basil2fxs/Hand-Rehab-Thesis/README.md

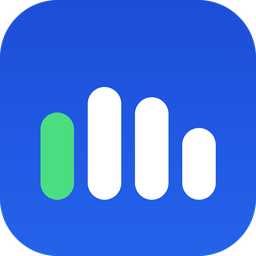
[picture p1: app/assets/icons/app_icon_256.png]
Finger Rehab icon

<h1 align="center">Finger Rehab</h1>
<p align="center">A hand device and a game for Windows and macOS that measure and train finger movement.<br>Four force pads, four vibration motors and an Arduino Nano. Ten games. Every press is logged with its time and force.</p>
<p align="center"> </p>
<p align="center"><a href="#install">Install</a> &middot; <a href="#the-ten-games">Games</a> &middot; <a href="#troubleshooting">Troubleshooting</a> &middot; <a href="#data">Data</a> &middot; <a href="#the-lab-folder">Lab folder</a> &middot; <a href="app/README.md">Working on the code</a></p>
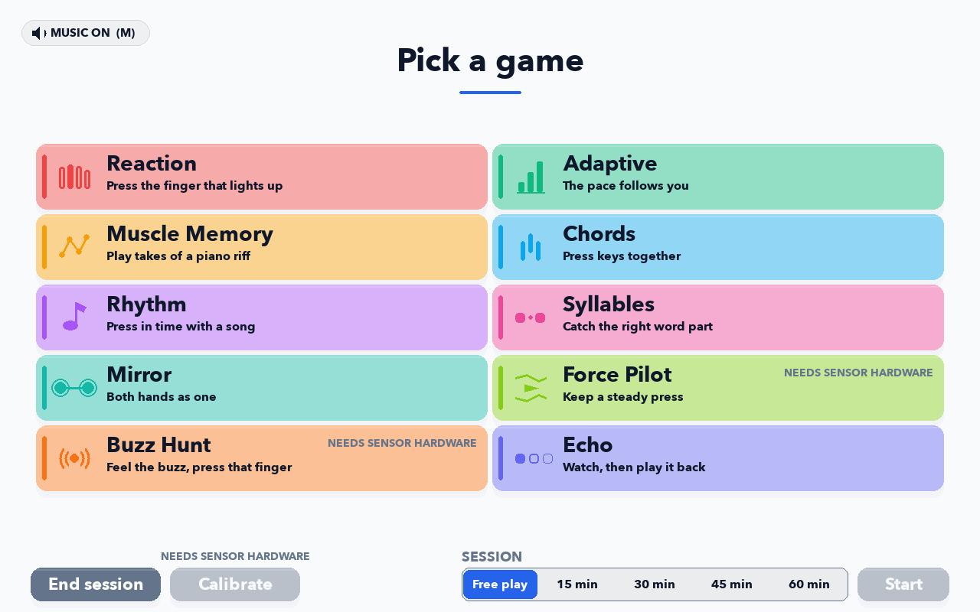
[picture p2: app/docs/images/hub.png]
The hub, where each game is picked


## Where things are

```text
Hand-Rehab-Thesis/
|
|-- Installers/               The Windows and macOS installers, from the latest release
|
|-- EEG_Lab/                  The folder that goes on the EEG lab computer
|   `-- developer/            EEG simulator and set-up tools. Not needed on the lab PC
|
|-- FINAL TRIAL RESULTS/      The study: what to run, and where each result goes
|
|-- thesis/                   The thesis and the IEEE paper, as submitted
|
|-- analysis/                 The notebook and scripts that turn sessions into results
|
|-- app/                      The game
|   |-- main.py               Starts it
|   |-- finger_rehab/         The code: games, screens, boards, data logging
|   |-- config/               Settings files (eeg_lab.yaml turns on the lab's markers)
|   |-- assets/               Board firmware, icons, music, speech and word lists
|   |-- arduino/              Source code of the board firmware
|   |-- docs/                 Study-day forms, research notes, screenshots
|   |-- scripts/              Tools run by hand: device checks, simulations, lab sync
|   |-- tests/                Automated tests
|   `-- builds/               Scripts that build the installers
|
|-- hardware/                 Build the device: parts, wiring, pins, CAD and print files
|-- archive/                  Old material kept for reference. The game doesn't use it
|-- sessions/                 Recorded data (not uploaded to GitHub)
`-- Local_Runner.command      Runs the game straight from the code on a Mac
```

Each folder has its own README with more detail. To change the software, start at [app/README.md](app/README.md), then read [app/finger_rehab](app/finger_rehab) for how the parts fit together and [app/finger_rehab/game/modes](app/finger_rehab/game/modes) for the games. The results are in [analysis](analysis) and [FINAL TRIAL RESULTS](FINAL%20TRIAL%20RESULTS), the device is in [hardware](hardware) and [app/arduino](app/arduino), and the written work is in [thesis](thesis).

## How it works

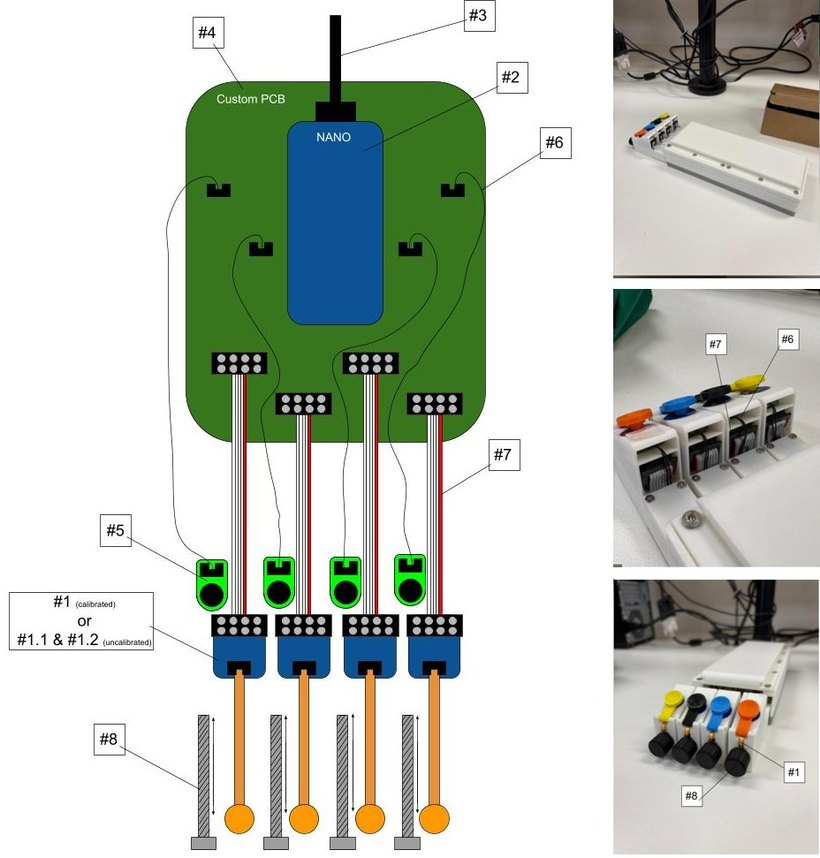
[picture p3: app/docs/images/device.jpg]
The hand device: a drawing of the board and pads, and three photos of the build
<p align="center"><br><sub>The device. Parts are numbered in <a href="app/arduino">app/arduino</a>.</sub></p>

```mermaid
flowchart LR
  H["Fingers on four pads"] --> S["SingleTact 10 N sensors<br>I2C 0x05 to 0x08"]
  S --> A["Arduino Nano<br>200 Hz"]
  A -->|"FSR: a,b,c,d"| G["The game"]
  G -->|"STIM:n"| A
  A --> M["Four vibration motors"]
  G --> F["sessions/<br>trials.csv, raw.csv, metadata.json"]
  F --> N["analysis/session_analysis.ipynb"]
```

The Nano reads the four pads 200 times a second and sends each reading over USB as a line of text. The game turns those numbers into presses, picks the next finger to cue and sends `STIM:n` back to buzz finger n. Every sample and every event goes into a session folder, which the notebook reads.

There's no switch under the fingers. Each pad keeps a slow baseline, and a press counts when the force crosses a trigger set 30% of the way from that person's resting level to their light press, both measured at login. That's what lets a weak finger register. With one fixed threshold, a little finger just resting on its pad kept setting off presses. The 30% can be changed in Settings, Setup, Press point.

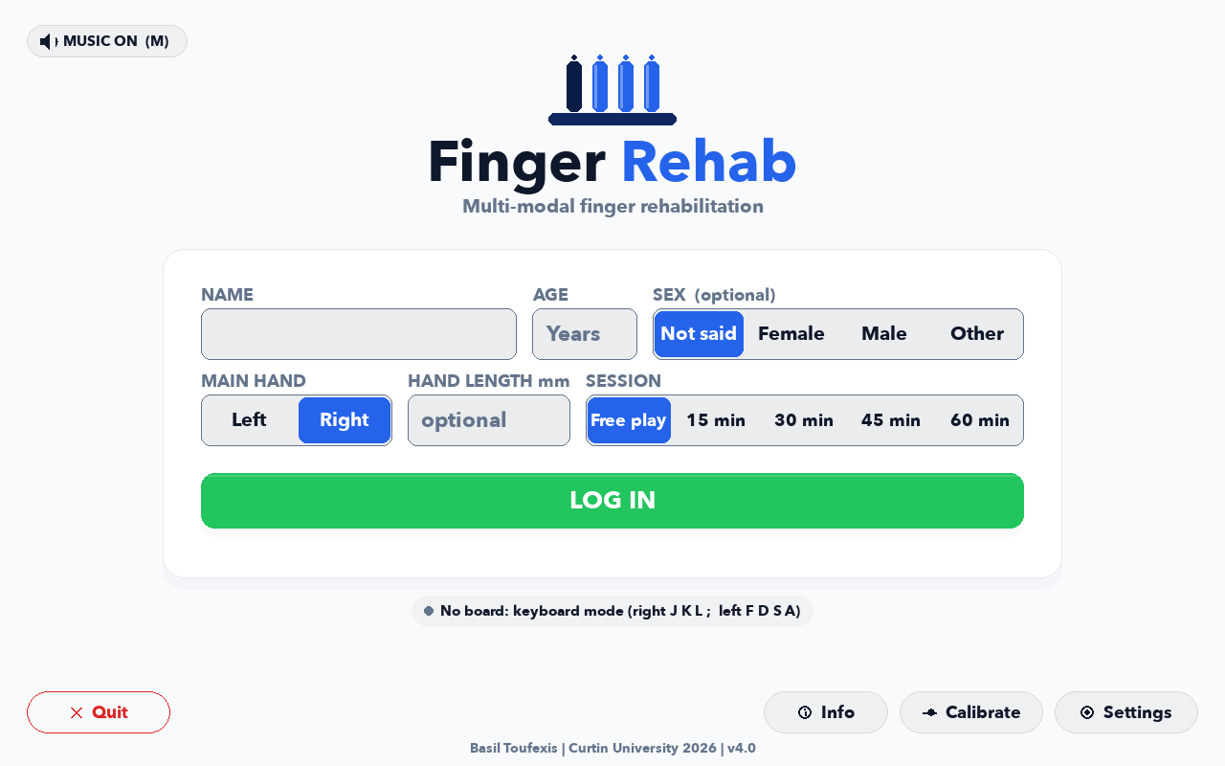
[picture p4: app/docs/images/login.png]
The login screen
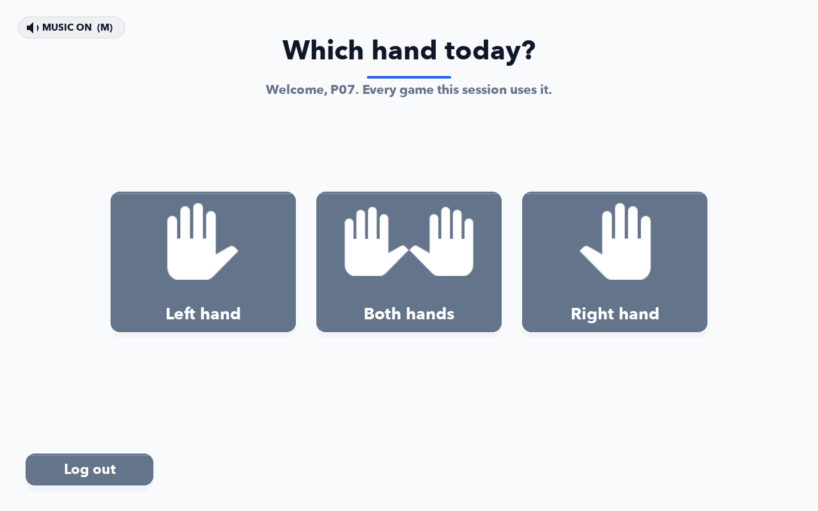
[picture p5: app/docs/images/hand.png]
The hand choice screen
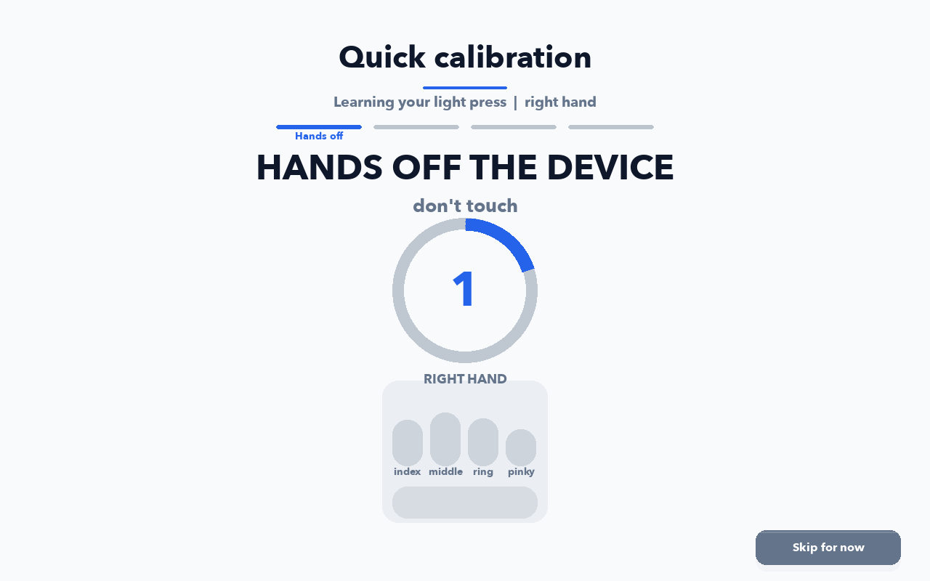
[picture p6: app/docs/images/calibration.png]
The quick calibration
<p align="center">  <br><sub>Log in (free play, or a timed session of 15 to 60 minutes), pick the hand, calibrate. The game menu has the same session picker.</sub></p>

## Timing and limits

- **Sensing:** each pad reads 0 to 10 N in 512 steps, about 20 mN a step. The Nano reads all four every 5 ms (199 Hz measured) and sends them over USB in bursts, so a sample arrives about 10 ms late, up to 20 ms; the notebook can re-time presses on the board's own clock.
- **Presses:** a press counts on the second raw sample in a row over the trigger, 5 ms after the raw force crosses it, so one noisy sample can't count. Sessions before 3 November 2026 counted on the smoothed force, a sample or two later (`analysis/count_rule_replay.py` compares the two). A slow push is counted later (`analysis/detector_lag_vs_rise.py`).
- **Screen and sound:** a cue shows on the next 60 Hz frame, up to 17 ms later. On the study computer a sound was heard 77 to 87 ms after the game played it and a buzz felt 74 ms after its command; measure each computer with Settings, Setup, Audio delay.
- **EEG markers:** a stimulus byte goes out on the frame that draws the stimulus, a press byte up to one frame after its sample, and `events.tsv` moves each press back to its sample and to where the push began. The lab checklist is in [app/docs/eeg_lab_setup.txt](app/docs/eeg_lab_setup.txt).

## Install

- **Windows:** run [`FingerRehab-Setup-Windows.exe`](https://github.com/basil2fxs/Hand-Rehab-Thesis/releases/latest/download/FingerRehab-Setup-Windows.exe). It doesn't need administrator rights. SmartScreen will say "Windows protected your PC": click More info, then Run anyway.
- **macOS:** open [`FingerRehab-macOS.dmg`](https://github.com/basil2fxs/Hand-Rehab-Thesis/releases/latest/download/FingerRehab-macOS.dmg) and drag Finger Rehab to Applications. The first time it's opened, allow it in System Settings, Privacy & Security, Open Anyway.

Neither installer is signed, which is why each one asks for permission the first time. Both are on the [latest release](https://github.com/basil2fxs/Hand-Rehab-Thesis/releases/latest), built and tested from the same commit. To run from source instead, see [app/README.md](app/README.md). If there's no board, the keyboard can be used instead: `J K L ;` for the right hand, `F D S A` for the left.

## When a board is plugged in

The game opens within a second, because a watcher installed at first launch checks the ports once a second. If the board was already plugged in when the computer started, unplug it and plug it back in. The watcher isn't installed when the game is run from source or straight off the disk image, and the lab build doesn't install it either. Once the game is open, a board plugged in at the login, on the hub or in Settings connects automatically, and one plugged in mid-game connects when that game ends.

## The ten games

<table>
<tr>
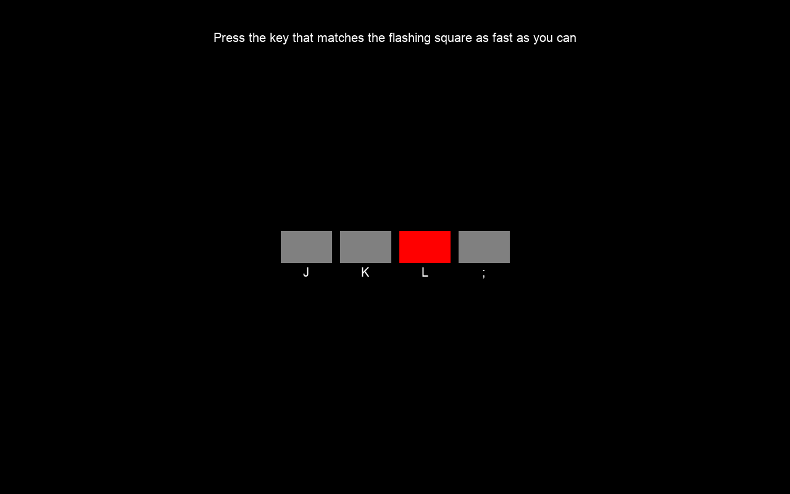
[picture p7: app/docs/images/reaction.png]
Reaction
<td align="center" width="33%"><br><sub><b>Reaction</b></sub></td>
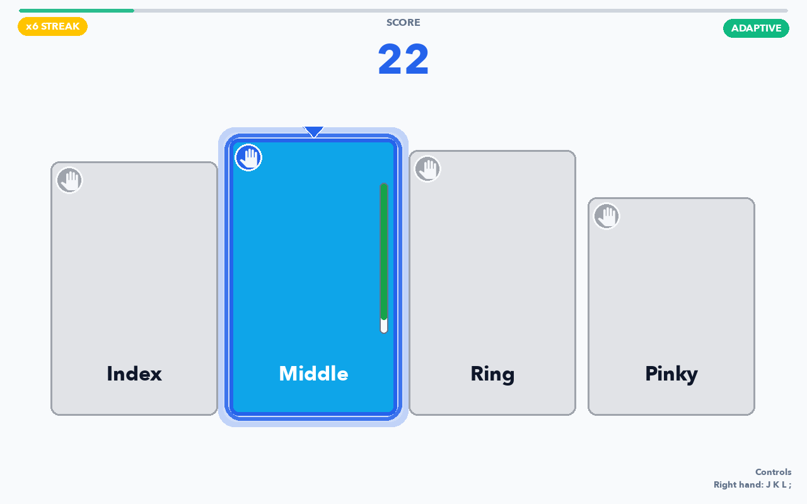
[picture p8: app/docs/images/adaptive.png]
Adaptive
<td align="center" width="33%"><br><sub><b>Adaptive</b></sub></td>
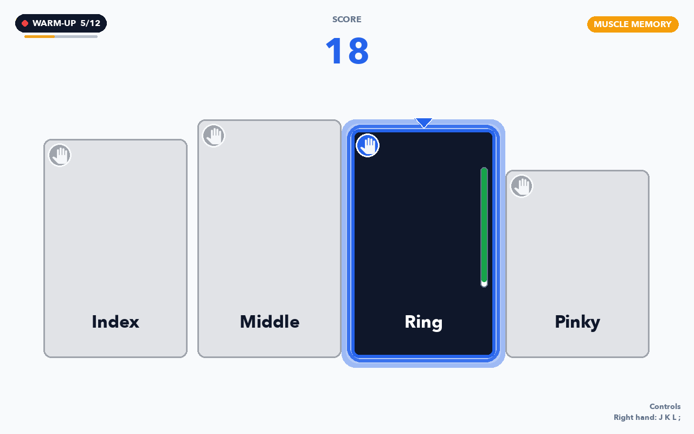
[picture p9: app/docs/images/muscle_memory.png]
Muscle Memory
<td align="center" width="33%"><br><sub><b>Muscle Memory</b></sub></td>
</tr>
<tr>
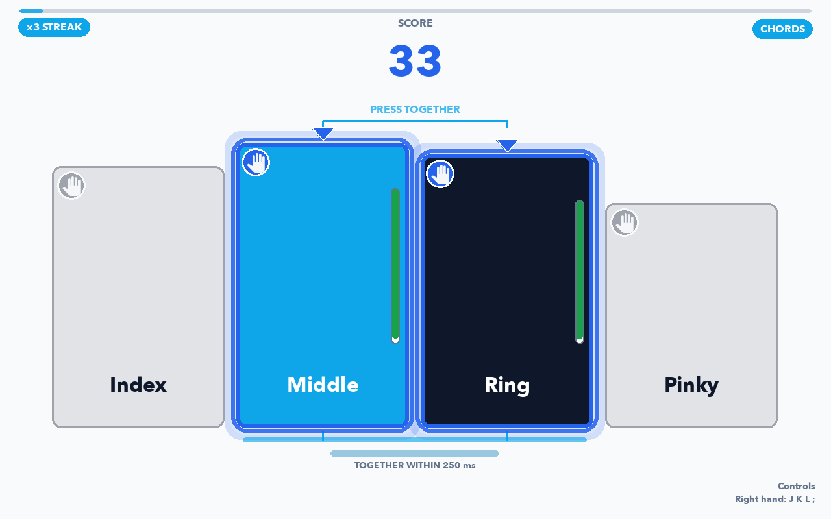
[picture p10: app/docs/images/chords.png]
Chords
<td align="center" width="33%"><br><sub><b>Chords</b></sub></td>
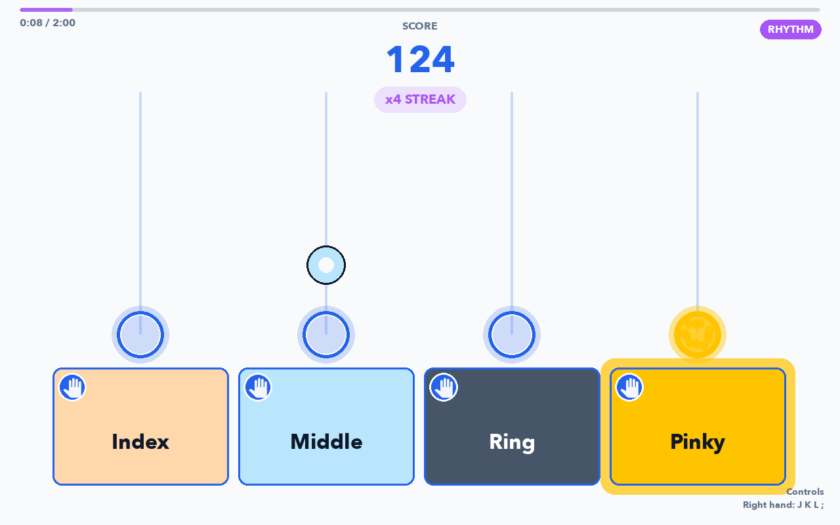
[picture p11: app/docs/images/rhythm.png]
Rhythm
<td align="center" width="33%"><br><sub><b>Rhythm</b></sub></td>
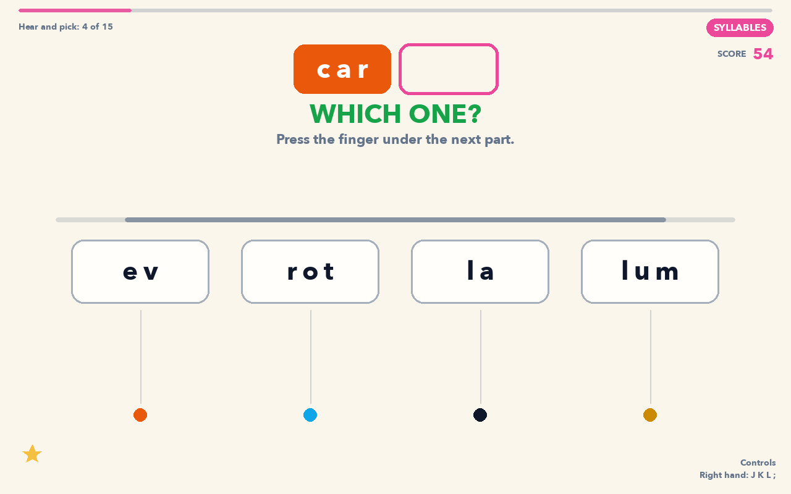
[picture p12: app/docs/images/syllables.png]
Syllables
<td align="center" width="33%"><br><sub><b>Syllables</b></sub></td>
</tr>
<tr>
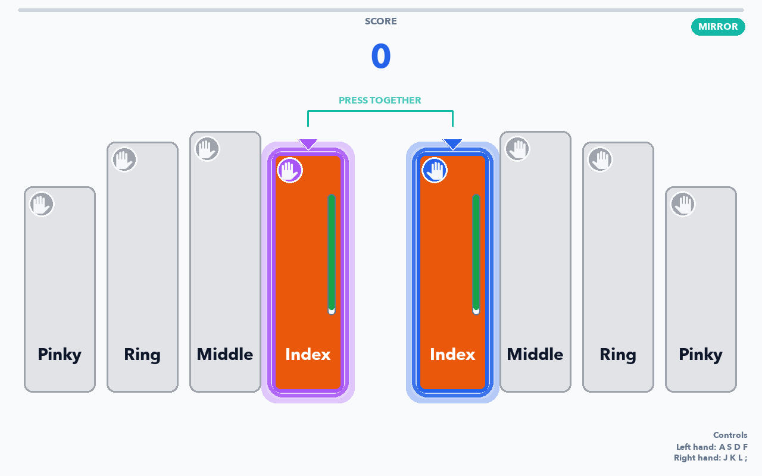
[picture p13: app/docs/images/mirror.png]
Mirror
<td align="center" width="33%"><br><sub><b>Mirror</b></sub></td>
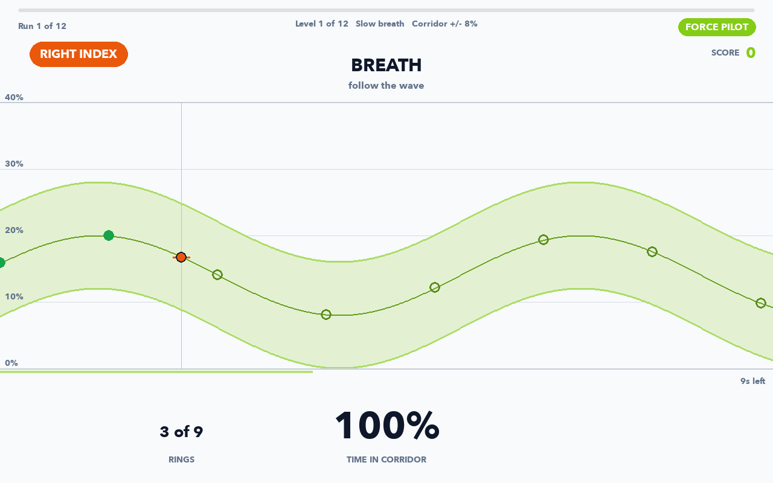
[picture p14: app/docs/images/force_pilot.png]
Force Pilot
<td align="center" width="33%"><br><sub><b>Force Pilot</b></sub></td>
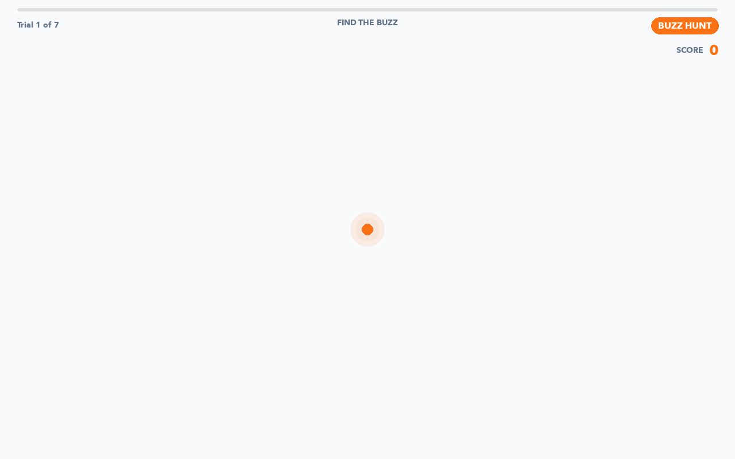
[picture p15: app/docs/images/buzz_hunt.png]
Buzz Hunt
<td align="center" width="33%"><br><sub><b>Buzz Hunt</b></sub></td>
</tr>
<tr>
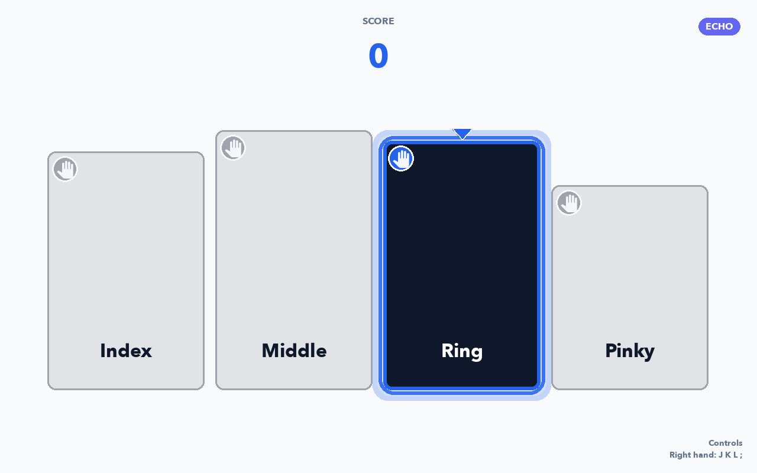
[picture p16: app/docs/images/echo.png]
Echo
<td align="center" width="33%"><br><sub><b>Echo</b></sub></td>
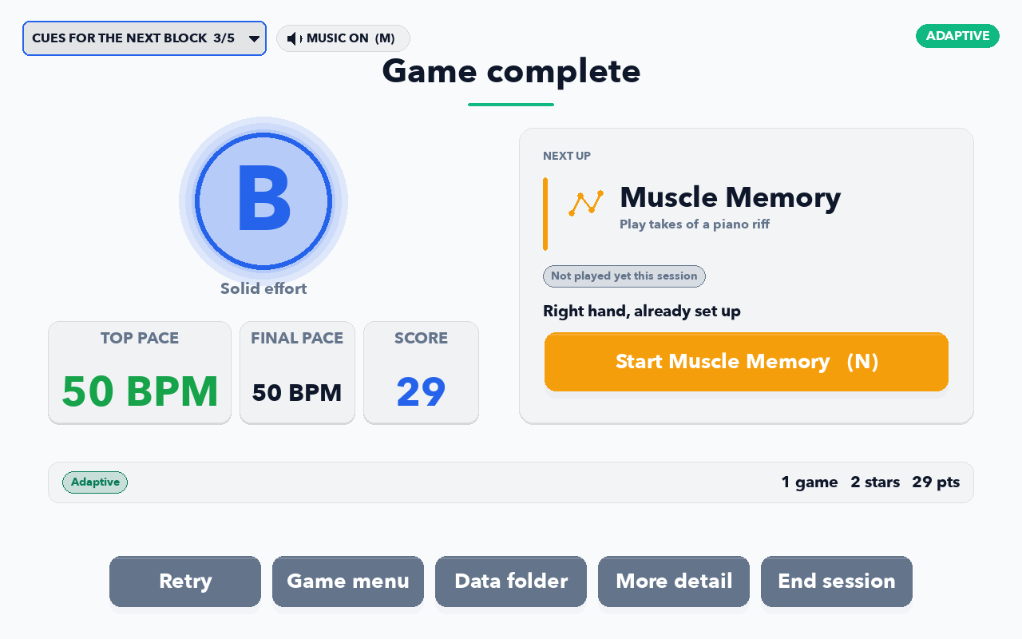
[picture p17: app/docs/images/results.png]
Results
<td align="center" width="33%"><br><sub><b>Results</b>, after every game</sub></td>
<td align="center" width="33%"></td>
</tr>
</table>

| Game | What the player does, and what it measures |
| --- | --- |
| **Reaction** | The lab's sequence task: press the finger whose card lights up. Sequence learning. |
| **Adaptive** | Press the finger whose lane lights up, at a pace that follows the player. Speed at a held difficulty. |
| **Muscle Memory** | Play a piano riff, take after take. Learning of a repeated sequence. |
| **Chords** | Press two to four fingers at once. Moving fingers together, holding the rest still. |
| **Rhythm** | Press on the beat of a song. Timing error against the beat. |
| **Syllables** | Catch the right part of a spoken word. Reading by sound. |
| **Mirror** | Press the same finger on both hands at once. How well the hands stay together. |
| **Force Pilot** | Keep a press on a moving line. Steady control of force. |
| **Buzz Hunt** | Feel which finger buzzed, then press it. The sense of touch. |
| **Echo** | Watch a sequence light up, then repeat it back. Memory span. |

Each game's file starts with the research behind it, and its settings are under its key in `app/config/default.yaml` (Muscle Memory is `pattern`, the Reaction card is `srt`). For how a game is put together and how to add one, see [app/finger_rehab/game/modes](app/finger_rehab/game/modes).

## Settings

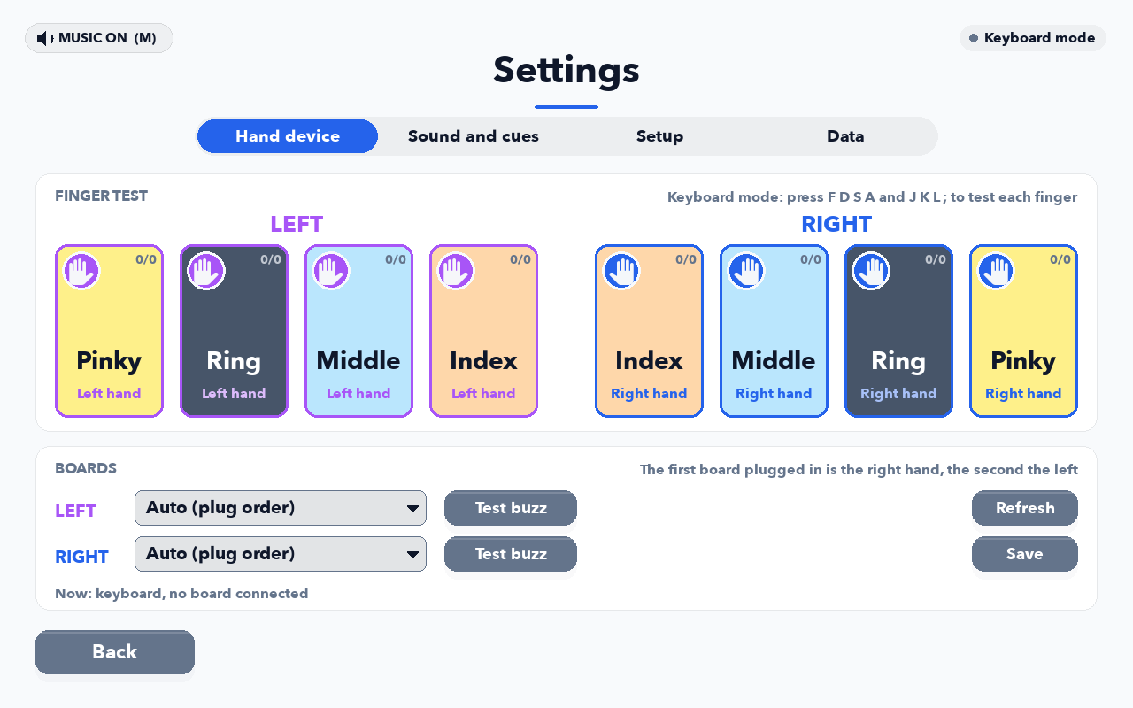
[picture p18: app/docs/images/settings.png]
The Settings screen


Open Settings with the cog on the login screen. It has four tabs: Hand device (the finger test, which board is which hand, a test buzz), Sound and cues (levels and cue switches), Setup, and Data (the data folder, the Muscle Memory riff, Test Mode). These are the Setup jobs (the flashing notes are in [app/arduino](app/arduino)):

- **Auto-start:** opens the game when the board is plugged in. The switch shows on or off, and once it's turned off the game leaves it off.
- **Flash firmware:** writes the game firmware to the board with the avrdude bundled in the app. It takes about ten seconds.
- **Sensor address:** moves one SingleTact to a new I2C address. Only that sensor should be connected while it runs.
- **Audio delay:** run it once on each computer. It times the computer's sound and buzz with the microphone so Rhythm stays on the beat. It takes about two minutes in a quiet room with the board plugged in, and on Windows it asks for taps on the index pad.

On Windows, Setup also has USB driver, which gets a board's missing driver from Windows Update. Anything changed on this screen is saved to `config/user_settings.yaml` beside the app and applied on top of `default.yaml`, which lists every setting with the reason for its value. [app/config](app/config) explains how the files are layered.

## Troubleshooting

**A sensor reads nothing, or sits at zero.** A failed read is sent as 0, so a loose lead, a dead pad and a pad on the wrong address look the same. Reseat both ends of the lead, then use Settings, Setup, Sensor address, Scan to see which addresses answer.

**A sensor drifts, or reads high at rest.** A pad squashed by the strap leaves too little room between resting and pressing, and calibration is refused when there's under 20 counts of travel. Lay the pad flat again and recalibrate.

**The board is not found, or the port keeps changing.** The first board found is used as the right hand and the second as the left. To fix a board to a hand, go to Settings, Hand device, pick the port for each hand and press Save. If a saved port no longer exists, the game goes back to plug order. On Windows, a board that never shows up at all usually has no driver yet, so run Settings, Setup, USB driver.

**Calibration is asked for every time.** It's meant to be asked for once per hand in each session. If it comes up again inside one session, the profile was refused: under 20 counts of travel, a trigger too high, or a pad reading zero when empty.

**A buzzer does not buzz.** Settings, Hand device, Test buzz runs that hand's motors one after another, and clicking a finger tile buzzes just that finger. If none of them buzz on a board that's sending readings normally, the fault is in the wiring, not the software. If there's no buzz before a cue, the cue is switched off in Sound and cues.

**Presses register on the wrong finger.** Two pads are answering on the same I2C address. Fix it in Settings, Setup, Sensor address, with only that sensor connected: 0x05 index, 0x06 middle, 0x07 ring, 0x08 pinky. Never move a sensor off 0x04 while the others are wired in.

**The game does not open when the board is plugged in.** Go to Settings, Hand device and press Refresh. If the board isn't listed, the problem is the lead or the driver (Setup, USB driver). If it is listed, check that Auto-start says on. It only triggers when a board is plugged in, so unplug the board and plug it back in.

**The board needs re-flashing.** Settings, Setup, Flash firmware writes `app/assets/firmware/finger_rehab_nano.hex` with the bundled avrdude. A Nano has one of two bootloaders, so the app tries both and remembers which one worked.

**The game runs but no data is saved.** Settings, Data, Open data folder opens the folder being used, which is `~/Finger Rehab Data` when the app can't write next to itself. Check that Test Mode is off (`game.test_mode_enabled`), because it cuts every block to six trials.

**The EEG box does not appear.** Markers are switched off in the released game. `app/config/eeg_lab.yaml` turns them on, and it's loaded from beside the lab exe or with `--config config/eeg_lab.yaml` from source. Set `eeg.port` to the box's port. If the box isn't found at launch, the game listens for a few seconds and picks the one USB port that sends no force stream, and it leaves the port list on screen in case that needs changing. With `eeg.require_port` set to true the game won't start without a box, and with false it only logs the markers. Leave `eeg.baud` at 9600: 1200 would reset the box, so the game refuses it.

**Sessions look empty in the notebook.** The notebook looks for `trials.csv` in the first `sessions` folder it finds, beside it or up to four levels above. If the notebook has been copied somewhere else, set `SESSIONS_DIR` in the Setup cell.

## Data

Each game gets its own folder, `sessions/<date>/<login>_<time>_<game>/`. Nothing is overwritten: a second folder with the same name gets `_1` on the end.

- `trials.csv`: one row per trial, with the finger cued, the reaction time, the peak force in newtons and which cue switches were on.
- `raw.csv`: every 200 Hz sample, with the presses, releases, cues and EEG markers as event rows on the same clock.
- `metadata.json`: the block summary, the calibration the block ran under, a copy of the config and the software version.
- `report.html`, `summary.csv` and `charts/` for a quick look, and for EEG blocks `events.tsv` and `markers_codes.csv`.

The folder name includes the login name, so run `app/scripts/deidentify_sessions.py` before copying any data off the computer. To analyse a session, open [`analysis/session_analysis.ipynb`](analysis), run the Setup cell, pick a save and press Run All. [app/finger_rehab](app/finger_rehab) describes every column and how the files are written.

## The lab folder

`EEG_Lab` (also released as `FingerRehab-EEGLab.zip` from the same build) contains the exe, `eeg_lab.yaml`, `run_in_psychopy.py`, `README.md`, a `source/` copy and `sessions/`. ActiView's recording goes in `sessions/eeg/` under the name shown on the game menu, and is copied in from the EEG PC when ActiView runs there. The `developer/` folder isn't needed at the lab, so leave it on the development PC: it has an EEG simulator for rehearsing, the PsychoPy download and a check for a new PC.
To start it, open `run_in_psychopy.py` in PsychoPy Coder and press Run. The markers are switched off in every other build.
`python3 app/scripts/check_lab_sync.py` checks that the lab folder has the same version of the game as the app. Adding `--fix` updates it, and `Local_Runner.command` does this every time it starts.
[EEG_Lab/README.md](EEG_Lab/README.md) has a picture showing what each marker number means, [EEG_Lab/developer](EEG_Lab/developer) explains how the folder is built and how the markers are made, and [app/docs/eeg_lab_setup.txt](app/docs/eeg_lab_setup.txt) has the checklist and code table.

## Licence

This is thesis work by Basil Toufexis at Curtin University, 2026. Please ask before reusing the code. It builds on Satoru Nakayama's 2025 software and keeps its serial protocol and press detection, so the old patient data still loads. Third-party licences are kept with the files they cover: [music](app/assets/music/ATTRIBUTION.md), [icons](app/assets/icons/LICENSE), [words](app/assets/words/LICENCE.txt), [avrdude](app/tools/avrdude).
