basil2fxs/Hand-Rehab-Thesis/app/docs/README.md

# docs

The written side of the project: how a study day runs, why each game is built the way it is, and how the EEG lab is set up. None of it is code.

| Path | What it is |
| --- | --- |
| [`study_day/`](study_day) | The collection-day kit: run sheet, consent, intake, debrief |
| [`research/`](research) | The study design and the research behind each game, with sources |
| [`eeg_lab_setup.txt`](eeg_lab_setup.txt) | The EEG lab checklist: the wiring from game to amplifier, the steps at the lab PC, the marker code table, the timing checks |
| [`code_review_2026-09-27.md`](code_review_2026-09-27.md) | The line-by-line review held before any participant: every fault it found, by game, and what it would have done to the data |
| [`pattern_sequences/`](pattern_sequences) | Example Muscle Memory sequence files; drop one on the game window to load it |
| [`images/`](images) | The pictures the READMEs show, from `scripts/make_screenshots.py` and `scripts/make_eeg_cheat_sheet.py` |
| [`Guide for Hand Rehabilitation Device.docx`](Guide%20for%20Hand%20Rehabilitation%20Device.docx) | The earlier hardware guide: wiring the SingleTact boards and setting their addresses with the Arduino IDE, a job Settings, Setup, Sensor address now does |

Flashing the board: [`../arduino`](../arduino). Building the device: [hardware](../../hardware).
