basil2fxs/Hand-Rehab-Thesis/app/docs/study_day/run_sheet.md

# Run sheet, one participant

Booked for the longest length the student can give: an hour for the
45 (75 minutes for the 60), less for the 30 or 15. About 15 minutes
of it is welcome, paperwork and debrief. Tick as you go; anything unusual goes in the
notes box on the intake sheet.

## Between participants (2 min)

- [ ] Wipe the pads and the frame with an isopropyl wipe.
- [ ] Board plugged in and the app on the title screen. On the lab
      PC, start Finger Rehab from the Start menu; on the Mac, with
      `Local_Runner.command` (double-click). Give the board about
      three seconds after it opens: it buzzes each finger once as it
      starts up.
- [ ] New intake sheet, information sheet and consent form on the
      clipboard.

## Welcome and paperwork (10 min, clock not running)

- [ ] Give the information sheet. Let them read it and ask questions.
- [ ] Consent form signed. No signature, no session.
- [ ] Assign the next code in order of consent: P01, P02 and so on.
      Write it on the intake sheet and the consent form. The code is
      the only link to their name, and the consent forms are kept
      apart from everything else.
- [ ] Intake sheet: age, sex, the four Edinburgh questions (they tick
      the boxes themselves), caffeine in the last 2 hours, hours of
      sleep, any hand pain or injury today (if yes, thank them and
      stop: they cannot take part today).
- [ ] Measure the RIGHT hand with the ruler: length from the wrist
      crease to the tip of the middle finger. Millimetres.

## Seat and log in (5 min)

- [ ] Hands washed or sanitised. Offer finger cots.
- [ ] Seat height so the forearm rests flat and the fingers sit index
      to little on the four pads, thumb off the frame.
- [ ] Say once: "This runs about three quarters of an hour, all on
      your right hand, with a short stretch early on and a proper
      break later, after which four of the games come round again.
      Press lightly, like typing. Some games have a hidden rule; don't
      try to work it out, just play."
- [ ] Say once: "After each game the screen shows how your last few
      goes compared with your first few." Don't repeat it and don't
      comment on scores during the session.
- [ ] Login screen: type the code in NAME, then age, sex and hand
      length. SESSION: the longest length the slot allows, 60 (a 75
      minute slot), 45 (an hour), then 30, then 15.
- [ ] MAIN HAND: ask "Which hand do you write with?". Right is picked
      to start with; click Left (or press L) for a left-hander. This is
      their real handedness, recorded for the analysis. It does not
      change the device.
- [ ] LOG IN. The app puts the board on the right hand, the device
      hand for everyone, left-handers included.
- [ ] Quick calibration opens by itself: hand off, hand resting, then
      one light press per finger. If a finger fails, redo it once,
      then carry on and note it.

## The session (about 44 minutes on the rig for the 45)

- [ ] The first game starts after the calibration. After each game
      press Start on the NEXT UP card (or N). The strip shows SESSION
      k/12 on the 45 and the minutes: amber past the length, red past its hard
      stop (18, 35, 50 or 65 minutes). Every length plays the same
      full-length games: the 15 four of them once, the 30 all eight
      once, the 60 every game twice (docs/research/trial_mode.md).
- [ ] The first time each game comes up, say its line once before it
      starts.
      Order A starts Reaction as soon as the calibration ends, so say
      its line as the calibration finishes.
      Reaction: "When a finger lights up and buzzes, press that finger
      as fast as you can. Sometimes nothing comes: keep still."
      Rhythm: "Press each finger as its ball reaches the ring, in time
      with the music. The buzz and the tone come at that moment, so
      don't wait for them."
      Echo: "Watch the lights, then press the same fingers in the same
      order. Each round adds one more to the end of the same pattern.
      Speed doesn't count. If you're not sure, make your best guess."
      Force Pilot: "First, three presses with each finger, as hard as
      is comfortable. Then keep your line on the centre line as the
      wave scrolls past; the band is how far you can drift." Order B
      starts the sitting with Force Pilot, so say it as the
      calibration finishes.
      Chords: "Press the lit fingers together and hold until the ring
      fills. Keep the other fingers resting still on their pads."
      Buzz Hunt: "When a finger buzzes, press that finger as fast as
      you can. Sometimes nothing buzzes: keep still. At the end the
      pads play a short pattern: when it stops, press the same fingers
      in the same order."
      Muscle Memory: "Press each finger as it lights up, as quickly and
      accurately as you can." Say nothing about a pattern or a riff.
      Adaptive: "Press the finger that lights up, before its bar runs
      out. Keep up and it speeds up; it eases off when you need it."
- [ ] Don't coach during a game. Let them skip a game's own rest
      (Space) only when they say they're ready.
- [ ] Don't pause a Rhythm game. If one pauses, Retry it from the
      results screen: the song resumes from a re-seek and its timing
      can shift, so a paused block stays out of the Rhythm checks.
- [ ] If the NEXT UP card says the audio delay is not measured, stop
      and run Settings, Setup, Audio delay before Rhythm.
- [ ] Tick each game on the intake sheet as it ends.

The order comes from the code, and every game is the right hand:

| Step | Order A (odd codes) | Order B (even codes) |
|---|---|---|
| 1 | Reaction | Force Pilot |
| 2 | Rhythm | (60 s stretch) Chords |
| 3 | Echo | Buzz Hunt |
| 4 | (60 s stretch) Force Pilot | Adaptive |
| 5 | Chords | Reaction |
| 6 | Buzz Hunt | Rhythm |
| 7 | Adaptive | Pattern |
| 8 | Pattern | Echo |
| rest | 3 minutes | 3 minutes |
| 9 | Reaction | Force Pilot |
| 10 | Rhythm | Chords |
| 11 | Force Pilot | Reaction |
| 12 | Chords | Rhythm |

Syllables is not in the sitting. It is built for readers with
dyslexia and is played with a dyslexic participant on its own, from
the hub.

### At the 3 minute rest

- [ ] Hands off the pads, water offered. Don't talk about the games.
- [ ] Ask, and write the numbers with the clock time:
      "Tired in the head?" 0 to 10.
      "Tired in the hands?" 0 to 10.
- [ ] Take the full 3 minutes. The Start button unlocks after 1 minute
      and reads "Start early"; only use it if they ask to go on, and
      write down that the rest was cut short. The reliability numbers
      are measured across this gap.
- [ ] Pass 2 is four of the games again. Don't say they are
      repeats and don't mention the first scores.

### If something goes wrong

- Board drops between games: the card says "Waiting for the board".
  Replug it, wait for the buzz, press Start. Note the step.
- Force Pilot or Buzz Hunt refuses to start: the board is not live.
  Same fix.
- Force Pilot goes straight back to the menu after MAX PRESS CHECK,
  with a note under the header: no press came in 25 seconds, so
  nothing was measured and the step is still waiting. Show a firm
  press ("as hard as is comfortable"), then
  Continue on the hub.
- Test Mode left on in Settings does not matter for a study code:
  the session switches it off for the sitting and back on afterwards.
- A game can't be run at all: Skip step (S) on the hub, confirm, and
  write the reason.
- The app closes: open it, log in with the same code, main hand and
  SESSION length. It carries on from the first game not finished;
  finished games are not played again.
- Past 50 minutes: let the current game finish, stop, write down what
  was missed. Pattern is the one to lose.
- They want to stop: stop. No reason needed. Write down where.

## End (3 min)

- [ ] The last screen shows the TODAY table. Let them read it. Answer
      questions about their own numbers only: it compares the start of
      each game with the end of the same game, a small change is not
      necessarily a real one, and nobody is being compared with other
      people.
- [ ] Ask the two tiredness questions again and write them down.
- [ ] Ask the two ratings and write them down:
      "How comfortable were the pads?" 0 to 10.
      "How clear was what each game asked of you?" 0 to 10.
- [ ] Muscle Memory check, BEFORE the debrief, for any sitting that
      played Muscle Memory (about 2 minutes). Ask: "In Muscle Memory,
      the game played in takes, did you notice anything about the
      order of the lights? If so, what?" Write the answer on the
      intake sheet. Then give them the intake sheet's 24 boxes: "Write
      24 finger numbers, 1 for index to 4 for little, in the order you
      think the lights came in that game. Guess where you're not
      sure." Don't say whether there was a pattern; the debrief does.
- [ ] End the session from the hub and confirm.
- [ ] Check the data before they leave. On the lab PC: the strip
      shows every step done; the READY check below runs later on the
      Mac, once the data is copied (FINAL TRIAL RESULTS, After each
      day). On the Mac, in Terminal, from the project folder:

      ```
      python3 app/scripts/check_sitting.py
      ```

      It reads the newest code's folders and prints OK or CHECK for:
      all 12 steps done, the passes, full counts, the rest, board
      drops, failed buzzes and the intake fields. READY on the last
      line means the sitting is complete. A CHECK tells you what to
      do; a step not finished can still be played now with Continue
      on the hub if they have time.
- [ ] Read the [debrief](debrief.md). Thank them.
- [ ] Wipe the pads and frame.
