basil2fxs/Hand-Rehab-Thesis/app/docs/study_day/intake_sheet.md

# Intake sheet

Code: P ______   Date: ____ / ____ / 2026   Start time: ____ : ____

Order (odd code A, even code B): ______   App version: ______

## About you

Age: ______   Sex: female / male / prefer not to say / other ______

Caffeine in the last 2 hours: yes / no   Hours of sleep last night: ______

Years playing a keyboard or string instrument (piano, guitar, violin
and the like), all added up: ______ (0 if none)
*(Lab session: skip it here and ask it at the end, in the SRT check: a
question about music before the SRT points at its tones.)*

Any hand, wrist or forearm pain or injury today? yes / no
*(If yes: thank them, do not continue.)*

## Which hand do you use? (Edinburgh Handedness Inventory, short form)

Tick one box per row.

| | Always left | Usually left | Both equally | Usually right | Always right |
|---|---|---|---|---|---|
| Writing | [ ] | [ ] | [ ] | [ ] | [ ] |
| Throwing | [ ] | [ ] | [ ] | [ ] | [ ] |
| Toothbrush | [ ] | [ ] | [ ] | [ ] | [ ] |
| Spoon | [ ] | [ ] | [ ] | [ ] | [ ] |

*Researcher scores it: Always left -100, Usually left -50, Both 0,
Usually right +50, Always right +100. LQ = the four added up, divided
by 4 (Veale 2014).*

LQ: ______   (61 to 100 right-handed, -60 to 60 mixed, -61 to -100
left-handed)

Main hand picked at login (the writing hand): Left / Right

## Right hand (ruler, mm)

Length, wrist crease to middle fingertip: ______ mm

## During the session (researcher)

Games finished (tick): 1 [ ] 2 [ ] 3 [ ] 4 [ ] 5 [ ] 6 [ ] 7 [ ] 8 [ ] 9 [ ]
rest [ ] 10 [ ] 11 [ ] 12 [ ]

| | Clock time | Tired in the head (0 to 10) | Tired in the hands (0 to 10) |
|---|---|---|---|
| At the rest | | | |
| At the end | | | |

At the end: comfort of the pads (0 to 10) ______   clarity of the games (0 to 10) ______

Rest cut short? no / yes, after ______ s

Calibration redone on a finger? no / yes, which: ______

## SRT check (lab session only, after the recall, before the debrief)

Ask: "Did you notice anything about the order of the lit cards? If so,
what?" Write the answer word for word.

no / yes: ________________________________________________

Years playing a keyboard or string instrument, all added up: ______

## Muscle Memory check (at the end, before the debrief)

Noticed anything about the order of the lights? no / yes: ______________

The 24 finger numbers they wrote (1 index, 2 middle, 3 ring, 4 little):

1 to 12: ___ ___ ___ ___ ___ ___ ___ ___ ___ ___ ___ ___

13 to 24: ___ ___ ___ ___ ___ ___ ___ ___ ___ ___ ___ ___

End time: ____ : ____

Notes (board drops, skipped games and why, anything unusual):

&nbsp;

&nbsp;

&nbsp;
