basil2fxs/Hand-Rehab-Thesis/app/docs/study_day/debrief.md

# Debrief (read out at the end)

Thanks for doing that. A few things I couldn't tell you beforehand:

- **The hidden rules.** In one game (the long pressing one) the
  fingers followed a repeating pattern most of the time, and a couple
  of takes switched to a different one. Getting faster on the repeat
  and slower on the switch is how the game measures learning without
  you trying to learn. In Buzz Hunt a few trials had no buzz at all,
  on purpose, to check that nobody answers when nothing happens.
- **Why four games came round again.** Playing Reaction, Rhythm,
  Force Pilot and Chords twice lets me check the device gives the
  same answer twice for the same hand, and see what a second go
  changes. That's the reliability part of the study.
- **What your numbers mean.** The screen compared the start and end of
  each game for you. That shows how you changed over a few minutes of
  practice. It doesn't show what you'd keep tomorrow, and it isn't a
  comparison with anyone else or a health assessment.
- **Left- or right-handed.** Everyone used the right hand today. If
  you're left-handed, your results help show how much the main hand
  matters on this device.

If you want your data removed, contact me with your code before the
analysis starts. Any questions?
