basil2fxs/Hand-Rehab-Thesis/app/docs/study_day/consent_form.md

# Consent form

**Finger rehabilitation device: what a healthy hand does**

Researcher: Basil Toufexis, Curtin University

Please tick each box.

- [ ] I have read the information sheet and my questions have been
      answered.
- [ ] I am 18 or older.
- [ ] I have no current hand, wrist or forearm injury or pain, no
      diagnosed condition affecting my hands, no open wound or skin
      condition on my hands, and no known sensitivity to vibration.
- [ ] I understand that taking part is voluntary and that I can stop
      at any time without giving a reason.
- [ ] I understand that my data is kept under a code, not my name, and
      that I can ask for it to be removed until the analysis starts.
- [ ] I agree to take part.

Name: ____________________________________________

Signature: _______________________________  Date: ____ / ____ / 2026

Participant code (researcher fills in): P ______

Researcher signature: ____________________________

*Keep consent forms apart from the intake sheets. This form is the
only place the name and the code meet.*
