basil2fxs/Hand-Rehab-Thesis/app/docs/research/design_check.md

# Design check: will the collection give the thesis what it needs?

28 September 2026, before any participant, for the setup as it will run: one device on the right hand with the calibrated pad set, 5 to 20 students each coming once for 15 minutes to an hour on the lab PC, supervised by Basil or a teammate, one EEG session, and a couple of readers with dyslexia seen separately. Each thesis aim against what the current setup collects, the gaps, and better options where there are any. The evidence: 12 simulated people through the real engine and the full notebook, simulated statistics at each sample size, and the sources at the end (each checked against the paper or its publisher's page).

## The answer

Every aim is covered except the sensor comparison (V4, SQ3, thesis Section 4.3). It was cut to a bench test on 28 September, since nobody plays both pad sets, and on 3 October 2026 the bench itself moved to future work (Section 4). R3 and F3, the two equivalence checks, now read the standard 90 percent interval (Section 3).

| Aim | What it needs | What the setup gives | Verdict |
| --- | --- | --- | --- |
| V1 Normal ranges (4.4) | pass 1 from everyone | every block finished in all 12 simulated sittings | Covered, as descriptive ranges |
| V2 Known effects (4.5) | pass 1 | every pre-specified check computes; 13 dropped by design, each with its reason | Covered; R3 decided (Section 3) |
| V3 Reliability (4.6) | pass 1 against pass 2 | T1 to T5 compute; Rhythm's second go is an exploratory row | Covered within one session, with wide intervals |
| V4 Sensors (4.3) | bench figures for both sensor sets | not run; `pad_bench.py --characterise` is ready for each set | **Future work** (Section 4) |
| V5 Feasibility (4.1) | minutes, blocks, rests | the feasibility chapter | Covered |
| V6 EEG markers (4.8) | the marker log against the amplifier record | the notebook audits the game's side; the amplifier side is checked by hand ([eeg_lab_setup.txt](../eeg_lab_setup.txt), "Validate once") | Covered by one lab visit |
| Handedness (4.7) | left-handers | pooled numbers and a rerun without them | Descriptive: about 1 in 10 people |
| Syllables case | one reader with dyslexia | a hub game, read by the per-session chapters and kept out of n | Covered, as a description |

The dry run: 12 simulated people through the 45 minute sitting finished 12 of 12 blocks each (42.4 to 44.4 minutes), and the notebook's ten cohort chapters wrote 54 files: validity, reliability, second goes, handedness, sensitivity, feasibility and the rest. The simulated verdicts describe a model hand and are never quoted.

## 1. How many people

The collection day sets n. What n buys, from 4,000 simulated studies per cell (two passes, the exact F interval) and the t distribution:

| n | ICC 95% interval, lower end, true ICC 0.75 | the same, true ICC 0.9 | smallest effect a check detects (dz, 80% power) |
| --- | --- | --- | --- |
| 8 | 0.17 | 0.59 | 1.16 |
| 10 | 0.28 | 0.65 | 1.00 |
| 12 | 0.33 | 0.69 | 0.89 |
| 15 | 0.41 | 0.73 | 0.78 |
| 20 | 0.46 | 0.77 | 0.66 |
| 30 | 0.53 | 0.80 | 0.53 |

The guidance asks for more than one day gives. Bonett's formula needs 24 people to hold an ICC of 0.8 to plus or minus 0.15 [1]. Koo and Li suggest at least 30, and say to read the class off the interval, not the point estimate [2]. Hopkins suggests about 50 people and three or more trials [3]. Planning on the average width also leaves a real chance of a wider interval [4]. At n = 10 a true ICC of 0.8 reads 0.38 to 0.95, across three of Koo and Li's bands, which is why the thesis compares each T row with its predicted class rather than testing it.

**Better:** book 12 so that 10 finish. A second day of 8 to 10 more makes every interval about a third narrower. Say plainly in the method that n was set by who could take part.

**At 5 to 20 students** (28 September): under 8 in the full family nothing is tested, and rightly. With 5, a two-sided signed-rank test cannot reach 5 percent at all: its smallest p is 2/32 = 0.0625. In the 12-person dry run 9 pre-specified checks carried a p value, so Holm's first threshold is 0.05/9 = 0.0056, which the one-sided exact test first gets under at 8 people (1/256 = 0.0039), and then only when nearly everyone shows the effect. Ten or more leaves room for a person or two going the other way.

## 2. Same session against another day

The two passes are twenty minutes apart, one seat, one calibration: within-session repeatability, an upper bound on day-to-day reliability [5]. The size of the gap depends on the task. For force tracking it can be large: trial-to-trial ICCs of 0.87 to 0.95 fell to 0.33 to 0.76 between days in one study [6], and less in another (0.92 to 0.98 within a day, 0.87 to 0.98 between days) [7]. For reaction time the drop was small (0.78 to 0.94 within, 0.70 to 0.94 between) [8]. For serial reaction time learning, a within-session consistency of 0.66 compares with about 0.3 between sessions [9].

**Not in this study:** each person comes once, so there is no between-day retest. The thesis already calls T1 to T5 within-session reliability. Say in the limitations that it is an upper bound on day-to-day reliability, most of all for Force Pilot, and leave a retest 2 to 7 days apart to future work.

## 3. Practice, and check R3

Most of the practice gain on a repeated computer test comes on the first repeat [10, 11]. Simple reaction time barely moves across repeats [12, 13]. Four-choice reaction time does move: 33 ms across three weekly sessions in one study [14]. So pass 2 minus pass 1 will mostly show practice, which the thesis already reads as practice.

R3 predicts no practice effect on Reaction (95% interval of pass 2 minus pass 1 inside 20 ms either way), citing a simple reaction time test [12]. Two things before the first participant:

1. The Reaction block is four-choice, the task where a second go shows practice [14]. R3 may well fail, and that is an honest result if it stays as written.
2. A 95% interval inside the margin is an equivalence test at 2.5% each side. The usual form reads the 90% interval, 5% each side [15]. At n = 10 and a true shift of 0, the chance R3 passes is 0.80 with a 90% interval against 0.61 with a 95% one, when two blocks of one person differ by 20 ms (SD); at 25 ms it is 0.52 against 0.30.

**Decided, 28 September, before any data:** R3 and F3 read the 90 percent interval, the standard form, and R3's basis names the four-choice caveat, so a fail reads as practice. The prediction and the 20 ms margin stay. At n = 10 with a true shift of zero and 20 ms (SD) between a person's two blocks, R3 now passes about 80 percent of the time instead of 60.

## 4. The sensor comparison: bench only

The thesis promises agreement between calibrated and uncalibrated sensors on six game measures, each against a margin fixed in advance, and its main question names both sensor types. Agreement on game measures needs people playing both pad sets. This study has one device, one pad set in play and one visit per person, so the comparison is the bench.

What the maker says: the calibrated and standard 10 N pads list the same resolution, linearity, hysteresis (under 4%), repeatability, drift (2% at 1 min, 4% at 10 min at half load) and response time (under 1 ms) [16]. Calibration linearises the output and holds full scale to within 2%, and a standard pad suits uses where 10% accuracy is enough [17]. So calibration buys a shared newton scale, about USD 54.50 a pad more, and nothing for drift, hysteresis or timing. That backs the thesis prediction: timing and percent-of-maximum measures agree, newtons do not. (The two pages disagree on the standard pad's linearity: under 2% on one, a 10% class on the other.)

| Way | How | What it can claim | With one device |
| --- | --- | --- | --- |
| **Bench only** | `pad_bench.py --characterise` on each pad set, no people, about 20 minutes a set: 100 g to 1 kg up and back down on every pad, then half load held for ten minutes | Counts per newton, linearity, hysteresis, noise and drift for each set: where calibration matters in newtons. Nothing about the game measures | **Fits.** Chosen on 28 September; moved to future work on 3 October |
| Split the day | the first half of the participants on one set, the rest on the other | Unpaired, about 5 a side: only large differences show | Needs a pad swap mid-day; not planned |
| A sensor pass | each person plays four blocks again on the second set, about 15 minutes more | Paired, the only way to test the thesis margins | Needs both sets in one sitting; not possible |

These three are not the thesis's options A, B and C in Section 3.7, which allocate hands. The study is that table's C, one right-hand board for everyone, except that it keeps one pad set rather than swapping sets between participants. The calibrated set is fitted for everyone. The uncalibrated set is going into a left-hand device, which may not be ready for the lab; it is benched there once that device reads. A working second device would also allow allocation A of the thesis table later: both hands, the sets swapped between sides for half the participants, the paired comparison this study cannot make.

For the thesis, SQ3 and Section 4.3 become the bench question: where calibration matters in newtons and where it does not, with the maker's figures as the prediction for the game measures. The paired analysis and its margins table go. Little is lost: at n = 10 each limit of agreement would be known only to about plus or minus 1.1 SD of the differences [18]; Bland recommends about 100 people [18], and a formal agreement claim can need hundreds [19].

3 October 2026: the bench moved to future work too, since the uncalibrated set was not in a device in time. Thesis Section 4.3 keeps the prediction and the resting noise and drift measured on 24 September 2026.

## 5. Normal ranges

Reference intervals need about 120 people [20]. A veterinary guideline that mirrors the clinical one says that below 20 no interval should be set, and that 10 to 20 values are shown one by one with the median [21]. The thesis already does this: every value, the median with its interval, the IQR and the range, no percentiles. Call them descriptive ranges for this sample.

## 6. The sittings

Each student plays the longest length their slot allows: the 60 if they can stay about 75 minutes, the 45 in an hour, then the 30, then the 15. The 45 holds: counterbalanced orders, the rest as the retest interval, pass 2 in pass 1's order, and every table filling in the dry run. The 60 holds the 45 block for block, and it adds P2 and a second go at every game. Since 2 October 2026 every length plays the study's full-length games, so all four pool: the 15 plays Reaction, Force Pilot, Chords and Adaptive once and the 30 all eight once, so with about ten students every student counts toward every check their games feed. R3 and the reliability table read the second pass, which only the 45 and the 60 play: book hour-long slots wherever the students can give them, the 30 before the 15, and no more than two students on the 15 or the 30, so every check keeps its 8 (docs/research/trial_mode.md).

## 7. The EEG lab

One EEG session is planned. It covers V6, the "Validate once" check on the first Reaction block, and gives one person's recording; a descriptive SRT learning curve would need three to five, so it is left out. Nothing in the software reads the amplifier's BDF file yet, so the Status channel comparison is done in EEGLAB or MNE by hand, as the lab note describes. A short script would make it repeatable if the lab work grows.

## 8. The Syllables case

One session per reader with no baseline is a case description, outside the single-case reporting guideline [22] and short of the design standards [23]. Since 1 October 2026 (docs/research/deep/syllables.md) every case reader's sitting opens with a fixed probe, the same sets in the same order every session, with no prompt or feedback and half its words never trained, so a reader can give an A-B series: 3 to 5 probe-only sessions on separate days, then training sessions that open with the probe; three readers started at staggered times make a multiple baseline. An A-B series is still quasi-experimental and does not meet the standards [23], and untrained dyslexic children improve over a few weeks as much as game-trained ones, so a rise is described, never put down to the game. Each reader is characterised with one published measure (the Castles and Coltheart test for a child, the Adult Reading History Questionnaire for an adult), and the probe's synthetic syllables pass a listening check first. The procedure is in `FINAL TRIAL RESULTS/README.md`. The notebook keeps the D codes out of the healthy n.

## What to change, in order

1. Done, 28 September: R3 and F3 on the 90 percent interval (Section 3); the thesis moved to the bench-only sensor comparison and the four lengths (Sections 4 and 6).
2. Book hour-long slots for as many students as the lab allows: 10 or more in the full family is the aim, and under 8 no check is tested.
3. Moved to future work, 3 October: bench each pad set with `pad_bench.py --characterise` once both are in devices (Section 4).
4. Optional: a script for the EEG Status channel check (Section 7).

## Sources

1. Bonett DG. Sample size requirements for estimating intraclass correlations with desired precision. Statistics in Medicine. 2002;21(9):1331-1335. doi:10.1002/sim.1108
2. Koo TK, Li MY. A guideline of selecting and reporting intraclass correlation coefficients for reliability research. Journal of Chiropractic Medicine. 2016;15(2):155-163. doi:10.1016/j.jcm.2016.02.012
3. Hopkins WG. Measures of reliability in sports medicine and science. Sports Medicine. 2000;30(1):1-15. doi:10.2165/00007256-200030010-00001
4. Zou GY. Sample size formulas for estimating intraclass correlation coefficients with precision and assurance. Statistics in Medicine. 2012;31(29):3972-3981. doi:10.1002/sim.5466
5. Weir JP. Quantifying test-retest reliability using the intraclass correlation coefficient and the SEM. Journal of Strength and Conditioning Research. 2005;19(1):231-240.
6. Nagasawa Y, Demura S, Nakada M. Reliability of a computerized target-pursuit system for measuring coordinated exertion of force. Perceptual and Motor Skills. 2003;96(3 Pt 2):1071-1085. doi:10.2466/pms.2003.96.3c.1071
7. Gilliam JR, Song A, Sahu PK, Silfies SP. Test-retest reliability and construct validity of trunk extensor muscle force modulation accuracy. PLoS ONE. 2023;18(8):e0289531. doi:10.1371/journal.pone.0289531
8. Zeinalzadeh A, et al. Intra- and inter-session reliability of methods for measuring reaction time in participants with and without patellofemoral pain syndrome. Archives of Bone and Joint Surgery. 2021;9(1):102-109. doi:10.22038/abjs.2020.46213.2270
9. Oliveira CM, Hayiou-Thomas ME, Henderson LM. The reliability of the serial reaction time task: meta-analysis of test-retest correlations. Royal Society Open Science. 2023;10(7):221542. doi:10.1098/rsos.221542
10. Collie A, Maruff P, Darby DG, McStephen M. The effects of practice on the cognitive test performance of neurologically normal individuals assessed at brief test-retest intervals. Journal of the International Neuropsychological Society. 2003;9(3):419-428. doi:10.1017/S1355617703930074
11. Falleti MG, Maruff P, Collie A, Darby DG. Practice effects associated with the repeated assessment of cognitive function using the CogState battery at 10-minute, one week and one month test-retest intervals. Journal of Clinical and Experimental Neuropsychology. 2006;28(7):1095-1112. doi:10.1080/13803390500205718
12. Basner M, Hermosillo E, Nasrini J, et al. Repeated administration effects on psychomotor vigilance test performance. Sleep. 2018;41(1):zsx187. doi:10.1093/sleep/zsx187
13. Woods DL, Wyma JM, Yund EW, Herron TJ. The effects of repeated testing, simulated malingering, and traumatic brain injury on high-precision measures of simple visual reaction time. Frontiers in Human Neuroscience. 2015;9:540. doi:10.3389/fnhum.2015.00540
14. Woods DL, Wyma JM, Yund EW, Herron TJ. The effects of repeated testing, simulated malingering, and traumatic brain injury on visual choice reaction time. Frontiers in Human Neuroscience. 2015;9:595. doi:10.3389/fnhum.2015.00595
15. Lakens D. Equivalence tests: a practical primer for t tests, correlations, and meta-analyses. Social Psychological and Personality Science. 2017;8(4):355-362. doi:10.1177/1948550617697177
16. SingleTact. CS8-10N calibrated and S8-10N standard 10 N sensors, product specifications. https://www.singletact.com (accessed 28 September 2026)
17. SingleTact. Calibration. https://www.singletact.com/calibration (accessed 28 September 2026)
18. Bland JM. Sample size for a study of agreement between two methods of measurement. University of York, 2004. https://www-users.york.ac.uk/~mb55/meas/sizemeth.htm
19. Lu MJ, Zhong WH, Liu YX, Miao HZ, Li YC, Ji MH. Sample size for assessing agreement between two methods of measurement by Bland-Altman method. International Journal of Biostatistics. 2016;12(2):20150039. doi:10.1515/ijb-2015-0039
20. CLSI. EP28-A3c: Defining, establishing, and verifying reference intervals in the clinical laboratory. 3rd ed. Wayne, PA: CLSI; 2010.
21. Friedrichs KR, Harr KE, Freeman KP, et al. ASVCP reference interval guidelines. Veterinary Clinical Pathology. 2012;41(4):441-453. doi:10.1111/vcp.12006
22. Tate RL, Perdices M, Rosenkoetter U, et al. The Single-Case Reporting Guideline In BEhavioural Interventions (SCRIBE) 2016 statement. Aphasiology. 2016;30(7):862-876. doi:10.1080/02687038.2016.1178022
23. Kratochwill TR, Hitchcock J, Horner RH, et al. Single-case designs technical documentation. What Works Clearinghouse; 2010.
