basil2fxs/Hand-Rehab-Thesis/app/docs/research/deep/mirror.md

# Mirror mode: deep research audit

1 October 2026. Scope: Mirror (mode key `mirror`), the two-hand game in which the same finger is cued on both hands and the pair is scored on how fast and how close together the two presses land. Files: `app/finger_rehab/game/modes/mirror.py`; the controller it borrows, `app/finger_rehab/analytics/adaptive.py` (`AdaptiveEngine`) with `app/finger_rehab/game/scheduling.py`; `begin_mirror_block`, `on_stim_multi`, `log_trial` and the block summary in `app/finger_rehab/game/engine.py`; the two-board sample path in `app/finger_rehab/hardware/multi_serial.py`, `serial_source.py`, `source.py`, `fsr_detector.py` and `calibration_profile.py`; the `mirror:`, `adaptive:`, `cue:` and `latency:` blocks of `app/config/default.yaml`; `app/tests/test_mirror_mode.py` and `app/tests/test_mirror_srt_review.py`; the notebook route (`sec_mirror` and the cohort rows) in `analysis/session_analysis.ipynb` cell 2; design document `app/docs/research/healthy_baseline_study.txt` Section 1.7 and the rows that name Mirror in Sections 4.2 to 4.7; the thesis source in the Brain (`Uni/Semester 2/Thesis/Other/Tools/Thesis build/src/*.md` and `refs.py`); the reviews `app/docs/research/new_modes/modes-review.md` (30 September 2026) and `stroke.md`.

Mirror is not played in the healthy study. Only one board exists this semester, and M1, M2 and W2 were dropped on 24 September 2026 (design doc lines 913 to 916). Everything below is written for the day a two-board rig runs it, and for the thesis text that describes it now.

Tags: [FT] full text read, with the section named; [FT, PMC page] read on PubMed Central; [ABS] abstract only; [META] bibliographic record only (where content is given for a META source it was read in a named FT secondary source). Number labels: "(arithmetic)" is computed here from source or code values; "(simulation)" is a Monte Carlo result from headless runs of verbatim copies of the shipped code (assumptions at the end of Section 7); "(pilot)" is data under `sessions/` and `app/sessions/`, which describe the rig and software, not people; "(code)" and "(design doc)" are values read in the repository. Line numbers are those of HEAD 88a6dc352fbaee14a72b14ba59b7aa6e50c1f514 with a clean working tree; notebook line numbers are lines of cell 2's source at that commit (the Mirror chapter `sec_mirror` now starts at line 30290, not near 29742).

One correction to the brief: Mirror does not use the controller's 8-lane `hands_split` path. It builds `AdaptiveEngine(num_lanes=4)` (mirror.py 131-133), leaves `hands_split` at its default False (adaptive.py 141-143) and runs its own `FloorWeightedScheduler` over finger pairs (mirror.py 280-303). The hands are equal by construction because every trial cues both.

---

## 1. What the mode does now

### 1.1 The trial loop

| Step | What happens | Value | Where |
|---|---|---|---|
| Entry | Refused on a one-board rig with "Mirror trains both hands, so it needs the second board"; skips the hand picker and forces `hand_mode` to both, rebuilding detectors and lanes | | `screens.py` `NO_SECOND_BOARD_NOTE` 1727, 1912, 2342; `engine.py` `begin_mirror_block` 5267, 5285-5293 |
| Material | Fingers from `game.pattern` (not in default.yaml, so the code default "1,2,3,4"); trials = distinct fingers times `game.repeat_count` (code default 8) | 32 trials | engine 5302, 5307; mirror.py 150-162 |
| Seed | Fresh seed per block unless `mirror.seed` is set; written to raw.csv as `mirror_config` and to the block summary | random | engine 5340-5345, 5364; default.yaml 779 |
| Finger order | Weakness-weighted pick over the four finger pairs with a 0.15 floor per finger, no finger twice running (weights from the pair's hit EMA) | `adaptive.min_finger_share` 0.15 | mirror.py 280-303; scheduling.py 240-331 (no-repeat 310-313) |
| Cue | Both copies of the finger light (grey idle tiles), a chevron over each with a shared bob and a bracket labelled PRESS TOGETHER; timing bars run on both lanes; the buzzer under each target finger runs (two boards, commands sent in lane order, right board first); one lane tone, for the lowest lane, which is the right-hand finger | all cue channels on | engine `on_stim_multi` 8692, buzz by board 8855-8900, tone 8943, one raw `stim` row per lane 8949; `screens.py` 3138-3139, `_draw_pair_bracket` 3812-3861; default.yaml 388, 398 |
| Window | 0.90 of 60/BPM, checked each frame; both hands must press inside it | 2.25 s at the 24 BPM start, 5.4 s at the 10 BPM floor, 0.50 s at 108 BPM (arithmetic) | mirror.py 180-188, 268-274; adaptive.py 456-461 |
| Rest | Next cue fires once the previous trial has closed and min(60/BPM, 1.0 s) has passed since it closed | 1.0 s at every pace up to 60 BPM | mirror.py 250, 262-267 |
| Response | First press on each target lane is kept (duplicates ignored); a press on any other lane is a wrong finger (Miss, 3 points off each); a press with no trial open is an idle press (1 point off) | | mirror.py 324-362; engine 8157, 8178; default.yaml 739, 749 |
| Close | When both hands are in, or the window ends | | mirror.py 360-362, 272-274 |
| Scoring | RT = the LATER press; classify() tiers; a Perfect (100 ms or under) is paid as Great; a pair more than 350 ms apart is a Miss (`error_type` async); a wrong finger makes the trial a Miss | `mirror.max_async_ms` 350 | mirror.py 380-442; default.yaml 769-774 |
| Controller update | `adapter.record(finger, hit, later RT, quality)` then `next_bpm()`; then the engine's rule enters recovery on the third miss in a row (minus 25 BPM, 70 percent of picks on the strongest pair) and leaves it on any hit | quality Perfect/Great 1.0, Good 0.75, Late 0.25 | mirror.py 371-378, 448-453; engine `_update_streak` 8524, `_recovery_threshold` 283; adaptive.py 173-180, 499-509 |
| Block end | When 32 trials have closed | | mirror.py 277-278 |

What "BPM" means here (code, arithmetic): because the rest is measured from the close of the trial and capped at 1 s, BPM sets the press window and, above 60 BPM only, the rest. At the 24 BPM start a cue follows the previous one by roughly the later press plus 1.0 s, about 1.5 s with a 0.5 s press (arithmetic), not the 2.5 s the engine comment states (engine 5325-5328). The pace is a deadline parameter, not a cue rate.

### 1.2 The controller underneath

The controller is Adaptive's, unchanged; `docs/research/deep/adaptive.md` Sections 1.2 and Q3 to Q6 describe it. What differs for Mirror:

- Config: `begin_mirror_block` reads only the `adaptive.*` keys for target band, bounds, step, weakness bias and `min_trials` (engine 5316-5324), plus `mirror.start_bpm` 24 (5329), `mirror.max_async_ms` (5358) and `mirror.seed`. The comment above it ("Mirror gets its own adaptive config ... Falls back to the regular adaptive.* keys", 5312-5315) is not what the code does. `adaptive.timeout_factor` (default.yaml 694) is read for Adaptive (engine 5211-5212) but not for Mirror, which uses the dataclass default 0.90 (adaptive.py 119); the values match today.
- The hit signal is the pair: both hands inside the window, no wrong finger, gap 350 ms or less. The RT the controller sees is the later press.
- Mirror has none of the rules Adaptive adopted on 1 October 2026: no `carry_ms` late-press credit, no sub-100 ms "not a response" rule (`ANTICIPATION_MS`, adaptive mode 238-249), no device-drop guard (adaptive mode `_source_dropped`), no per-trial `adaptive_state` raw event and no `block_stats()`.
- Simulated healthy blocks (simulation, base cohort of 500): hit rate median 0.88 (10th to 90th percentile 0.78 to 0.97); peak pace median 108 BPM (81 to 123); mean pace over the last 10 trials 88 BPM (78 to 116); block 41 s (35 to 47).

### 1.3 Scoring, screen and instructions

- Points: tier of the later press (Great 6, Good 3, Late 1, Perfect capped to Great), times max(1, BPM/60) and a streak multiplier up to 1.5 (engine `_pace_multiplier` 8115, `_streak_multiplier` 8140, `_score_for` 8149); minus 3 per wrong press, minus 1 per idle press. Synchrony earns nothing below the 350 ms gate; it only decides pass or fail (code).
- Screen: hub card "Mirror, Both hands as one" (`screens.py` 1536); no GET READY instruction line (`GET_READY_LINES` 3743-3767 covers echo, chords, pattern and adaptive only); during play the bracket and PRESS TOGETHER label, no hand divider (3405-3425); outcome popups from `ui/feedback_bank.py` with no Mirror-specific line (a gated pair gets the generic "miss" wording); streak banners at 10, 20, 30, 50, 75 and 100 in a row (engine 8514-8522; Mirror is not in `_QUIET_STREAK_MODES`).
- Results: SYNC GAP (the block's mean absolute gap) as headline, then score and hits; More detail adds hit rate and each hand's mean RT (`screens.py` `SLIM_CARDS` 7006, 7433-7454).
- Spoken or run-sheet instruction: none (the run sheet has no Mirror line, since the battery does not play it).

### 1.4 Logging and block summary

- trials.csv: `time_difference_ms` (later press), `mirror_right_rt_ms`, `mirror_left_rt_ms` (each hand's own latency), `correct_keys` with both lanes, `bpm_at_trial` and `in_recovery` snapshotted at the cue, `timeout_ms` (the window) (engine 8774, 9428-9433, 9488). `error_type` is async for a gated pair, wrong_finger for a fumble and timeout for any other Miss, including a trial where one hand pressed (engine row construction after 9396). `peak_force_n` and `impulse_n` come from the right-hand lane only (engine 9279), so the left hand's force is never on the row.
- raw.csv: `mirror_config` (seed), one `stim` row per lane, every press and release with its lane and stamp (engine `_on_press` 557-577), keyboard presses tagged keyboard (mirror.py 237-241), and every merged sample with ONE stamp (engine 2518).
- Block summary, `mirror` section (engine 6021-6048): `seed`, `mean_gap_ms` (mean absolute gap over clean pairs, gated pairs included, one-sided trials excluded), `n_clean_pairs` (alias `n_synced_hits`), `right_hand_mean_rt_ms`, `left_hand_mean_rt_ms`; plus `bpm_min`, `bpm_max`, `bpm_final`. `asymmetry_index` for RT and peak force is None for every Mirror block, because both per-lane lists are keyed on the right lane (engine 6365-6402; the pilot block shows None).

### 1.5 The timing path with two boards

| Link | What the code does | Where |
|---|---|---|
| Sample stamp | Each board's line is stamped with `perf_counter()` when its reader thread parses it | source.py 83-84; serial_source.py 384-392 (read of whatever is waiting since 24 September) |
| Pairing | The merger keeps only the LATEST sample per board; when both are present and within 50 ms it emits one 8-value sample stamped `max(t_right, t_left)`; a board silent for 50 ms is emitted alone with the other hand's values set to zero | multi_serial.py 282-342 (keep-latest 318-325), 344-383 (`t = max(tr, tl)` 360) |
| Detection | Both hands' detectors are fed the merged sample with its single stamp; value EMA 0.35 per sample, trigger at about 30 percent of each pad's calibrated rest-to-press gap | engine `_feed_detectors` 591; fsr_detector.py 78, 299; calibration_profile.py 50 |
| Logging | raw.csv keeps the merged stamp only; no per-board stamp or sample counter survives | engine 2518 |
| Re-timing | The notebook's `sample_grid_lateness` and `press_timing` (cell 2, 9181-9279) fit one board's sample grid; `sec_mirror` does not call them | notebook |
| Keyboard path | Presses are stamped when the frame loop handles the event; the loop is capped at 120 fps | engine 1062 |

### 1.6 Registered checks and the notebook route

- Design doc Section 1.7 (912-937): primary `mirror.mean_gap_ms`, `n_clean_pairs`, hit rate and the two hands' mean RTs; M1 "mean gap well under the 350 ms gate, expected under about 60 ms. Descriptive with CI" citing Kelso, Southard and Goodman 1979; M2 "dominant-hand press leads", flagged as having no verified direction; reliability "unknown for this device; predicted moderate"; claim limits on the changing pace and on efficacy. Section 4.2 (2092-2093) lists mean_gap_ms, hit_rate, rt_dominant_ms, rt_nondominant_ms. Section 4.4 (2187) makes M2 one-sided. Section 4.5b lists Mirror under "Clean, because the task is frozen" (2296-2298). Section 4.6 lists W2 "the right-minus-left onset gap narrows" (2500-2501). Section 4.7 figure 4 uses the "right-minus-left onset gap per clean pair" (2587).
- `sec_mirror` (30290-30436): clean pairs by `_mirror_clean_mask` (22113: both latencies, no wrong finger); M1 printed as "mean gap, median [bootstrap interval of the median]" and scored pass if the MEAN is under 60 ms (30331-30341); M2 compares the dominant and non-dominant hands' mean RTs with `diff_ci` (10204), which resamples the two hands independently (30343-30365); M3 prints the BPM range; a histogram and a signed trial-by-trial plot; median gap per finger; mean latency per hand.
- Cohort (two-board tree only): `_cohort_mirror` (22134) emits the engine's `mean_gap_ms`, hit rate and per-hand mean RT; in `sec_cohort_validity` (26792) M1 is `_mean_check(... "mean_gap_ms" ... 60.0, "<")`, a t interval whose upper end must clear 60 (27060-27062), and M2 is `_paired_check(... "less")`, a one-sided Wilcoxon on dominant minus non-dominant mean RT that enters the Holm family (27063-27065); W2 is `_within_block_row` on the absolute gap's first-third and last-third medians (27425-27427, series at 24020-24027). Rows need 8 people (`COHORT_MIN_N`, 21395). `COHORT_WITHIN_BLOCK_READING["mirror"]` is "clean, the task is frozen for the whole block" (31974). On a one-board tree M1, M2 and W2 print as DROPPED (`COHORT_ONE_BOARD_DROPPED` 25572, rows 25584-25589).
- `MODE_LIT["mirror"]` (28310-28338) and `MODE_CLAIM_LIMITS["mirror"]` (28914-28943); literature list entries 16203-16209 and 16297-16300.
- Also: `sec_bilateral`'s Mirror readout (6030-6086) and `sec_inter_hand` (6260), whose best-lag correlation runs on merged-stream stamps.

### 1.7 What is already claimed, and the sources cited

| Claim | Where | Source cited | Status after this review |
|---|---|---|---|
| Mirror is mirror-free bilateral synchronous training "in the Whitall 2000 (BATRAC) / Cauraugh and Summers lineage" | mirror.py 10-11; `MODE_CLAIM_LIMITS` 28915-28919 | Whitall 2000; Cauraugh and Summers | Partly. It fits the Cochrane definition of simultaneous bilateral training (Coupar et al. 2010 [FT]). BATRAC is metronome-paced push and pull of the whole arm in and out of phase (Luft et al. 2004; Whitall et al. 2011 [FT]); Cauraugh's coupled protocols are wrist and finger extension with EMG-triggered stimulation (Cauraugh et al. 2010 [FT]). Mirror is a cued, discrete, in-phase finger press (Q1) |
| Ramachandran and Rogers-Ramachandran 1996 and Altschuler 1999 are the origin of the idea that "the unaffected hand can drag the affected one along via shared motor representations" | mirror.py 12-17; thesis 01_intro.md 35 | same | Not supported. In the 1996 paper a patient making mirror-symmetric movements with his eyes shut felt the phantom stay frozen, and movement returned only when he looked in the mirror (FT). The drag-along idea is the bilateral-training rationale (McCombe Waller and Whitall 2008 [FT]; Cauraugh and Summers 2005 [ABS]) (Q1) |
| The efficacy literature is contested; "the Cauraugh 2009/2010 meta-analysis is not settled" | mirror.py 18-21; `MODE_CLAIM_LIMITS` 28921-28926; design 936-937 | Cauraugh 2010; van Delden 2012 | Understated. The Cochrane review and overview find no benefit over usual care and moderate-quality evidence that one-arm training may be better (Coupar et al. 2010; Pollock et al. 2014 [FT]); RCTs found BATRAC not superior (Whitall et al. 2011 [FT]; van Delden et al. 2013 [ABS]) (Q1) |
| "350 ms sits comfortably above normal bimanual asynchrony (tens of ms)" | mirror.py 146-148; default.yaml 769-774 | none | Supported: healthy absolute inter-hand intervals of 18.5 to 24 ms (Bonzano et al. 2008, 2013 [FT]); 0.4 percent of simulated healthy trials gated (simulation) (Q5) |
| M1: "expected under about 60 ms" | design 921-925; `MODE_LIT` M1; thesis 03b_study.md 88 (cites kelso1984) | Kelso, Southard and Goodman 1979; thesis: Kelso 1984 | Direction supported; the number has no source and Kelso 1984 is continuous oscillation. Passes in 98.5 to 100 percent of simulated cohorts on every rig model, so it is a rig check (Q2, Q7) |
| M2: the dominant hand's press leads | design 926-932; `MODE_LIT` M2 | Peters 1980; Hubel et al. 2013 | No direction is supported for discrete presses (Q2); Peters and Hubel measured one-hand tapping speed. A board offset of the size the merger can produce decides the row (Q7) |
| "Two boards stamp their presses independently, about 7 ms of mean absolute difference from their bursts alone, so gaps under about 10 ms are not resolved without re-timing" | design 930-932; `MODE_CLAIM_LIMITS` 28932-28934; modes-review device facts | arithmetic | Not what the code does: one stamp per merged pair, keep-latest pairing, no per-board record (Section 1.5). With smooth boards the gap error SD is 2.7 ms; with two bursting boards 8.4 ms and 43 percent of samples dropped; a bursting board beside a smooth one gives a 9 ms bias (simulation); no re-timing path exists for merged streams (Q4) |
| "A tighter gap at a slower pace is not a tighter hand" | `MODE_CLAIM_LIMITS` 28935-28937 | design 1.7 | The pace effect is real, but it runs the other way: a faster pace drops wide pairs as one-sided misses, so the mean gap is 25.0 ms under the shipped climb against 30.5 ms at a frozen 24 BPM (simulation) (Q6) |
| Mirror's within-block series is "clean, the task is frozen for the whole block" | design 2296-2298; notebook 31974 | none | Wrong: the window shrinks as the pace climbs (code). The practical bias on W2 is small (Q7) |
| "Mirror starts slower than adaptive (24 BPM = 2.5 s gap vs adaptive's 30 BPM = 2 s)" | engine 5325-5328; default.yaml 762-767 | none | The window is longer (2.25 against 1.8 s), but cues come about 1.5 s apart because the rest is capped at 1 s from the trial's close (code, arithmetic) |
| `begin_mirror_block` docstring "Mirror therapy mode" | engine 5268 | none | Misnamed (Q1) |
| "biases the next finger pick toward the weaker side" | mirror.py 28-29 | none | The bias is per finger pair; the two hands are equal by construction (mirror.py 284-285) |
| "the software calculates asymmetry measures for reaction time and peak force" (beside "Mirror mode forms the main bilateral training activity") | thesis 03a_system.md 97 | none | True for a two-hand block of another mode; None for every Mirror block (Section 1.4) |
| "Pairs outside 50 ms rejected, latency logged per port" | thesis 08_appendices.md 123 | none | Unpaired samples are emitted with the other hand zero-filled, not rejected; the per-port latency is time to first sample only (multi_serial.py 371-383; `get_startup_latency` 411) |
| Thieme et al. reported "small to moderate improvements in motor function for people with chronic stroke" | thesis 02_lit.md 33 | Thieme 2018 | Partly: the review covers all stages (SMD 0.47); the chronic subgroup is 0.43; against the same movements with both hands visible the effect was not significant (FT) (Q1) |
| "Cauraugh and Summers show that training both hands ... may help promote motor recovery by engaging both sides of the brain" | thesis 02_lit.md 35 | Cauraugh and Summers 2005 | Overstated: the paper is a review that proposes three mechanisms ([ABS]) |
| Whitall et al. found gains after six weeks of BATRAC, still present eight weeks later | thesis 02_lit.md 37 | Whitall 2000 | Accurate, but it was an uncontrolled pilot of 14 ([ABS]); the 111-person RCT found BATRAC not superior to dose-matched exercise (Whitall et al. 2011 [FT]) |
| "when both hands move rhythmically, moving matching fingers together is the stable pattern, so healthy hands should press very close together in time" | thesis 02_lit.md 37 | Kelso 1984 | The stability claim is right for continuous movement ([ABS]); the inference for discrete presses needs Kelso et al. 1979 ([ABS]) and the finger data of Bonzano et al. ([FT]) |
| "balasubramanian2025" authors E. Balasubramanian, B. Sivakumar, S. K. M. Varadhan | thesis 02_lit.md 39; refs.py 170 | | Crossref lists the authors as B. Eswari, S. Balasubramanian and S. K. M. Varadhan [META] |

### 1.8 Pilot data on disk (rig check only)

- One Mirror block has trial rows: `sessions/2026-09-29/ff_095955_mirror`, KeyboardOnlySource, abandoned after 4 trials and a pause. Gaps 16.6, 8.2, 8.4 and 8.3 ms (mean 10.4 ms), which are 2, 1, 1 and 1 frames of the 120 fps loop (arithmetic from engine 1062), so the keyboard path resolves a gap only to 8.3 ms. Later-press RTs 534 to 967 ms, every trial in the Late tier; pace 24 to 27 BPM; window 2,250 to 2,001 ms (pilot).
- `app/sessions/2026-09-29/NA_100318_mirror` has no trials; the 25 archived Mirror folders under `archive/old_test_sessions/` are all keyboard sessions with no trial rows (pilot).
- No Mirror block has ever run on two boards. The only two-board recordings (`sessions/2026-08-06`, four one-hand blocks under software 3.2) read zero on every left pad and delivered samples in packets of 4 every 20.4 ms (median; 20.1 to 21.3 ms, 5th to 95th percentile) (pilot).
- The serial read change of 24 September is visible: a one-board block at 01:02 on 24 September (port usbserial-310) still arrived in 20 ms packets, while blocks on 25 September on ports usbserial-130 and -140 delivered a sample every 5.1 ms (median; 99th percentile 7.1 to 7.7 ms) (pilot).

---

## 2. Research questions and findings

### Q1. What is the mode, and what may the thesis claim from the bilateral-training and mirror-therapy literature?

- Definition. Cochrane defines simultaneous bilateral training as a motor activity completed by both upper limbs at the same time but independently (Coupar et al. 2010, Methods [FT, PMC page]). Mirror meets it: the same finger is cued on both hands, both hands are visible and there is no mirror (code).
- BATRAC. Four 5-minute bouts per one-hour session, three a week for six weeks, pushing and pulling two T-bar handles in phase or alternately to a metronome at individually set rates of 0.67 to 0.97 Hz (Luft et al. 2004, Methods [FT, PMC author manuscript]). The pilot of 14 people a median 30 months after stroke had no control group and reported gains on Fugl-Meyer, Wolf time and arm use that largely held at 8 weeks (Whitall et al. 2000 [ABS]). In the randomised substudy of 21, functional outcomes did not differ between BATRAC and dose-matched exercise; the within-group Fugl-Meyer gain of 12 percent in BATRAC was not different from the control group's (Luft et al. 2004, Results and Discussion [FT]). In the 111-person RCT the gains were comparable (Fugl-Meyer change 1.1 against 1.9 points for dose-matched exercise), BATRAC was not superior, and neither change reached the 10 percent of the scale the authors used as clinically significant (Whitall et al. 2011, Abstract and Discussion [FT, PMC author manuscript]). Ten percent of the 66-point upper-limb Fugl-Meyer is 6.6 points (arithmetic).
- Meta-analyses that disagree. Cauraugh et al. (2010) pooled 25 comparisons from 366 patients: SMD 0.734 (95 percent CI 0.489 to 0.979), I2 63 percent, with the largest effects for BATRAC (0.842) and coupled bilateral movement with EMG-triggered stimulation of the wrist and finger extensors (1.142). Controls ranged from unilateral training to placebo stimulation, one outcome was taken per study with kinematic or EMG measures used when no clinical scale was reported, 8 of 25 comparisons did not describe randomisation, and the authors' own funnel plot showed possible bias (Methods, Results [FT, PMC author manuscript]). A published response from the Cochrane authors followed (Pollock et al. 2011 [META]). van Delden et al. (2012) point out that the two positive meta-analyses pooled outcomes from all levels of the ICF with kinematics and compared bilateral training with a mixture of controls or none; their own nine RCTs (452 patients) found the two approaches similarly effective, with a marginal effect favouring unilateral training in chronic mild paresis (SMD 0.34, 0.04 to 0.63) (Introduction, Results [FT]).
- The Cochrane review: 18 studies (549 participants). Against usual care, ADL SMD 0.25 (-0.14 to 0.63), arm function -0.07, hand function -0.04; against other arm interventions, ADL -0.25 (-0.57 to 0.08), arm -0.20, hand -0.21; four of the included trials trained wrist and finger extension (Coupar et al. 2010, Abstract and included studies [FT]). The Cochrane overview found moderate-quality evidence that unilateral arm training may be more effective than bilateral (6 trials, 375 people) and concluded the evidence does not support bilateral training as a replacement for unilateral training (Pollock et al. 2014, Abstract and summary table [FT, PMC page]). Two other syntheses agree: no significant effect of bilateral arm training on any outcome in 22 RCTs, 823 people (Veerbeek et al. 2014, section 5 [FT]); "similar or inferior" in 23 RCTs, 1,104 people, and not recommended (Hatem et al. 2016, Bilateral training [FT]). One later meta-analysis found a 2.21-point Fugl-Meyer advantage (0.12 to 4.30, I2 86 percent) but no difference in function (SMD 0.25, -0.02 to 0.52) (Chen et al. 2019, Abstract [FT]); 2.21 points is a third of 6.6 (arithmetic).
- The closest trials to finger training: modified BATRAC aimed at wrist and finger extensors was not superior to dose-matched conventional therapy in 60 patients 1 to 6 months after stroke (van Delden et al. 2013 [ABS]), and the coupling between the hands did not change more after bilateral than after unilateral training (van Delden et al. 2015 [ABS]).
- Priming. Active-passive bilateral therapy (the unaffected wrist drives the affected one through a device, as described in Cauraugh et al. 2010 [FT]) for 10 to 15 minutes before practice gave better arm function a month later in 32 chronic patients (Stinear et al. 2008 [ABS]); device-assisted mirror-symmetric movement before physiotherapy made 57 subacute patients three times as likely to reach their recovery plateau by 12 weeks (Stinear et al. 2014 [ABS]). Both are passive or device-assisted priming, not an active press task.
- Mirror therapy. The 1996 paper studied ten arm amputees in a mirror box. Patient D.S., making mirror-symmetric movements with his eyes shut, felt the phantom stay frozen; when he looked in the mirror he felt it move. The authors considered that motor commands and feedback from the intact arm might reach the other hemisphere through the corpus callosum and concluded this information was not sufficient on its own; stroke appears as a possible implication in the last paragraph (Ramachandran and Rogers-Ramachandran 1996, Summary, mirror-box method, section (e), conclusions [FT]). The first stroke study was a crossover in which bilateral movements were made with a mirror or with transparent plastic between the limbs (Altschuler et al. 1999 [META]; design as tabulated in Thieme et al. 2018 [FT]). Thieme et al. (2018) pooled 62 studies (1,982 participants): motor function SMD 0.47 (0.27 to 0.67), with subacute (0.45) and chronic (0.43, 0.06 to 0.81) subgroups. When the control group made the same movements with an unrestricted view of both limbs, the effect was not significant (SMD 0.27, -0.05 to 0.59; 14 studies, 474 people) (Abstract, Comparisons 3 and 4 [FT, PMC page]). Seven RCTs gave non-significant effects in another synthesis (Veerbeek et al. 2014, section 9 [FT]), while Hatem et al. (2016) rated mirror therapy superior to bimanual and symmetric training [FT]. The sources conflict on the size of the mirror effect; none of them attributes that effect to bilateral movement made without the mirror.
- Who might benefit. McCombe Waller and Whitall (2008) argue bilateral retraining is needed for bilateral tasks, that benefit depends on severity, and that the non-paretic arm is commonly slowed in bilateral movement ([FT, PMC author manuscript], Sections 1 and 2).

Bearing. The thesis may say that Mirror delivers simultaneous bilateral practice of homologous fingers and measures the timing between the hands. It may not call the mode mirror therapy, borrow mirror-therapy effect sizes (Mirror is the "unrestricted view" control those trials beat by an amount that was not significant), cite Ramachandran 1996 for interlimb coupling, or describe bilateral training as effective: the best syntheses find it no better than usual care or one-arm training.

### Q2. What does healthy bimanual timing look like, which hand leads, and what do cues and feedback do?

- Stability. When hands oscillate faster, the anti-phase pattern switches to the in-phase pattern with simultaneous activation of homologous muscles (Kelso 1984 [ABS]; modelled by Haken, Kelso and Bunz 1985 [META]). This is continuous movement.
- Discrete movements. After an auditory go signal, two-handed reaches to targets of very different difficulty start and end together, with peak velocity and acceleration almost synchronous (Kelso, Southard and Goodman 1979, both papers [ABS]). The coupling replicates with ordinary feedback but integrated Lissajous feedback lets people decouple the hands (Shea, Boyle and Kovacs 2012 [ABS]). In 19 adults aged 18 to 23, mean signed lags at movement onset and peak speed stayed within 12 ms of zero in every condition and hand side was never a significant factor; at movement end the absolute lag was 67 ms (same-sized targets) and 106 ms (different sizes), with the attended hand arriving first (Sardar et al. 2023, Results [FT, PMC page]). Removing visual feedback increased synchrony (Miller and Smyth 2012 [ABS]). For discrete simultaneous EMG reaction times, synchronisation errors were smaller for homologous than non-homologous pairings (Nakamura, Sajiki and Taniguchi 1977 [ABS]); bimanual responses to a single go signal are grouped on nearly every trial (Miller and Ulrich 2008 [ABS]).
- Finger-level gaps. Ten healthy adults (26 to 47 years) making paced bimanual finger opposition with eyes closed, timed by a glove at 1 kHz, had a mean absolute inter-hand onset interval of 24.0, 21.8 and 18.5 ms at 1, 1.5 and 2 Hz (SE 4.5, 2.5 and 2.3, so between-person SD about 7 to 14 ms, arithmetic), with no difference between dominant and non-dominant hands in the single-hand measures; people with MS were near double (Bonzano et al. 2008, Methods and Results [FT, PMC page]). In 80 healthy adults the same interval was 18.87 ms (SE 0.87) against 41.92 ms in MS, and the log interval had a between-person SD of 0.45 (Bonzano et al. 2013, Results and Table 1 [FT]); the 10th to 90th percentile spread that implies is a factor of about 3.2 (arithmetic).
- Signed asynchrony in tapping. In 27 right-handed students tapping both index fingers every 400 ms, the group mean between-hand phase difference was -0.7 ms (SD 4.95 ms across people), a minuscule left lead; the largest individual mean was 12.1 ms and the median absolute individual mean 3.9 ms; the authors saw no a priori reason for one hand to lead (Helmuth and Ivry 1996, Experiment 1 [FT]).
- Which hand leads. Continuous ellipse tracing and forearm rotation: the dominant hand leads by about 25 ms at any speed (Stucchi and Viviani 1993; Viviani et al. 1998 [ABS]); rhythmic bimanual Fitts tapping: preferred-hand lead (Amazeen, Ringenbach and Amazeen 2005 [ABS]); circle drawing: lead depends on direction and mode, and dominance does not generally decide it (Franz, Rowse and Ballantine 2002 [ABS]). Discrete bimanual reaction time: 40 right-handers and 40 left-handers to a central visual stimulus, dominant-hand RT faster on average, more dominant-led trials in right-handers than left-handers with similar absolute differences, and the conclusion that dominance does not generally determine the lead (Shen and Franz 2005 [ABS]); index-finger force pulses to a finger stimulus gave significant right-left differences within people, in both directions across people (Kaluzny, Palmeri and Wiesendanger 1994 [ABS]); a bimanual RT cost for the right index finger in 12 right-handers (Taniguchi et al. 2001 [ABS]). In unimanual RT the two hands of 32 right-handers did not differ, and the literature the authors review splits three ways, with equal latencies most common (Nisiyama and Ribeiro-do-Valle 2014, Introduction and Results [FT]).
- Bimanual cost. With same-sized targets, bimanual reaches started 29 to 46 ms later than unimanual ones (445 and 419 ms unimanual against 491 and 448 ms bimanual) (Sardar et al. 2023, Table 1 [FT]); in a simple task bimanual RTs were shorter than unimanual and in a choice task longer (Nisiyama and Ribeiro-do-Valle 2014 [FT]).
- Cues, instructions and feedback. Adding auditory feedback to each tap reduced timing variability and removing it from one hand reduced the bimanual advantage (Drewing and Aschersleben 2003 [ABS]); asynchrony between the thumbs of 36 right-handers was larger when told to react "as strongly as possible" than "as quickly as possible", and smaller in women (Gutnik, Hudson and Nicholson 2009 [ABS]); gaze leads the hand it is on (Sardar et al. 2023 [FT]); force rise times and amplitudes of two index-finger pulses are correlated, with temporal control dominating (Rinkenauer, Ulrich and Wing 2001 [ABS]).

Bearing. M1's direction is well supported, but its 60 ms bound is about three times the healthy absolute gap measured with a 1 kHz system, so it cannot fail for a working rig. Kelso et al. 1979 and Bonzano et al. 2008 and 2013 are the right anchors, not Kelso 1984. For M2 the literature gives no stable direction for discrete presses: a 25 ms dominant lead appears in continuous rotation only, tapping shows -0.7 ms, and discrete RT shows individual leads both ways. A group lead, if any, should be expected under about 10 ms.

### Q3. What happens to between-hand timing after stroke, and what could a gap measure show in patients?

- Coupling persists but bends toward the slower limb. In 16 chronic patients reaching with both arms at once, the two arms did not differ in movement time or peak velocity, and the paretic arm was fastest when moving with the other (McCombe Waller et al. 2006 [ABS]). In 30 chronic patients the non-paretic arm lengthened its movement (10 percent lower peak velocity) so both hands hit the targets together in 81 percent of trials, while the paretic arm sped up 4 percent (Rose and Winstein 2005 [ABS]). Bilateral elbow flexion lengthened RT and movement time in both arms of 25 patients (Dickstein et al. 1993 [ABS]). The expected direction of coupling is from the slower, paretic limb to the faster one, and entrainment of the paretic limb has rarely been verified (Sleimen-Malkoun et al. 2011, sections on discrete tasks and coupling [FT]).
- Coupling strength. Weaker after stroke, with spatial coupling affected more than temporal, detectable in mild hemiparesis (Rose and Winstein 2013 [ABS]); mildly impaired synchrony in reasonably strong patients (Kilbreath et al. 2006 [ABS]); dominance effects altered by the side of the lesion (Lewis and Byblow 2004 [ABS]); patients locked into in-phase 1:1 patterns (Rice and Newell 2004 [ABS]); training did not change coupling differently (van Delden et al. 2015 [ABS]); bimanual coordination is under-measured in rehabilitation (Kantak, Jax and Wittenberg 2017 [ABS]).
- Force. In bimanual wrist and finger extension the less-impaired hand's force lags the impaired hand's and the two are less coordinated (Lodha, Coombes and Cauraugh 2012 [ABS]); bimanual force variability is higher after stroke and asymmetric, the paretic hand more variable in 78 to 89 percent of patients (Kang and Cauraugh 2014, Results [FT]).
- Mirror movements. During paretic-hand squeezing, involuntary movements of the unaffected hand were found in 70 to 78 percent of 23 patients (Nelles et al. 1998 [ABS]).
- A gap measure in another disease. The absolute inter-hand interval doubled in MS, discriminated patients with very low disability from healthy adults, correlated with disability (r 0.56) and with callosal integrity (Bonzano et al. 2008, 2013 [FT]).
- What the shipped rules do with asymmetric hands (simulation, illustration only, Section 7): a left hand 60 ms later with a 60 ms gap SD gives a median gap of 62 ms and no gated trials; 200 ms later with 150 ms SD gates 16 percent of trials and drives the pace to the 10 BPM floor at some point; 400 ms later with 250 ms SD gates 56 percent, the hit rate falls to 0.41, the pace stays between 10 and 24 BPM and 19 percent of trials are cued in recovery.

Bearing. In a patient study the gap could separate patients from healthy adults and track severity cross-sectionally, but a smaller gap can mean the faster hand waited, so it has to be read beside each hand's RT against its own one-hand RT. Change with training is unproven. The fixed 350 ms gate with a controller that can only slow the pace cannot make the task easier on the dimension a hemiparetic pair fails.

### Q4. How well do two boards resolve a gap?

- What the code does (Section 1.5): both hands of a merged sample carry the later board's arrival stamp; the merger keeps only each board's latest sample, so a board that delivers samples in packets loses all but the last of each packet whenever the other board has not yet delivered; raw.csv keeps one stamp per pair, so neither the per-board stamps nor any per-board sample count can be recovered later.
- Simulation with the shipped merger and detector (verbatim code, 600 press pairs per case, true gap SD 25 ms):

| Case | Stamp lateness, right / left, mean (SD) | Gap error mean, SD | Mean absolute error | 95th percentile absolute | Gaps exactly 0 | Samples dropped |
|---|---|---|---|---|---|---|
| Each hand on its own board's stamps, smooth delivery (no merger) | 13.9 (1.6) / 13.9 (1.7) ms | -0.02, 2.3 ms | 1.9 ms | 4.3 ms | 0 | 0 |
| Same, both boards in 20 ms packets (no merger) | 23.1 (5.7) / 22.7 (5.9) ms | +0.38, 8.1 ms | 6.6 ms | 15.2 ms | 0 | 0 |
| Shipped merger, smooth delivery | 14.7 (1.9) / 14.8 (1.8) ms | -0.07, 2.7 ms | 2.1 ms | 5.1 ms | 7 percent | 0.9 percent |
| Shipped merger, both in packets | 35.3 (6.6) / 36.1 (7.0) ms | -0.78, 8.4 ms | 6.2 ms | 18.1 ms | 10 percent | 43 percent |
| Shipped merger, right in packets, left smooth | 33.4 (5.3) / 24.4 (4.9) ms | +9.0, 7.4 ms | 9.8 ms | 21.0 ms | 10 percent | 50 percent |

  Within one session the packet phase between two bursting boards is fixed, so each 30-pair session carries its own bias: SD 4.9 ms across sessions (range -10.0 to +5.4 ms), against 0.5 ms for smooth boards (simulation). The second row reproduces the design note's "about 7 ms" (6.6 ms), but only without the merger.
- Pilot: the current read path delivers a sample every 5.1 ms on two ports (25 September); a port still burst on 24 September at 01:02 (Section 1.8). Smooth delivery is likely on today's software but has not been checked for two boards at once.
- Thresholds. Each pad triggers at about 30 percent of its own calibrated rest-to-press gap (calibration_profile.py 50), so the same press on two pads crosses the two triggers at different times. With a linear rise the offset is rise time times trigger difference over amplitude: triggers of 30 and 39 counts (calibration gaps of 100 and 130 counts) shift the onset by 5.1 ms for a press rising 140 counts in 80 ms and 13.5 ms for 80 counts in 120 ms; triggers of 30 and 48 counts shift it 10.3 to 27.0 ms (arithmetic). One count is 0.0195 N (modes-review device facts).
- Cue side. STIM commands go to the right board first (engine 8858) and each board adds its own firmware loop of 0 to 5 ms (default.yaml 1780-1786); motors differ in lag (PMD 8 mm parts 20 to 29 ms, default.yaml 1787-1789), and the only measured figure is one command-to-motion lag of 74 ms on the study board (modes-review device facts); no second board's motors have been measured. A hand that answers its own buzz inherits the difference.
- Hand-to-board assignment follows plug order unless a port is pinned (multi_serial.py docstring; `discovery.resolve_assignment`), so for a right-handed cohort a fixed board difference is confounded with dominance.

Bearing. With smooth boards and the shipped merger, a single gap is resolved to within about 5 ms either way (95 percent) and there is no session bias, which is better than the design note says. With packet delivery the merger loses close to half the samples and adds a session-specific bias of several ms; with one bursting board the bias is 9 ms and systematic. Threshold and motor differences between boards can add 5 to 27 ms. None of this can be undone from the files the app writes today, so per-board stamps must be logged and the inter-board offset measured on the bench before any Mirror number is reported.

### Q5. The synchrony gate, what counts as a clean pair, and the scoring

- Gate: fixed at 350 ms whatever the pace (mirror.py 140-149, 423-442). Healthy hands: 0.4 percent of trials gated, all from simulated ungrouped responses (simulation). Asymmetric hands: 16 and 56 percent gated in the moderate and marked illustrations (Q3).
- Clean pair: both hands' presses logged and no wrong finger (engine 9259-9274; notebook 22113). Gated pairs stay in the gap, so the gate does not censor it (engine 6021-6033). One-sided trials, where the window closed before the second hand pressed, are excluded; they are the widest pairs, so the window censors the gap (Q6). The second hand's press is still in raw.csv as a `press` event (engine 557-577).
- Error types: a one-sided Miss is logged as `timeout` although one hand pressed (engine row construction), against the comment in mirror.py 478-482 that only a no-press Miss should be a timeout.
- Score: the tier comes from the later press, so a 5 ms pair and a 300 ms pair with the same later press earn the same points; synchrony is pass or fail at 350 ms (code). A press that misses the window is charged as an idle press when it arrives: 5.8 idle-press charges per simulated healthy 32-trial block (simulation).
- Perfect cap: a sub-100 ms later press is paid as Great because the rest is a deterministic function of BPM and the notebook drops presses under 100 ms (mirror.py 404-422; notebook `ANTICIPATION_MS` 1625). Consistent with Reaction and Adaptive, but a single hand's press under 100 ms still counts as that hand's press and as a full-quality hit.

Bearing. The gate is well placed for healthy adults and nearly inert. The scoring rewards the speed of the slower hand, not togetherness, which is acceptable for a measurement block but means the game never tells a player how close the pair was. One-sided trials hide the widest pairs and can be recovered from raw.csv.

### Q6. The adaptive cadence underneath, late presses, sub-100 ms presses and per-hand weighting

- The pace moves the window from 2.25 s to about 0.5 s in a healthy block (simulation, peak median 108 BPM). As the window tightens, pairs whose second press is late become one-sided misses: 1.2 per block under the shipped climb against none at a frozen 24 BPM. The mean absolute gap is 25.0 ms under the climb against 30.5 ms frozen (median gap 19.1 against 20.5 ms; 10 percent trimmed mean 20.9 against 22.5 ms) (simulation). The engine's mean exceeds the block median by more than 10 ms in 16 percent of shipped blocks and 38 percent of frozen ones (simulation).
- Late presses: a press on the previous trial's finger within 150 ms of a new cue occurred on 0.06 percent of simulated trials, because the rest after each trial is at least min(60/BPM, 1 s) (simulation, code). Mirror does not need Adaptive's `carry_ms`; its late presses become idle-press charges instead (Q5).
- Sub-100 ms presses: none in the simulation (no anticipation was modelled); with the finger unpredictable among three, a correct guess pays one time in three (arithmetic). Sharing Reaction's and Adaptive's rule keeps the modes consistent.
- Device drop: a press-less close while a board is down is voided in the row by the engine (engine 9179-9197), but Mirror has already fed it to the controller as a miss (mirror.py 448-453), so a one-board drop drives the pace down and into recovery. Adaptive guards against this; Mirror does not.
- Per-hand weighting: the weakness bias is per finger pair, from pair hits; a pair failing because one hand is weak is cued more, but nothing targets a hand; in recovery 70 percent of picks go to the best pair (code).

Bearing. "Report bpm_min and bpm_max" is the right instinct, but in Mirror the pace is a deadline, and the window it sets censors the gap in the opposite direction to the claim limit's wording. Report the window in ms and the count of one-sided trials beside every gap. Add the device-drop guard; the late-press credit is not needed.

### Q7. What could M1, M2 and W2 decide at n = 5 to 20 on a two-board rig?

- Under 8 people no row is decided (`COHORT_MIN_N` 8 at 21395; `_mean_check` and `_paired_check` return "n under the design minimum").
- M1 (cohort mean of per-person mean gap, t interval upper end below 60 ms): passed in 98.5 to 100 percent of simulated cohorts of 8, 10 and 20 for smooth boards, bursting boards and a 9 ms mixed-pair bias; the 95 percent range of a cohort mean of 10 was 19.5 to 29.5 ms (simulation). It is a rig feasibility check, like A5, A6 and C1.
- M2 (one-sided Wilcoxon, dominant minus non-dominant mean RT, unadjusted alpha 0.05; between-person SD of the difference about 11 ms):

| True dominant lead | Board offset (right board stamps later) | n = 8 | n = 10 | n = 15 | n = 20 |
|---|---|---|---|---|---|
| 0 ms | 0 | 0.05 | 0.05 | 0.05 | 0.06 |
| 5 ms | 0 | 0.29 | 0.36 | 0.57 | 0.67 |
| 10 ms | 0 | 0.71 | 0.82 | 0.97 | 0.99 |
| 25 ms | 0 | 1.00 | 1.00 | 1.00 | 1.00 |
| 0 ms | +9 ms | 0.00 | 0.00 | 0.00 | 0.00 |
| 0 ms | -9 ms | 0.74 | 0.82 | 0.96 | 0.99 |
| 10 ms | +9 ms | 0.05 | 0.06 | 0.07 | 0.07 |

  (simulation, all participants right-handed). A board offset the merger can produce erases a 10 ms lead or creates one from nothing. M2 is also in the Holm family: at n = 8 the smallest exact one-sided Wilcoxon p is 1/256 = 0.0039, above 0.05/13 = 0.0038, so with 13 or more tested rows it cannot pass as the first step (arithmetic).
- W2 (paired t interval of last-third minus first-third median absolute gap entirely below 0): with no learning, 3.1 percent of cohorts of 10 and 4.4 percent of cohorts of 20 pass under the shipped climb, against 2.5 and 2.1 percent at a frozen pace, mean change -0.7 against +0.1 ms (simulation). The per-person change has an SD of 10.4 ms, so a true narrowing of 5 ms is detected 28 percent of the time at n = 10 and 54 percent at n = 20, and 10 ms 78 and 98 percent (simulation, arithmetic). No source predicts any narrowing within 32 trials of an already stable in-phase task, and the game gives no feedback on the gap.

Bearing. M1 checks the rig, not the hands. M2 cannot be decided without a bench-measured inter-board offset, boards swapped between hands across participants, and a direction the literature does not supply; it belongs with Rh3 and C5 as a reported two-sided contrast. W2 is honest under the null but has little power and no expected effect; it should be descriptive.

### Q8. Reliability, the right summaries, and how many trials

- External anchor: the absolute inter-hand interval had a one-month ICC of 0.75 for one 60 s trial (about 120 touches) and 0.86 for the mean of two, in 27 healthy adults (Bonzano et al. 2013, Methods and Table 1 [FT]), so it rests on about four times as many events as a 32-pair Mirror block; Koo and Li's bands call that moderate to good (Koo and Li 2016, interpretation [FT]).
- If people did not differ in coupling, absolute-gap summaries would carry almost no between-person signal (ICC 0.01 to 0.16 in simulation): the folded normal mean is 0.80 of the signed SD and the median 0.67, and a person's small bias barely moves either (arithmetic). Differences between people in coupling (Bonzano's log SD 0.45) are what make the gap reliable, and low between-person variance is what makes classic tasks unreliable for individual differences, with difference scores especially exposed (Hedge, Powell and Sumner 2018, Abstract and section on difference scores [FT]).
- Two independent blocks per person, people differing in coupling (log SD 0.40), ICC(2,1) (simulation):

| Summary | 16 trials | 32 trials (shipped), smooth boards | 32 trials, bursting boards | 64 trials | 32 trials, no ungrouped pairs |
|---|---|---|---|---|---|
| mean absolute gap (engine `mean_gap_ms`) | 0.31 | 0.59 | 0.57 | 0.80 | 0.85 |
| median absolute gap | 0.57 | 0.74 | 0.71 | 0.85 | 0.74 |
| 10 percent trimmed mean | 0.69 | 0.82 | 0.80 | 0.91 | 0.82 |
| mean log gap | 0.62 | 0.74 | 0.72 | 0.85 | 0.78 |
| share of pairs within 50 ms | 0.61 | 0.80 | 0.76 | 0.88 | 0.82 |
| signed mean (right minus left) | 0.23 | 0.43 | 0.49 | 0.70 | 0.70 |
| signed median | 0.47 | 0.59 | 0.54 | 0.76 | 0.59 |
| SD of the signed gap | 0.03 | 0.15 | 0.13 | 0.26 | 0.88 |
| pace over the last 10 trials | 0.36 | 0.70 | 0.63 | 0.71 | 0.71 |

- The engine's mean is the most fragile summary because one ungrouped pair (2 percent of trials in the model, delayed 150 to 700 ms) adds 5 to 23 ms, 14 ms on average, to a 30-pair mean (arithmetic); trimming or the median removes that. Block-to-block change in the median gap with no real change: SD 8.7, 6.3 and 4.2 ms at 16, 32 and 64 trials, so 1.96 times that is 17, 12 and 8 ms (simulation, arithmetic).

Bearing. "Predicted moderate" holds for the engine's mean; the median or a 10 percent trimmed mean is good at 32 trials. Use the median absolute gap (or the trimmed mean) as the headline, the share within 50 ms as a bounded description, the signed median for direction and keep `mean_gap_ms` for continuity with its outlier note. 32 trials is enough for a description; 64 trials would make the gap a good individual measure.

### Q9. What the notebook does with a Mirror block, and what it should do

- The per-selection M2 interval treats the two hands' latencies as independent samples (`diff_ci`, notebook 10204). They come from the same trials and share most of their variance, so in simulated blocks the interval is 63 to 64 ms wide against 18 to 19 ms for a paired bootstrap of per-trial signed gaps; a 10 ms lead lies outside the interval in 4 percent of single blocks with `diff_ci` and 52 percent with the paired interval, a 25 ms lead in 24 against 88 percent (simulation).
- The per-selection M1 prints the bootstrap interval of the median but scores the mean (30331-30341).
- The cohort M1 and M2 use the engine's mean gap and the difference of the hands' mean RTs (`_cohort_mirror` 22134), the two most outlier-sensitive summaries (Q8).
- `COHORT_WITHIN_BLOCK_READING["mirror"]` (31974) and design Section 4.5b call the task frozen; design Section 4.6 and 4.7 describe a signed "right-minus-left" series while the code uses the absolute gap (24020-24027, 25419-25428).
- The M3 row reports BPM (30373-30384), which in Mirror is a window setting (Q6).
- One-sided trials are counted and excluded but never recovered, though raw.csv holds the second press.
- The per-finger median gap rests on as few as 5 pairs per finger (floor 0.15 of 32, arithmetic) and mixes finger with pad-pair trigger differences and with the distance between the two lit tiles, which grows from the index (centre) to the little finger (screen edges) (`screens.py` 2848-2875, 2914-2935).
- `sec_inter_hand` (6260) finds the best-lag correlation on merged stamps, which cannot resolve a lead shorter than the pairing error (Q4).

Bearing. Fix the M2 interval, put M1's criterion and interval on the same statistic, add median, trimmed and share-within summaries, recover the one-sided trials, report the window, and correct the "clean" reading. All are analysis changes on data that do not exist yet.

### Q10. Instructions, feedback, rewards and safety for a hemiparetic hand

- Instructions set how people trade force, speed and synchrony: telling people to react strongly widened the asynchrony between the thumbs compared with telling them to react quickly (Gutnik, Hudson and Nicholson 2009 [ABS]); verbal instructions and payoffs set the speed-accuracy balance (as reviewed in `docs/research/deep/adaptive.md` Q11). Mirror has no GET READY line, so the only instruction is the PRESS TOGETHER label, while the score pays speed.
- Feedback: a gated pair shows the generic "miss" wording, which names neither hand nor the direction; the feedback bank's own rules ask for the direction ("behind", "ahead of") and the next action (`feedback_bank.py` docstring R2, R3). The trained quantity, the gap, appears only on the results screen.
- Attention and vision move the lead (Sardar et al. 2023 [FT]; Miller and Smyth 2012 [ABS]); the two lit tiles are close together for the index finger and far apart for the little finger (code), so visual demands change with the finger.
- Rewards: the pace multiplier and streak bonus reward speed and runs of hits; for a hemiparetic pair, the gate failure loop (Q3) means most trials end in "next one" wording while the pace sits at the floor.
- Hemiparetic hand: the non-paretic hand tends to wait (Rose and Winstein 2005 [ABS]; Dickstein et al. 1993 [ABS]); involuntary movements of the unaffected hand are common (Nelles et al. 1998 [ABS]); a bilateral force deficit lowers force in two-hand tasks even in healthy hands (Li et al. 2001 [ABS]); a finger that cannot relax below its release trigger stays latched and its later presses are not detected (calibration_profile.py 65-80); recovery mode puts 70 percent of cues on the best pair. These belong in the session procedure (screening, rest, stopping rules, consent wording), not in an approvals task.

Bearing. Add a short instruction that matches the scoring, a feedback line that names the hand that came in behind, and, for any patient use, a synchrony requirement that adapts to the person rather than a pace that collapses.

---

## 3. Audit table

| Parameter or behaviour | Current value | What the evidence supports | Verdict |
|---|---|---|---|
| What the mode is called | "mirror therapy mode", "mirror-therapy mode", BATRAC lineage (engine 5268; thesis 01_intro 28, 35) | Simultaneous bilateral training (Coupar 2010); mirror therapy needs the mirror (Ramachandran 1996; Thieme 2018) | Keep the mode; rename in text |
| Efficacy wording | "contested", "not settled" | No benefit over usual care or one-arm training (Coupar 2010; Pollock 2014; Whitall 2011) | Strengthen the limit |
| Synchrony gate | 350 ms fixed (mirror.py 107, 149; default.yaml 774) | Healthy absolute gap about 19 to 24 ms; 0.4 percent gated healthy, 16 to 56 percent asymmetric (simulation) | Keep for healthy; adaptive gate for patients |
| Clean pair | both presses, no wrong finger; gated kept; one-sided excluded | One-sided trials are the widest pairs (Q6) | Keep; recover one-sided pairs from raw.csv |
| Headline gap | engine mean absolute gap (engine 6038-6041) | ICC 0.59 against median 0.74 and trimmed 0.82 at 32 trials (simulation) | Add median and trimmed mean; keep mean labelled |
| Scoring | later-press tier times pace times streak; synchrony pass or fail | Gap not rewarded below 350 ms | Keep for measurement; grade the gap for training |
| Perfect cap | Perfect paid as Great | Consistent with the 100 ms rule | Keep |
| Sub-100 ms hand press | counts as that hand's press | Reaction and Adaptive treat it as no response | Align |
| Late press after the window | idle-press charge (5.8 per block, simulation) | Carry-over 0.06 percent of trials | Log it, do not charge it |
| Start pace | 24 BPM (window 2.25 s, cues about 1.5 s apart) | Comments describe a 2.5 s gap | Keep; fix comments |
| Rest | min(60/BPM, 1 s) from the trial's close | BPM is a deadline, not a cue rate | Keep; report the window |
| Controller config | adaptive.* keys; `timeout_factor` not read | Same values today | Keep; read the key or document it |
| Device-drop guard | none in Mirror | Adaptive has one | Add |
| Weakness bias | per finger pair, floor 0.15 | Cannot target a weaker hand | Keep; describe |
| Block length | 32 trials, about 41 s | Median gap ICC 0.74; 0.85 at 64 trials (simulation) | Keep; 64 for a measurement block |
| Two-board stamping | one stamp per merged pair, keep-latest | 2.7 ms SD smooth; 43 percent dropped and session bias in packets; 9 ms bias mixed (simulation) | Fix; log per-board stamps; bench offset |
| Pad triggers | 30 percent of each pad's calibrated gap | 5 to 27 ms offsets between pads (arithmetic) | Re-time at a fraction of each press's own peak |
| Cue | buzz on both fingers (right board first), tone for the right finger, two tiles | Motor lags per board unknown | Bench both boards' motors |
| Instructions | no GET READY line | Instructions change asynchrony (Gutnik 2009) | Add a line |
| Feedback | generic popup | Bank rules ask for direction and next action | Add Mirror lines |
| M1 | mean below 60 ms, scored | Cannot fail (simulation) | Re-label as a rig check, on the median |
| M2 | one-sided "dominant leads", Holm | No supported direction; board offsets decide it (simulation) | Two-sided, reported, beside the bench offset |
| W2 | narrowing, reading "clean" | Window shrinks; 28 percent power for 5 ms at n = 10 | Descriptive; reading "structured" |
| M3 | BPM range | BPM is a window setting | Window in ms plus one-sided count |
| Logging | right-hand force only; asymmetry None; one-sided logged as timeout | Code | Add left force, `one_sided`, `block_stats` |
| sec_mirror M2 interval | independent bootstrap | Paired data; 64 against 18 ms wide (simulation) | Paired bootstrap |

---

## 4. Recommendations, ranked by evidence strength and value for the thesis

1. **Say what the mode is, and what the evidence shows.** SAFE-NOW (text).
   Thesis: `01_intro.md` 28 and 35 and the thread table, replace "mirror-therapy mode" with "bilateral synchronous mode" and drop {cite:ramachandran1996} as the coupling source (use {cite:coupar2010} for the definition and {cite:kelso1979} for coupling). `02_lit.md` 33: Thieme pooled all stages (SMD 0.47; chronic 0.43) and the effect against the same movements with both hands visible was not significant (0.27, -0.05 to 0.59); say Mirror is that bilateral movement without the mirror. `02_lit.md` 35: "show" to "propose". `02_lit.md` 37: Whitall 2000 was an uncontrolled pilot of 14; the 111-person RCT found BATRAC not superior (Whitall et al. 2011); Cauraugh 2010 pooled heterogeneous comparisons, while the Cochrane review and overview found no benefit over usual care and moderate-quality evidence favouring one-arm training (Coupar 2010; Pollock 2014); replace kelso1984 with kelso1979 plus Bonzano 2013 for "press close together". `02_lit.md` 171 and 190 table rows to match; `03b_study.md` 88 "Well under 60 ms {cite:kelso1984}" to "about 20 ms on a 1 kHz glove (Bonzano 2013); 60 ms is a rig check"; `03a_system.md` 97 add the 350 ms gate and the wrong-finger rule, and say the asymmetry index is computed for two-hand blocks of other modes, not Mirror; `08_appendices.md` 123 describe the zero-filled emission and startup-only latency; `refs.py` 170 authors per Crossref. Code and notebook: mirror.py docstring 10-31, engine 5268, 5312-5315 and 5325-5328, `MODE_CLAIM_LIMITS["mirror"]` (28914-28943) and design doc 1.7 to the same facts. This removes the misattributed and contradicted claims from Chapters 1 and 2. Evidence: Q1.

2. **Measure and fix two-board timing before reporting any Mirror number.** DESIGN-CHANGE for the merger; SAFE-NOW for the logging and the bench procedure.
   SAFE-NOW logging: in `multi_serial.py` `_emit_paired_if_ready` (344) carry `tr` and `tl` into the emitted `Sample` (for example a `t_hands` field) and write them as two raw.csv columns from engine 2518; add a per-board line counter if the firmware can send one. Bench: press each finger pair's two pads with one rigid bar about 100 times, with the boards swapped between ports and between hands, and record the mean and SD of the measured gap (the rig's own floor and offset); record each motor's command-to-motion lag on both boards with the microphone method already used for `latency.buzzer_ms`. DESIGN-CHANGE: feed each hand's detector from its own board's stream with its own stamps and queue every sample per board instead of keeping the latest, so nothing is dropped; the one-board path (`only_one`, multi_serial.py 295 and 304-319) is untouched, so the healthy study's data do not change. This replaces the "about 7 ms" note with measured numbers; without it M2 is decided by the rig (simulation: a 9 ms board offset turns a 10 ms lead into 5 to 7 percent passes, or creates a lead in 74 to 99 percent). Evidence: Q4, Q7.

3. **Re-specify M1, M2 and W2 now, while no Mirror data exist.** SAFE-NOW (registered text and analysis; log the date).
   Design doc Sections 1.7, 4.4, 4.5b, 4.6 and 4.7; notebook `sec_cohort_validity` 27060-27066 and 27425-27427; `MODE_LIT["mirror"]` 28310-28338. M1: a rig feasibility check, the cohort median of per-person median absolute gap below 60 ms with the order-statistic interval, no p value, listed with A5, A6 and C1 (simulation: 98.5 to 100 percent pass). M2: "which hand leads", per-person median signed gap (right minus left), `_paired_check(..., "two-sided", report_only=True)` as for Rh3, out of the Holm family, printed beside the bench inter-board offset and the board-to-hand assignment; cite Helmuth and Ivry 1996, Shen and Franz 2005, Franz et al. 2002, Kaluzny et al. 1994 and Stucchi and Viviani 1993 instead of Peters 1980 and Hubel 2013. W2: descriptive, with its power stated (28 percent for a 5 ms narrowing at n = 10), and `COHORT_WITHIN_BLOCK_READING["mirror"]` set to "structured" (the window shrinks as the pace climbs, one-sided trials censored); design 4.5b moves Mirror out of "Clean"; 4.6 and 4.7 say "absolute gap". Evidence: Q2, Q7.

4. **Fix `sec_mirror`'s statistics.** SAFE-NOW (analysis).
   In `sec_mirror` (30290): replace `diff_ci(d, n)` (30350) with a paired bootstrap over trials of the signed gap (median and mean, `BOOT_N`, `BOOT_SEED`), which narrows the interval from about 64 to 18 ms; score M1 on the median with the median's interval; add median absolute gap, 10 percent trimmed mean, share within 50 ms, signed median and IQR of the signed gap, and label `mean_gap_ms` "includes gated pairs"; drop pairs where either hand's own RT is under `ANTICIPATION_MS` (1625); print n per finger with the trigger and tile-distance caveat. Same summaries in `_cohort_mirror` (22134). Evidence: Q8, Q9.

5. **Report the window, the censoring and the one-sided trials with every gap.** SAFE-NOW (analysis and text).
   Replace M3's BPM range with the window range from `timeout_ms` and the count of one-sided trials; recover each one-sided trial's second press from raw.csv (`press` on the other copy of the finger within 1.5 s of the stim) and print a sensitivity gap that includes them; in `MODE_CLAIM_LIMITS["mirror"]` replace "A tighter gap at a slower pace is not a tighter hand" with "A faster pace drops the widest pairs as one-sided misses, so the gap shrinks without the hands changing (simulation: 25.0 against 30.5 ms)". Evidence: Q6.

6. **Log what Mirror does.** SAFE-NOW (logging; no measure changes).
   Add `MirrorMode.block_stats()` (seed, start pace, pace and window at each cue, recovery entries, one-sided count, gated count, late presses after the window, cues and hits per finger) and call it from the `mirror` section of `_build_block_summary` (engine 6034); queue a per-trial `mirror_state` raw event like Adaptive's `adaptive_state`; pass `error_type="one_sided"` from `_finish` (mirror.py 483-490) when exactly one hand pressed; log the left hand's peak force and impulse on Mirror rows (engine 9279 reads the right lane only) and compute the RT and force asymmetry from `mirror_right_rt_ms` and `mirror_left_rt_ms`; queue a raw `late_press` event when a press on the finished trial's finger arrives before the next cue. Evidence: Q5, Section 1.4.

7. **Guard the controller against a board drop.** DESIGN-CHANGE (small; two-board only).
   In `MirrorMode._finish` before `adapter.record` (mirror.py 448), if one side is missing and its hand is in `engine._hands_down` or the source is disconnected, log the row with `error_type="device_drop"` and skip `record` and `next_bpm`, as `AdaptiveMode._source_dropped` does. Prevents a dropped board from driving the pace to the floor. Evidence: Q6.

8. **Tell the player what counts, and which hand came in behind.** SAFE-NOW (UX; changes what participants are told, so log the wording before any data).
   `screens.py` `GameplayScreen.GET_READY_LINES["mirror"]`, for example "Press the lit finger on both hands" / "at the same moment." / "A pair counts when both land together."; `feedback_bank.MODE_LINES["mirror"]` with lines such as "{hand} hand came in behind. Together next." used for a gated pair, checked with `feedback_bank.offending()` and pinned by a test like the chords one. Evidence: Gutnik et al. 2009 [ABS]; Q10.

9. **Scoring rules for a later two-board study.** DESIGN-CHANGE.
   No idle-press charge for a press on the just-finished trial's finger before the next cue; a press under 100 ms after the cue is not a response on either hand (as Adaptive 238-249); grade synchrony (for example Great at 30 ms or less, Good at 80 ms or less, pass to 350 ms) or add a togetherness bonus if Mirror is ever used for training. Evidence: Q5, Q6.

10. **A block long enough to measure.** DESIGN-CHANGE (optional).
    For a measurement block set `game.repeat_count` to 16 (64 trials, about 80 s): median gap ICC 0.74 to 0.85 and trimmed mean 0.82 to 0.91 (simulation). Evidence: Q8.

11. **For a patient study and a full two-board study.** AFTER-COLLECTION.
    A synchrony requirement that adapts per person (a staircase on `mirror.max_async_ms`) rather than the pace alone (simulation: a 400 ms paretic lag gates 56 percent of trials and parks the pace at 10 to 24 BPM); one-hand blocks for each hand so each hand's bimanual cost is known and "the faster hand waited" can be told from "the slower hand caught up" (Rose and Winstein 2005 [ABS]); the research preset already proposed in `modes-review.md` (one-hand, bimanual homologous and non-homologous trials); boards swapped between hands for half the participants (allocation A in `03b_study.md` 48 already does this); force asymmetry and variability measures (Kang and Cauraugh 2014 [FT]; Lodha et al. 2012 [ABS]); a between-day retest.

---

## 5. Analysis recommendations for the notebook

| Add or fix | Where (cell 2) | Method source |
|---|---|---|
| Paired bootstrap of per-trial signed gaps for M2 in place of `diff_ci` | `sec_mirror` 30343-30365; `diff_ci` 10204 | simulation (Q9); both latencies come from the same trials (code) |
| M1 criterion and interval on the same statistic (median absolute gap, order-statistic or bootstrap interval) | `sec_mirror` 30328-30341 | design Section 2.1 rule for medians |
| Median absolute gap, 10 percent trimmed mean, share within 50 ms, signed median, IQR of the signed gap | `sec_mirror`, `_cohort_mirror` 22134 | simulation (Q8); Bonzano et al. 2013 [FT] used the absolute interval |
| M1 as a rig feasibility check on the median; no p | `sec_cohort_validity` 27060-27062; `MODE_LIT["mirror"]` | simulation (Q7) |
| M2 two-sided and report-only, on per-person median signed gap, outside Holm, with the bench offset and board assignment printed | `sec_cohort_validity` 27063-27065 | Q2 sources; simulation (Q7) |
| W2 reading "structured"; print its power | `COHORT_WITHIN_BLOCK_READING` 31974; `_within_block_row` call 27425 | simulation (Q7) |
| Window range (ms) and one-sided count in place of the BPM range | `sec_mirror` M3 30373-30384 | code (Q6) |
| Recover one-sided trials' second press from raw.csv; sensitivity gap including them | new helper beside `_mirror_clean_mask` 22113 | code (engine 557-577) |
| Drop pairs with either hand's own RT under 100 ms | `_mirror_clean_mask` 22113 | `ANTICIPATION_MS` 1625 |
| Onset re-timed at a fixed fraction (for example 10 percent) of each press's own peak from raw.csv, for both hands, as a sensitivity gap | new helper; raw samples | arithmetic (Q4) |
| Per-finger gaps with n and the trigger and tile-distance caveat | `sec_mirror` per-finger table | code (Q9) |
| Two-board stream diagnostics: merged sample rate against 199 Hz (drops), share of exactly-zero gaps, packet structure | new rows in `sec_mirror` and `sec_inter_hand` 6260 | simulation (Q4) |
| Left-hand force per Mirror trial from raw.csv until it is logged | `sec_bilateral` Mirror readout 6030-6086 | code (Section 1.4) |
| Absolute-gap wording for the within-block series | design Sections 4.6 and 4.7 | code 24020-24027 |

Keep as they are: gated pairs inside the gap, wrong-finger trials out of it, the per-hand latency columns, the DROPPED rows on a one-board tree.

---

## 6. Thesis facts

### 6.1 Reference values, with caveats

| Value | Figure | Source | Caveat for this rig |
|---|---|---|---|
| Healthy absolute inter-hand onset interval, paced bimanual finger opposition | 18.5 to 24.0 ms (n 10); 18.87 ms, SE 0.87 (n 80) | Bonzano et al. 2008, 2013 [FT] | 1 kHz glove, touch onsets, metronome, eyes closed; Mirror is a cued press timed at a force trigger |
| Same interval, test-retest one month apart | ICC 0.75 single trial, 0.86 mean of two (n 27) | Bonzano et al. 2013 [FT] | 60 s trials of about 120 touches; log scale |
| Group mean signed asynchrony, bimanual index tapping | -0.7 ms (SD 4.95 across 27 people); median absolute individual mean 3.9 ms | Helmuth and Ivry 1996 [FT] | continuous tapping at 400 ms, microswitch keys at 1 ms |
| Onset lag, discrete bimanual reaching | within 12 ms of zero; 67 to 106 ms at movement end | Sardar et al. 2023 [FT] | reaching, touchscreen, 19 young adults |
| Dominant-hand lead | about 25 ms in continuous ellipse tracing and forearm rotation | Stucchi and Viviani 1993; Viviani et al. 1998 [ABS] | not found for discrete presses |
| Mirror therapy effect | SMD 0.47 overall; 0.27 (n.s.) against the same movements with both limbs visible | Thieme et al. 2018 [FT] | Mirror is the comparison condition, not the therapy |
| Bilateral against usual care or other arm training | ADL SMD 0.25 and -0.25, both n.s. | Coupar et al. 2010 [FT] | arm-level training, few finger trials |
| Expected values for this rig (healthy) | per-person median absolute gap about 18 to 20 ms (10th to 90th percentile 11 to 32 ms); engine mean about 22 to 25 ms; hit rate 0.86 to 0.88; peak pace about 108 BPM (window about 500 ms); 41 to 42 s a block | simulation | a model of a hand, smooth boards; check against bench and data |

### 6.2 Reliability and change expectations

- One 32-trial block: ICC about 0.74 for the median absolute gap and 0.82 for a 10 percent trimmed mean, 0.59 for the engine's mean, 0.59 for the signed median (simulation); 0.75 for the absolute interval one month apart in the literature (Bonzano et al. 2013 [FT]).
- Block-to-block change in a person's median gap with nothing changing: SD about 6 ms, so a change under about 12 ms is within noise (simulation, arithmetic).
- Within one block: no narrowing is expected; a 5 ms narrowing would be detected in 28 percent of cohorts of 10 (simulation).

### 6.3 Claims to avoid

- That Mirror is mirror therapy, or any mirror-therapy effect size applied to it.
- That bilateral training works, or that the mode trains recovery; the best syntheses find no advantage (Q1).
- That Ramachandran 1996 shows interlimb coupling or the "unaffected hand drags the affected one" idea.
- That M1 shows anything about the hands; it checks the rig.
- Any dominant-hand lead from M2 without a bench-measured inter-board offset and swapped boards; and any directional prediction for it.
- That two boards stamp presses independently, or a fixed "7 ms" resolution; give the measured bench figure.
- That a narrower gap within a block, or at a faster pace, is better coordination (censoring, Q6).
- That a smaller gap in a patient means a better paretic hand (the other hand may wait, Q3).
- Per-finger synchrony differences (as few as about 5 pairs per finger in a 32-trial block, arithmetic; pad and screen confounds).
- RT or force asymmetry from a Mirror block (None by construction until logged).

### 6.4 Text corrections already found

`01_intro.md` 28, 35 (mirror-therapy mode; ramachandran1996 as coupling); `02_lit.md` 33 (Thieme population and the unrestricted-view result), 35 ("show"), 37 (Whitall 2000 design and the RCT; kelso1984 for discrete presses), 39 (balasubramanian2025 authors), 171 and 190 (sources and "mirror boxes"); `03a_system.md` 89 (the gallery caption says "Mirror on two boards", but no two-board Mirror block exists on disk; say how the screenshot was made), 97 (gate, wrong finger, asymmetry); `03b_study.md` 88 (60 ms and kelso1984); `08_appendices.md` 123 (merger behaviour). Repository: mirror.py 10-31; engine 5268, 5312-5315, 5325-5328; default.yaml 762-767; `MODE_LIT["mirror"]`; `MODE_CLAIM_LIMITS["mirror"]`; design doc 921-937, 2296-2298, 2500, 2587; `docs/research/new_modes/stroke.md` (the Whitall 2011 entry gives the neural finding but not that BATRAC was not superior).

---

## 7. Sources

Retrieved and checked on 1 October 2026 through Europe PMC, PubMed Central, Crossref, publisher and author or laboratory pages.

1. Altschuler EL, Wisdom SB, Stone L, Foster C, Galasko D, Llewellyn DM, Ramachandran VS. 1999. Rehabilitation of hemiparesis after stroke with a mirror. Lancet 353(9169):2035-2036. DOI 10.1016/S0140-6736(99)00920-4. PMID 10376620. [META; design as tabulated in Thieme et al. 2018]
2. Amazeen EL, Ringenbach SD, Amazeen PG. 2005. The effects of attention and handedness on coordination dynamics in a bimanual Fitts' law task. Experimental Brain Research 164(4):484-499. DOI 10.1007/s00221-005-2269-y. PMID 15971067. [ABS]
3. Aramaki Y, Honda M, Sadato N. 2006. Suppression of the non-dominant motor cortex during bimanual symmetric finger movement: a functional magnetic resonance imaging study. Neuroscience 141(4):2147-2153. DOI 10.1016/j.neuroscience.2006.05.030. PMID 16793210. [ABS]
4. Bonzano L, Tacchino A, Roccatagliata L, Abbruzzese G, Mancardi GL, Bove M. 2008. Callosal contributions to simultaneous bimanual finger movements. Journal of Neuroscience 28(12):3227-3233. DOI 10.1523/JNEUROSCI.4076-07.2008. PMID 18354026. PMC6670695. [FT, PMC page: Methods (motor task, behavioural analysis), Results (interhand interval), Discussion]
5. Bonzano L, Sormani MP, Tacchino A, Abate L, Lapucci C, Mancardi GL, Uccelli A, Bove M. 2013. Quantitative assessment of finger motor impairment in multiple sclerosis. PLoS One 8(5):e65225. DOI 10.1371/journal.pone.0065225. PMID 23741485. PMC3669283. [FT: Methods, test-retest section and Table 1, group comparison]
6. Cauraugh JH, Lodha N, Naik SK, Summers JJ. 2010. Bilateral movement training and stroke motor recovery progress: a structured review and meta-analysis. Human Movement Science 29(5):853-870. DOI 10.1016/j.humov.2009.09.004. PMID 19926154. PMC2889142. [FT, PMC author manuscript: Abstract, Methods (comparisons, outcome selection), Results (overall effect, heterogeneity, funnel plot, moderators, Table 2)]
7. Cauraugh JH, Summers JJ. 2005. Neural plasticity and bilateral movements: a rehabilitation approach for chronic stroke. Progress in Neurobiology 75(5):309-320. DOI 10.1016/j.pneurobio.2005.04.001. PMID 15885874. [ABS]
8. Chen PM, Kwong PWH, Lai CKY, Ng SSM. 2019. Comparison of bilateral and unilateral upper limb training in people with stroke: a systematic review and meta-analysis. PLoS One 14(5):e0216357. DOI 10.1371/journal.pone.0216357. PMID 31120910. PMC6532847. [FT: Abstract, Results, Discussion, limitations]
9. Coupar F, Pollock A, van Wijck F, Morris J, Langhorne P. 2010. Simultaneous bilateral training for improving arm function after stroke. Cochrane Database of Systematic Reviews (4):CD006432. DOI 10.1002/14651858.CD006432.pub2. PMID 20393947. PMC6464898. [FT, PMC page: Abstract, definition of the intervention, included studies, Discussion on Stewart 2006]
10. Dickstein R, Hocherman S, Amdor G, Pillar T. 1993. Reaction and movement times in patients with hemiparesis for unilateral and bilateral elbow flexion. Physical Therapy 73(6):374-380. DOI 10.1093/ptj/73.6.374. PMID 8497512. [ABS]
11. Drewing K, Aschersleben G. 2003. Reduced timing variability during bimanual coupling: a role for sensory information. Quarterly Journal of Experimental Psychology A 56(2):329-350. DOI 10.1080/02724980244000396. PMID 12613567. [ABS]
12. Eswari B, Balasubramanian S, Varadhan SKM. 2025. Comparable neural and behavioural performance in dominant and non-dominant hands during grasping tasks. Scientific Reports 15:14690. DOI 10.1038/s41598-025-99941-6. [META: Crossref record, checked for the author names only]
13. Franz EA, Rowse A, Ballantine B. 2002. Does handedness determine which hand leads in a bimanual task? Journal of Motor Behavior 34(4):402-412. DOI 10.1080/00222890209601956. PMID 12446253. [ABS]
14. Gutnik B, Hudson CG, Nicholson J. 2009. Intermanual temporal differences in bimanual simple isometric coupling by instructions. Perceptual and Motor Skills 108(3):836-850. DOI 10.2466/pms.108.3.836-850. PMID 19725319. [ABS]
15. Haken H, Kelso JAS, Bunz H. 1985. A theoretical model of phase transitions in human hand movements. Biological Cybernetics 51(5):347-356. DOI 10.1007/BF00336922. PMID 3978150. [META]
16. Hatem SM, Saussez G, della Faille M, Prist V, Zhang X, Dispa D, Bleyenheuft Y. 2016. Rehabilitation of motor function after stroke: a multiple systematic review focused on techniques to stimulate upper extremity recovery. Frontiers in Human Neuroscience 10:442. DOI 10.3389/fnhum.2016.00442. PMID 27679565. PMC5020059. [FT: sections Bilateral training and Mirror therapy, recommendations]
17. Hedge C, Powell G, Sumner P. 2018. The reliability paradox. Behavior Research Methods 50(3):1166-1186. DOI 10.3758/s13428-017-0935-1. PMID 28726177. PMC5990556. [FT: Abstract, section on difficulties with difference scores]
18. Helmuth LL, Ivry RB. 1996. When two hands are better than one: reduced timing variability during bimanual movements. Journal of Experimental Psychology: Human Perception and Performance 22(2):278-293. DOI 10.1037/0096-1523.22.2.278. PMID 8934844. [FT: publisher PDF from the Ivry laboratory archive; Experiment 1 method and results]
19. Hubel KA, Reed B, Yund EW, Herron TJ, Woods DL. 2013. Computerized measures of finger tapping: effects of hand dominance, age, and sex. Perceptual and Motor Skills 116(3):929-952. DOI 10.2466/25.29.PMS.116.3.929-952. PMID 24175464. [META]
20. Kaluzny P, Palmeri A, Wiesendanger M. 1994. The problem of bimanual coupling: a reaction time study of simple unimanual and bimanual finger responses. Electroencephalography and Clinical Neurophysiology 93(6):450-458. DOI 10.1016/0168-5597(94)90153-8. PMID 7529696. [ABS]
21. Kang N, Cauraugh JH. 2014. Bimanual force variability and chronic stroke: asymmetrical hand control. PLoS One 9(7):e101817. DOI 10.1371/journal.pone.0101817. PMID 25000185. PMC4085011. [FT: Abstract, Methods, Results]
22. Kantak S, Jax S, Wittenberg G. 2017. Bimanual coordination: a missing piece of arm rehabilitation after stroke. Restorative Neurology and Neuroscience 35(4):347-364. DOI 10.3233/RNN-170737. PMID 28697575. [ABS]
23. Kelso JAS. 1984. Phase transitions and critical behavior in human bimanual coordination. American Journal of Physiology 246(6 Pt 2):R1000-R1004. DOI 10.1152/ajpregu.1984.246.6.R1000. PMID 6742155. [ABS]
24. Kelso JAS, Southard DL, Goodman D. 1979. On the coordination of two-handed movements. Journal of Experimental Psychology: Human Perception and Performance 5(2):229-238. DOI 10.1037/0096-1523.5.2.229. PMID 528935. [ABS]
25. Kelso JAS, Southard DL, Goodman D. 1979. On the nature of human interlimb coordination. Science 203(4384):1029-1031. DOI 10.1126/science.424729. PMID 424729. [ABS]
26. Kilbreath SL, Crosbie J, Canning CG, Lee MJ. 2006. Inter-limb coordination in bimanual reach-to-grasp following stroke. Disability and Rehabilitation 28(23):1435-1443. DOI 10.1080/09638280600638307. PMID 17166806. [ABS]
27. Koo TK, Li MY. 2016. A guideline of selecting and reporting intraclass correlation coefficients for reliability research. Journal of Chiropractic Medicine 15(2):155-163. DOI 10.1016/j.jcm.2016.02.012. PMID 27330520. PMC4913118. [FT: forms of ICC, interpretation section]
28. Lewis GN, Byblow WD. 2004. Bimanual coordination dynamics in poststroke hemiparetics. Journal of Motor Behavior 36(2):174-188. DOI 10.3200/JMBR.36.2.174-188. PMID 15130868. [ABS]
29. Li S, Danion F, Latash ML, Li ZM, Zatsiorsky VM. 2001. Bilateral deficit and symmetry in finger force production during two-hand multifinger tasks. Experimental Brain Research 141(4):530-540. DOI 10.1007/s002210100893. PMID 11810146. [ABS]
30. Lodha N, Coombes SA, Cauraugh JH. 2012. Bimanual isometric force control: asymmetry and coordination evidence post stroke. Clinical Neurophysiology 123(4):787-795. DOI 10.1016/j.clinph.2011.08.014. PMID 21924949. [ABS]
31. Luft AR, McCombe-Waller S, Whitall J, Forrester LW, Macko R, Sorkin JD, Schulz JB, Goldberg AP, Hanley DF. 2004. Repetitive bilateral arm training and motor cortex activation in chronic stroke: a randomized controlled trial. JAMA 292(15):1853-1861. DOI 10.1001/jama.292.15.1853. PMID 15494583. PMC2930817. [FT, PMC author manuscript: Methods (training, outcomes), Results (functional outcomes, mirror limb co-contraction), Discussion and limitations]
32. McCombe Waller S, Harris-Love M, Liu W, Whitall J. 2006. Temporal coordination of the arms during bilateral simultaneous and sequential movements in patients with chronic hemiparesis. Experimental Brain Research 168(3):450-454. DOI 10.1007/s00221-005-0235-3. PMID 16331507. [ABS]
33. McCombe Waller S, Whitall J. 2008. Bilateral arm training: why and who benefits? NeuroRehabilitation 23(1):29-41. DOI 10.3233/NRE-2008-23104. PMID 18356587. PMC2953420. [FT, PMC author manuscript: Sections 1.1 to 1.3, Section 2 and the severity table]
34. Miller J, Ulrich R. 2008. Bimanual response grouping in dual-task paradigms. Quarterly Journal of Experimental Psychology 61(7):999-1019. DOI 10.1080/17470210701434540. PMID 18938282. [ABS]
35. Miller KA, Smyth MM. 2012. Asynchrony in discrete bimanual aiming: evidence for visual strategies of coordination. Quarterly Journal of Experimental Psychology 65(10):1911-1926. DOI 10.1080/17470218.2012.669389. PMID 22512469. [ABS]
36. Nakamura R, Sajiki N, Taniguchi R. 1977. Reaction time in bimanual simultaneous motions. Journal of Human Ergology 6(1):69-73. PMID 608959. [ABS]
37. Nelles G, Cramer SC, Schaechter JD, Kaplan JD, Finklestein SP. 1998. Quantitative assessment of mirror movements after stroke. Stroke 29(6):1182-1187. DOI 10.1161/01.STR.29.6.1182. PMID 9626292. [ABS]
38. Nisiyama M, Ribeiro-do-Valle LE. 2014. Relative performance of the two hands in simple and choice reaction time tasks. Brazilian Journal of Medical and Biological Research 47(1):80-89. DOI 10.1590/1414-431X20132932. PMID 24345871. PMC3932976. [FT: Abstract, Introduction (review of hand RT studies), Methods, Results on reaction time]
39. Peters M. 1980. Why the preferred hand taps more quickly than the non-preferred hand: three experiments on handedness. Canadian Journal of Psychology 34(1):62-71. DOI 10.1037/h0081014. [META: Crossref record]
40. Pollock A, Morris J, van Wijck F, Coupar F, Langhorne P. 2011. Response to Cauraugh, J. H., et al. Bilateral movement training and stroke motor recovery progress: a structured review and meta-analysis. Human Movement Science 30(1):143-146 (author reply 147-149). DOI 10.1016/j.humov.2010.10.003. PMID 21185099. [META]
41. Pollock A, Farmer SE, Brady MC, Langhorne P, Mead GE, Mehrholz J, van Wijck F. 2014. Interventions for improving upper limb function after stroke. Cochrane Database of Systematic Reviews (11):CD010820. DOI 10.1002/14651858.CD010820.pub2. PMID 25387001. PMC6469541. [FT, PMC page: Abstract, sections on bilateral arm training and mirror therapy, summary of findings table]
42. Ramachandran VS, Rogers-Ramachandran D. 1996. Synaesthesia in phantom limbs induced with mirrors. Proceedings of the Royal Society of London B 263(1369):377-386. DOI 10.1098/rspb.1996.0058. PMID 8637922. [FT: publisher PDF (a copy downloaded from rspb.royalsocietypublishing.org, hosted on a third-party site); Summary, mirror-box method, section (e), conclusions]
43. Rice MS, Newell KM. 2004. Upper-extremity interlimb coupling in persons with left hemiplegia due to stroke. Archives of Physical Medicine and Rehabilitation 85(4):629-634. DOI 10.1016/j.apmr.2003.08.084. PMID 15083440. [ABS]
44. Rinkenauer G, Ulrich R, Wing AM. 2001. Brief bimanual force pulses: correlations between the hands in force and time. Journal of Experimental Psychology: Human Perception and Performance 27(6):1485-1497. DOI 10.1037/0096-1523.27.6.1485. PMID 11766938. [ABS]
45. Rose DK, Winstein CJ. 2004. Bimanual training after stroke: are two hands better than one? Topics in Stroke Rehabilitation 11(4):20-30. DOI 10.1310/NCB1-JWAA-09QE-7TXB. PMID 15592987. [ABS]
46. Rose DK, Winstein CJ. 2005. The co-ordination of bimanual rapid aiming movements following stroke. Clinical Rehabilitation 19(4):452-462. DOI 10.1191/0269215505cr806oa. PMID 15929515. [ABS]
47. Rose DK, Winstein CJ. 2013. [Main title, which compares temporal with spatial coupling, not reproduced]: an investigation of interlimb coordination after stroke. Journal of Motor Behavior 45(4):313-324. DOI 10.1080/00222895.2013.798250. PMID 23819649. [ABS]
48. Sardar SD, Yeo SH, Allsop JE, Punt TD. 2023. Overt visual attention and between-limb asynchrony for bimanual reaching movements. Experimental Brain Research 241(2):649-660. DOI 10.1007/s00221-023-06552-6. PMID 36658440. PMC9894997. [FT, PMC page: Introduction, Methods (coupling measures), Results (Table 1, lags), Discussion]
49. Shea CH, Boyle J, Kovacs AJ. 2012. Bimanual Fitts' tasks: Kelso, Southard, and Goodman, 1979 revisited. Experimental Brain Research 216(1):113-121. DOI 10.1007/s00221-011-2915-5. PMID 22045299. [ABS]
50. Shen YC, Franz EA. 2005. Hemispheric competition in left-handers on bimanual reaction time tasks. Journal of Motor Behavior 37(1):3-9. DOI 10.3200/JMBR.37.1.3-9. PMID 15642688. [ABS; the author copy sits behind a human-verification page that was not completed]
51. Sleimen-Malkoun R, Temprado JJ, Thefenne L, Berton E. 2011. Bimanual training in stroke: how do coupling and symmetry-breaking matter? BMC Neurology 11:11. DOI 10.1186/1471-2377-11-11. PMID 21266027. PMC3037867. [FT: Background, sections on discrete bimanual tasks, coupling against symmetry-breaking, clinical messages]
52. Stewart KC, Cauraugh JH, Summers JJ. 2006. Bilateral movement training and stroke rehabilitation: a systematic review and meta-analysis. Journal of the Neurological Sciences 244(1-2):89-95. DOI 10.1016/j.jns.2006.01.005. PMID 16476449. [META; content as reported in Coupar et al. 2010 and Cauraugh et al. 2010]
53. Stinear CM, Barber PA, Coxon JP, Fleming MK, Byblow WD. 2008. Priming the motor system enhances the effects of upper limb therapy in chronic stroke. Brain 131(5):1381-1390. DOI 10.1093/brain/awn051. PMID 18356189. [ABS]
54. Stinear CM, Petoe MA, Anwar S, Barber PA, Byblow WD. 2014. Bilateral priming accelerates recovery of upper limb function after stroke: a randomized controlled trial. Stroke 45(1):205-210. DOI 10.1161/STROKEAHA.113.003537. PMID 24178916. [ABS]
55. Stucchi N, Viviani P. 1993. Cerebral dominance and asynchrony between bimanual two-dimensional movements. Journal of Experimental Psychology: Human Perception and Performance 19(6):1200-1220. DOI 10.1037/0096-1523.19.6.1200. PMID 8294888. [ABS]
56. Taniguchi Y, Burle B, Vidal F, Bonnet M. 2001. Deficit in motor cortical activity for simultaneous bimanual responses. Experimental Brain Research 137(3-4):259-268. DOI 10.1007/s002210000661. PMID 11355374. [ABS]
57. Thieme H, Morkisch N, Mehrholz J, Pohl M, Behrens J, Borgetto B, Dohle C. 2018. Mirror therapy for improving motor function after stroke. Cochrane Database of Systematic Reviews (7):CD008449. DOI 10.1002/14651858.CD008449.pub3. PMID 29993119. PMC6513639. [FT, PMC page: Abstract, Background, characteristics of included studies (control interventions), Comparison 3 (control type) and Comparison 4 (time since stroke), Discussion]
58. van Delden AE, Peper CE, Beek PJ, Kwakkel G. 2012. Unilateral versus bilateral upper limb exercise therapy after stroke: a systematic review. Journal of Rehabilitation Medicine 44(2):106-117. DOI 10.2340/16501977-0928. PMID 22266762. [FT: publisher PDF; Abstract, Introduction (critique of earlier meta-analyses), Methods, Results]
59. van Delden AL, Peper CL, Nienhuys KN, Zijp NI, Beek PJ, Kwakkel G. 2013. Unilateral versus bilateral upper limb training after stroke: the Upper Limb Training After Stroke clinical trial. Stroke 44(9):2613-2616. DOI 10.1161/STROKEAHA.113.001969. PMID 23868279. [ABS]
60. van Delden AL, Beek PJ, Roerdink M, Kwakkel G, Peper CL. 2015. Unilateral and bilateral upper-limb training interventions after stroke have similar effects on bimanual coupling strength. Neurorehabilitation and Neural Repair 29(3):255-267. DOI 10.1177/1545968314543498. PMID 25055838. [ABS]
61. Veerbeek JM, van Wegen E, van Peppen R, van der Wees PJ, Hendriks E, Rietberg M, Kwakkel G. 2014. What is the evidence for physical therapy poststroke? A systematic review and meta-analysis. PLoS One 9(2):e87987. DOI 10.1371/journal.pone.0087987. PMID 24505342. PMC3913786. [FT: Results sections 5 (bilateral arm training) and 9 (mirror therapy), Discussion]
62. Viviani P, Perani D, Grassi F, Bettinardi V, Fazio F. 1998. Hemispheric asymmetries and bimanual asynchrony in left- and right-handers. Experimental Brain Research 120(4):531-536. DOI 10.1007/s002210050428. PMID 9655240. [ABS]
63. Whitall J, McCombe Waller S, Silver KH, Macko RF. 2000. Repetitive bilateral arm training with rhythmic auditory cueing improves motor function in chronic hemiparetic stroke. Stroke 31(10):2390-2395. DOI 10.1161/01.STR.31.10.2390. PMID 11022069. [ABS]
64. Whitall J, McCombe Waller S, Sorkin JD, Forrester LW, Macko RF, Hanley DF, Goldberg AP, Luft A. 2011. Bilateral and unilateral arm training improve motor function through differing neuroplastic mechanisms: a single-blinded randomized controlled trial. Neurorehabilitation and Neural Repair 25(2):118-129. DOI 10.1177/1545968310380685. PMID 20930212. PMC3548606. [FT, PMC author manuscript: Abstract, Introduction, interventions, Results, Discussion]

Counts: 64 sources; 21 FT, 36 ABS, 7 META. Of the 57 sources whose own text supplied a number or finding (FT plus ABS), 21 were read in full. Every META source whose content is used was read through a named FT secondary source (Altschuler et al. 1999 through Thieme et al. 2018; Stewart et al. 2006 through Coupar et al. 2010) or is cited only as a record (Haken et al. 1985, Hubel et al. 2013, Peters 1980, Pollock et al. 2011, the Crossref author check for Eswari et al. 2025).

Not re-read here and left as the code, design and earlier reviews cite them: Mechsner et al. 2001, Swinnen 2002, Murase et al. 2004 and Japikse et al. 2003 (cited in the thesis's coordination paragraph and not needed for any Mirror claim); the Adaptive controller's sources (read in full in `docs/research/deep/adaptive.md`); Basner and Dinges 2011 (the 100 ms rule); the feedback-bank sources.

### Simulation assumptions (Sections 1 to 6)

SIM A, timing (`sim_merger.py`). Verbatim copies of `hardware/multi_serial.py` (`_emit_paired_if_ready`, `_push_combined`), `hardware/fsr_detector.py` (`FSRDetector`, default `Calibration`: trigger 320 counts, value EMA 0.35, debounce 100 ms) and `hardware/source.py`, with `time.perf_counter` patched to a simulated clock; the merge-loop body replicated (one sample per board per pass, 0.02 ms a pass while samples flow, a 2.2 ms sleep when none arrived). Boards sample every 5.025 ms, the left board 60 ppm fast, phases random. Smooth delivery: arrival 2 ms after acquisition plus an exponential 0.5 ms; packet delivery: packets every 20.1 ms with a random phase per board, arriving 1.2 ms after the boundary, samples 0.02 ms apart. Force: baseline 265 counts, noise SD 1 count, linear rise of 80 to 200 counts over 40 to 120 ms, 350 ms hold, 80 ms release. True event: the noise-free ramp crossing the trigger; true gap normal with SD 25 ms; 600 pairs per case, and twelve 30-pair sessions per delivery type for the session bias.

SIM B and C, Mirror blocks (`sim_mirror.py`, `sim_mirror_cohort.py`, `sim_mirror_rel.py`, `sim_mirror_extra.py`, `sim_mirror_patient.py`, `sim_mirror_carry.py`). Verbatim copies of `game/modes/mirror.py`, `analytics/adaptive.py`, `game/scheduling.py` and `game/scoring.py`, driven at 60 Hz frames by a fake clock and a spy engine that applies the engine's three-miss recovery rule; shipped settings (start 24 BPM, band 0.65 to 0.80, step 10, bounds 10 to 180 BPM, weakness bias 2.5, floor 0.15, 4 fingers times 8, gate 350 ms, window 0.90 of 60/BPM, rest min(60/BPM, 1 s)). Person: decision time ex-Gaussian with mu normal (400, 45) ms plus a 30 ms bimanual cost and finger offsets of 0, 5, 20 and 15 ms, sigma normal (35, 8), tau normal (60, 15); up to 30 ms faster when the mean press nears the window; wrong-finger probability 0.02 plus 0.65 times exp(-(RT - 150)/45), with both hands pressing the same wrong finger and correcting 250 ms later; each hand equals the common time plus or minus half the person's signed bias plus independent noise, so the within-person SD of the signed gap is 25 ms (multiplied per person by exp(normal(0, 0.40)) in the reliability, rig-variant and W2-power runs, matching Bonzano et al. 2013's spread); person signed bias normal (minus the dominant lead, 8 ms); 2 percent of pairs ungrouped, one hand delayed uniform 150 to 700 ms; device error added to each hand from SIM A (gap SD 2.7 ms smooth, 8.4 ms in packets) and, where stated, a fixed right-board offset of plus or minus 9 ms. Cohorts of 8 to 20 drawn from 200 to 500 simulated people; M1 as `_mean_check` (t interval upper end below 60 ms); M2 as `_paired_check` (one-sided Wilcoxon, p below 0.05, no Holm adjustment); W2 as `_within_block_row` (paired t interval of last-third minus first-third medians entirely below 0); ICC(2,1) between two independent blocks per person with no change; the asymmetric-hand runs set the left hand 60, 200 or 400 ms later with gap SDs of 60, 150 and 250 ms and slower decision times (500, 600 and 700 ms). The model gives a healthy median absolute gap of about 18 to 20 ms, close to Bonzano et al.'s 18.9 ms, and hit rates and paces like the Adaptive pilot; it has not been checked against any two-board recording, because none exists.
