basil2fxs/Hand-Rehab-Thesis/app/docs/research/deep/buzz_hunt.md

# Buzz Hunt mode: deep research audit

1 October 2026. Scope: the study battery's Buzz Hunt step, `app/finger_rehab/game/modes/buzz_hunt.py` (mode key `buzz_hunt`), its screen (`app/finger_rehab/ui/buzz_hunt_screen.py`), the motor path in `app/finger_rehab/game/engine.py` and the firmware (`app/arduino/firmware_on_device/`), its config, the design document's Section 1.10 and the notebook analysis. The battery plays one short block on the right hand: 16 localisation trials plus 2 catch trials, then 4 span trials. The distractor and gap stages are out of the battery and out of scope, apart from where their code touches the battery block.

Tags: [FT] full text read, with the table or section named; [ABS] abstract only; [META] bibliographic record only (where content is given for a META source it was read in a named FT secondary source). Number labels: "(arithmetic)" is computed here from source or code values; "(simulation)" is a Monte Carlo result under the assumptions at the end of Section 7; "(pilot)" is the development team's blocks under `sessions/`, which describe the rig and not people; "(code)" and "(design doc)" are values read in the repository. Line numbers refer to commit a869342; notebook line numbers are lines of cell 2 of `analysis/session_analysis.ipynb`.

---

## 1. What the mode does now

### 1.1 The trial loop under the study battery

| Step | What happens | Value | Where |
|---|---|---|---|
| Block plan | 16 real localisation trials plus a fixed catch count per hand, max(1, round(catch_rate x 16)) = 2, dealt at random slots among the 18 from their own random stream; then 4 span trials. "Trial N of 22" shows at the top | 16 + 2, then 4 | `buzz_hunt.py` 758-788; `default.yaml` 2029-2034 |
| Stage card | "FIND THE BUZZ": "One finger will buzz. Press that finger." / "Hands flat on the pads. Eyes on the dot. Sometimes nothing buzzes: then the right move is to wait." Skippable | 5.0 s | `buzz_hunt_screen.py` 53-66; `buzz_hunt.py` 1181-1190; `default.yaml` 1497 |
| Announce | Dimmed dot | 1.5 s | `buzz_hunt.py` 1192-1212; `default.yaml` 1495 |
| Quiet gate | Every finger below its press threshold; a press restarts the wait and counts as an early press ("Hands still, please"); a finger held down shows "Rest your fingers on the pads" | 0.5 s | `REST_GATE_S` 595; `_wait_frame` 1363-1422 |
| Foreperiod | Uniform draw from the trial seed, after the gate; the dot brightening at trial start acts as the warning signal. From quiet fingers the buzz comes 1.3 to 2.7 s later (arithmetic) | 0.8 to 2.2 s | `_prepare_trial` 1098; `default.yaml` 1484-1485 |
| Wall | After 25 s the gate is forced open and the row is tagged `wall_forced` | 25 s | `TRIAL_WALL_S` 610; 1371-1392 |
| Stimulus | One `pulse_motor(lane, 150)`: one STIM, which the firmware holds for 150 ms at PWM duty 200/255 (index, middle, ring) or 240/255 (little); one motor per board; nothing on screen names the finger | 150 ms | `buzz_hunt.py` 1588-1694; `engine.py` 7596-7676; firmware `Config.cpp` 17-22 |
| Clock start | The frame the target STIM command leaves the host | | `_play_frame` 1648-1671 |
| Response | Opens at the command. The first queued press decides: same finger and RT at or above 0 is correct, any other finger a wrong-finger Miss; no anticipation floor. No press by the window's end is a timeout Miss | window = ladder level | `_respond_frame` 1835-1858; `_close_buzz` 1920-2092 |
| Window ladder | Levels 3.0, 2.0, 1.5, 1.2 s. Up after 6 correct of the last 8 at the level, down after 2 misses in the last 4, history cleared on every move; starts at level 0; catch trials never move it; a completed block's level carries to the next block of the same login session | see value | `WindowLadder` 498-581; `default.yaml` 1420-1422; `_end` 2354-2360; `engine.py` 2709-2728 |
| Catch trial | Nothing fires at the drawn foreperiod; a silent window of the current level's length follows. Any press is a false alarm (`catch_false_start`); silence earns 1 point and a green dot | window 3.0, 2.0 or 1.5 s | `_begin_play` 1476-1484; `_close_catch` 2094-2135 |
| Feedback | Dot turns green for a correct answer or a survived catch trial, stays dim otherwise; no words; SCORE shown top right | rest 2.0 s | `buzz_hunt_screen.py` 330-343, 194-239; `default.yaml` 1496 |
| Span stage | Stage card "REPLAY THE PATTERN". Sequence of 150 ms pulses, 400 ms onset to onset (2.5 per second), no finger twice in a row but repeats allowed; length starts at 2, up one after a correct replay, down one after a miss, floor 2; the third span trial replays the participant's hidden (Hebb) sequence for its length, seeded from the code by SHA-256. Response opens when the stimulus ends; the window is 3.0 s plus 1.5 s per item; the trial closes at the L-th press; correct only if every press matches in order | 4 trials, cap 5 items | `buzz_hunt.py` 317-359, 1147-1166, 1821-1824, 2138-2215; `default.yaml` 1450-1454, 1486-1487 |
| Block end | 22 trials done, or the 15 minute cap, or three undelivered stimuli in a row | | `_next_or_end` 2321-2343; `default.yaml` 1512 |

Timing (arithmetic from the code values): a localisation trial cycles in about 5.2 to 6.6 s (announce, gate, foreperiod, RT, rest); a catch trial takes about 8.5, 7.5 or 7.0 s at the 3.0, 2.0 or 1.5 s window. The pilot trial cycle was 5.5 to 7.1 s for real trials and about 9 s for catch trials (pilot). The design measured 2.36 and 2.66 minutes for the block (design doc Section 2.3).

### 1.2 The motor path and its timing

- The host sends `STIM:n`; the firmware drives the pin at its fixed PWM duty and turns it off on its own 150 ms timer (`Motor.cpp` `triggerStimMotor`, `updateStimMotors`; `Config.cpp` 22). Duty is 200 of 255 (78 percent) on index, middle and ring, and 240 of 255 (94 percent) on the little finger (`Config.cpp` 17-20; arithmetic). `pulse_motor` also schedules a scoped STOP at 150 ms, which lands after the firmware's own stop (`engine.py` 7631-7676). A STIM for another finger on the same board inside a live hold writes a STOP first (`_send_stim` 7422-7478), which is why span pulses are 400 ms apart.
- Measured on the study MacBook on 24 September 2026 with the laptop microphone (`finger_rehab/audio/latency_measure.py`, averaged envelope over ten pulses per motor, onset at 5 SD above the averaged noise): motor sound 105.7, 102.5, 111.6 and 106.2 ms after the command on channels 1 to 4, less a 31.5 ms microphone delay, that is 74.2, 71.0, 80.1 and 74.7 ms (arithmetic; `app/config/latency_profile.yaml`). The saved value is the median, 74 ms. When the pad is first felt is not measured.
- The design notes add that the motor reaches half strength about 100 to 140 ms after the command (`docs/research/new_modes/ranked.md` "Rank 3"); no data file for that figure is on disk.
- The docstrings and config quote "Precision Microdrives 310-103 class" values: lag about 40 ms, rise about 87 ms, stop about 115 ms. They disagree on what the 87 ms is: "rise to full amplitude" in `buzz_hunt.py` 51-52, `default.yaml` 1758-1760 and `engine.py` 7559-7560, but "87 ms to reach half amplitude" in `buzz_hunt.py` 268-269 and `rhythm.py` 98, and "rise to 50 percent (PMD AB-029)" in `default.yaml` 1763; `default.yaml` 1569-1571 and `echo.py` 130-132 give a third figure, full amplitude at about 130 ms, with no source. The hardware README's bill of materials lists only "Vibration motor on a motor PCB, with connector ... supplied by the Curtin electronics team, 2026"; the part number is not recorded anywhere in the repository.
- `scripts/latency_check.py` describes the phone-at-240-fps and piezo routes for lag, rise and stop; the docstring (`buzz_hunt.py` 96-101) says they have not been run.
- The four motors sit in four printed finger columns on one PLA base, fingertips curled down onto the pads (`hardware/README.md`; `hardware/images/chassis_section.png`; `app/docs/images/device.jpg`).
- Press timing floor (`docs/research/new_modes/modes-review.md`, "Device facts"): presses stamped 10 to 11 ms late on a bursting board, detector 7 to 11 ms after the raw crossing.

### 1.3 Scoring, feedback and what the participant is told

- A correct localisation is scored by the shared RT tiers: at or under 100 ms 10 points, at or under 200 ms 6, at or under 500 ms 3, over 500 ms 1; times the streak multiplier, up to 1.5 (`scoring.py` `classify`; `engine.py` 8115-8130). With about 90 to 100 ms of rig delay (Q4) the practical tiers are 3 points (under 500 ms from the command) or 1. A correct span replay earns great_points plus 2 per item (`buzz_hunt.py` 2149-2152).
- The instruction lines are on the stage cards only (`buzz_hunt_screen.py` 53-66). Neither mentions speed. The run sheet gives a spoken line for Reaction, Rhythm, Echo and Force Pilot but none for Buzz Hunt (`docs/study_day/run_sheet.md` "The session"). The card says "Hands flat on the pads" while the chassis has the fingertips curled down onto raised pads (`hardware/README.md`).
- The window, its level and any promotion are never shown. A timeout looks the same as a wrong answer: a dim dot.

### 1.4 Logging and block_stats

Localisation rows carry `waveform` "buzz", `waveform_params` (lane, catch flag, duration, `window_ms`, `level`), the trial seed and segment times; the `stimulus` string carries hand, finger, duration, window, level, `lured`, `stim_failed` and `wall_forced` (`_close_buzz` 2025-2068). Catch outcomes go through `log_reaction_event` (2103-2126). Span rows carry the played and pressed sequences and the Hebb flag (2161-2167). Raw events: `buzz_hunt_trial`, `pulse_motor` (requested length, delivered), `buzz_hunt_window` moves, `buzz_hunt_early` presses, forced-gate and stimulus-failure events. `block_stats` (2390-2581) gives localisation accuracy, median correct RT, per-lane counts, catch count, false alarms, `d_prime` (log-linear corrected, detection hit = any press on a real trial; 2372-2387), per-hand accuracy by level, the confusion matrix, the ladder summary (start, final and top level, trace), span `max_correct` with Hebb and novel accuracy, early presses per stage and reliability counters.

### 1.5 Registered checks and the notebook

- B1 (design doc 965-966; notebook 25060-25062): cohort mean `loc_accuracy` above 0.9; passes when the 95 percent t interval clears 0.9, "direction only" when only the point estimate does (`_mean_check` 23986).
- B2 (design doc 967-976; 25063, `_b2_binomial_row` 24460): pooled adjacent wrong-finger count against Binomial(n, 0.5), one-sided, p under 0.05; B2 is in `COHORT_PRESPECIFIED` (23957) and carries a p, so it is in the Holm family (25367-25380). The row runs only when at least `COHORT_MIN_N` (8, line 20026) participants have an `adjacent_error_share` value (24477-24486), and `_cohort_buzz_hunt` emits that value only for a person with at least one wrong-finger error (21328-21335). B2d (25064, `_b2_distance_row` 24426) prints shares by distance against 0.50, 0.33 and 0.17; B2-share (25065-25067) the mean per-person share.
- B3 (design doc 977; 25068-25070): cohort mean `catch_fa_rate` under 0.10 with the same interval rule.
- B4 (design doc 978-988; 25071-25073): cohort median `span_max_correct` within 3 to 5, bootstrap interval of the median; a feasibility check (design doc 2141-2150).
- B5 (design doc 989-995 and 2166-2167; 25074-25080): cohort median `window_top_level` within 1 to 3; exploratory.
- B6 (`sec_buzz_hunt_checks` 29097-29106): `loc_pulse_ms` in the block snapshot within 50 to 200 ms.
- W5 (design doc 2192-2196; notebook 25283-25320): per person, correct-trial RT minus the median RT of its window level, last third against first third; passes when the paired 95 percent t interval sits below zero; carries a Wilcoxon p and is in the Holm family.
- Reliability class (design doc 996-1003): poor for accuracy, moderate for span; median RT is "the one an ICC would be computed on". `loc_median_rt_ms` has a permutation split-half (`COHORT_SPLIT_SOURCES` 23173); `loc_accuracy` and `loc_median_rt_ms` are second-go rows for 60 minute sitters (30660-30661).
- `_cohort_buzz_hunt` (21289-21408) emits per person: `loc_accuracy`, `adjacent_error_share`, `errors_d1` to `errors_d3`, `catch_fa_rate`, `catch_fa_count`, `d_prime`, `window_top_level`, `loc_median_rt_ms` (taken from `block_stats`, which keeps wall-forced trials the row-based metrics drop), `span_max_correct`.
- `sec_tactile` (18137-18650) draws the ladder, the confusion matrix, a pooled d prime and criterion over the selection, legacy staircase plots, the span curve and the stored block summaries; `sec_buzz_hunt_checks` (28983-29130) prints B1 to B6 per selection.

### 1.6 What is already claimed, and the sources cited

| Claim | Where | Source cited | Status after this review |
|---|---|---|---|
| A healthy hand localises at ceiling whatever the pulse length | `buzz_hunt.py` 70-72, 509-512 | none | Supported for suprathreshold touch and vibration (Q1) |
| 150 ms "reaches full amplitude" | `buzz_hunt.py` 64-66; `default.yaml` 1405-1407 | 310-103 datasheet | Not supported: the datasheet rise time is to 50 percent amplitude, and the rig reaches half strength 100 to 140 ms after the command (Q5) |
| 310-103: lag 40 ms, rise to full amplitude 87 ms, stop 115 ms | `buzz_hunt.py` 51-52; `default.yaml` 1758-1760; `engine.py` 7559-7560 | Precision Microdrives | Lag and stop confirmed; rise is to 50 percent (PMD AB-029 [FT]), as `buzz_hunt.py` 268-269 and `default.yaml` 1763 already say. The rig's part is unrecorded and its measured lag is 71 to 80 ms (Q5) |
| Phone ERM control signals of 50 to 200 ms are the usable band; shorter ones missed, longer ones irritating | `buzz_hunt.py` 56-59, 264-267; B6 | Kaaresoja and Linjama 2005 | Partly: the abstract gives 50 to 200 ms as optimal for that phone and longer signals as irritating, and says nothing of shorter ones being missed [ABS]; B6's reason (the motor finishing its rise) is not in the source |
| 25 to 30 ms is the minimum for a fingertip pulse to read as vibration | `buzz_hunt.py` 59-63 | Remache-Vinueza et al. 2025 | Supported: medians 25 to 30 ms across 40 to 590 Hz on a voice coil [FT] |
| Mislocalisations fall on nearer fingers | B2; design doc 967-976 | Schweizer et al. 2000; Weber 2023 | Near-threshold finding [ABS]; contested (Overvliet 2011 [FT]); at suprathreshold, errors are rare and mostly middle-ring (Q2) |
| 0.5 is exactly chance for a random wrong finger | design doc 971-976; `_b2_binomial_row` | arithmetic | True only if errors fall evenly on the four stimulated fingers; for middle or ring targets chance is 2/3 (Q2) |
| The confusion matrix is the digital analogue of Weber 2023's misreferral measure | `buzz_hunt.py` 29-33; `sec_tactile` | Weber et al. 2023 | Weber's misreferrals were rare in controls and did not separate patients from controls at group level; the error of localisation in millimetres did [FT] |
| Catch trials price guessing; d prime from the catch trials | `buzz_hunt.py` 132-135, 2372-2387; design doc 944-948 | Hautus 1995; Stanislaw and Todorov 1999 | With two catch trials a person's d prime takes three values and is a relabelled false-alarm count (Q8); the notebook still emits it per person (21350) although the design says pooled only |
| Tactile-only span around 4 items | B4; `MODE_LIT["buzz_hunt"]` 26221-26227 | Yeganeh et al. 2026 | That study is a nine-site forearm array scored at a 79 percent threshold [FT]; the finger Tactual Span gives 5.30 in young adults [FT] (Q9) |
| Tactile-only span caps far below visual span in healthy adults | `buzz_hunt.py` 174-175 | none | Overstated: 5.30 against 5.97 (visuospatial) and 6.13 (digit), not significantly different in 20 to 29 year olds in one study, lower in another [FT] (Q9) |
| The top window level is the block's difficulty summary | `buzz_hunt.py` 76-79; design doc 944-951 | none | For a healthy hand the level is a count of trials (simulation); deadlines far beyond RT have little effect (Heitz 2014 [FT]) (Q7) |
| B5: a healthy hand reaches level 1 or higher | design doc 989-995 | headless simulation | Certain by construction (simulation); level 3 cannot be reached in 16 trials (arithmetic) |
| The motor's 74 ms is a constant on top of RT | design doc 938-940; `MODE_CLAIM_LIMITS` 26715-26718 | measured 24 September 2026 | It is the median of four motors, 71 to 80 ms (arithmetic), to the audible onset, not a rise time, and not the felt onset |
| The motors are audible and unmasked | design doc 1018-1019 | none | Supported; the little finger's higher duty also changes its pitch (code), and hearing a vibration shortened finger RT (Bao et al. 2019 [FT]) (Q6) |
| A vibration travels at least the finger's length; a nearer masker raises thresholds more | design doc 1013-1017 | Manfredi et al. 2012; Tame, Moles and Holmes 2014 | Supported [FT] (Q6) |
| Roughly half of stroke survivors carry a somatosensory deficit | `buzz_hunt.py` 7-8 | none | Depends on modality and body area: 7 to 53 percent impaired tactile sensation, 31 to 89 percent stereognosis, 34 to 64 percent proprioception (Connell et al. 2008 [ABS]) |
| SENSe: 10 hours of discrimination training beat exposure, gains held at 6 months | `buzz_hunt.py` 12-20 | Carey et al. 2011 | Supported [ABS]: between-group change 11.1 SSD points (CI 3.0 to 19.2) |
| Braille training moved the Fahn scale | `buzz_hunt.py` 21-27 | Zeuner et al. 2002 | Supported [ABS]; 10 patients |
| Sensory relearning after carpal tunnel release was negative on tactile outcomes | `buzz_hunt.py` 108-111 | Jerosch-Herold et al. 2016 | Supported [FT] |
| Locognosia responded to home training | `buzz_hunt.py` 33-36 | Antonopoulos et al. 2019 | Supported [ABS]; sequential allocation, not randomised |
| Buzz Hunt RT is "spawn-to-press on a visible target" | `engine.py` 215-218 comment | none | Wrong for this mode: command to press, nothing visible |

Also cited by the code or design for stages outside the battery, and not re-read: Levitt 1971, Leek 2001 (staircases), the duration difference limen paper (PMC4439551), Borngraber et al. 2022 (gap stage), Auld 2014.

### 1.7 Pilot blocks on disk (rig check only)

Seven Buzz Hunt folders (31 August to 23 September 2026); three ran the current fixed pulse with more than two trials. All were free play (32 trials a hand, no span trial reached). Localisation: 13 of 13 correct, median 330 ms, within-block SD 69 ms, ladder trace six trials at level 0, six at level 1, one at level 2, two catch trials with no false alarm (one code); 11 of 11, median 510 ms, SD 102 ms, six at level 0 and five at level 1 (a second code); 5 of 8 (one wrong finger: the little finger buzzed, the ring pressed at 777 ms; two timeouts on ring and little) (a third). One neighbour press followed a correct press by 40 ms; no same-sample tie. One block logged six early presses in its first three trials. In the blocks recorded before the 27 September change, the stimulus marker led the logged `pulse_motor` event by 7.8 to 8.8 ms on every trial, one display frame on that laptop, which is the early anchor that change removed; raw samples arrived at 198.7 Hz (pilot).

---

## 2. Research questions and findings
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
