basil2fxs/Hand-Rehab-Thesis/app/docs/research/new_modes/carpal-nerve.md

# Cluster notes: carpal tunnel, peripheral nerve, sensory relearning, focal hand dystonia

Research date: 2026-08-07. All citations below were confirmed in live searches this session.
Device constraints applied throughout: SingleTact force pad per finger at 200 Hz (analogue), one
vibration motor per finger (fixed intensity, variable duration and pulse pattern, one motor per
hand at an instant, cross-hand simultaneous OK), 60 Hz screen, speaker, CSV logging, Python
notebook analysis. No thumb.

## 1. What the literature says

### 1.1 Sensory re-education after nerve injury (Lundborg and Rosen school)

- Rosen B, Balkenius C, Lundborg G (2003). "Sensory Re-education Today and Tomorrow: A Review of
  Evolving Concepts." British Journal of Hand Therapy 8(2). DOI 10.1177/175899830300800201.
  Core rationale: after nerve repair, misdirected reinnervation scrambles the cortical hand map.
  Training exploits cortical plasticity to relearn the new input code and recover tactile gnosis
  (the ability to recognise what you touch without vision).
- Rosen B, Lundborg G (2004). "Sensory re-education after nerve repair: aspects of timing."
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
