basil2fxs/Hand-Rehab-Thesis/app/docs/images/analysis_norms.png

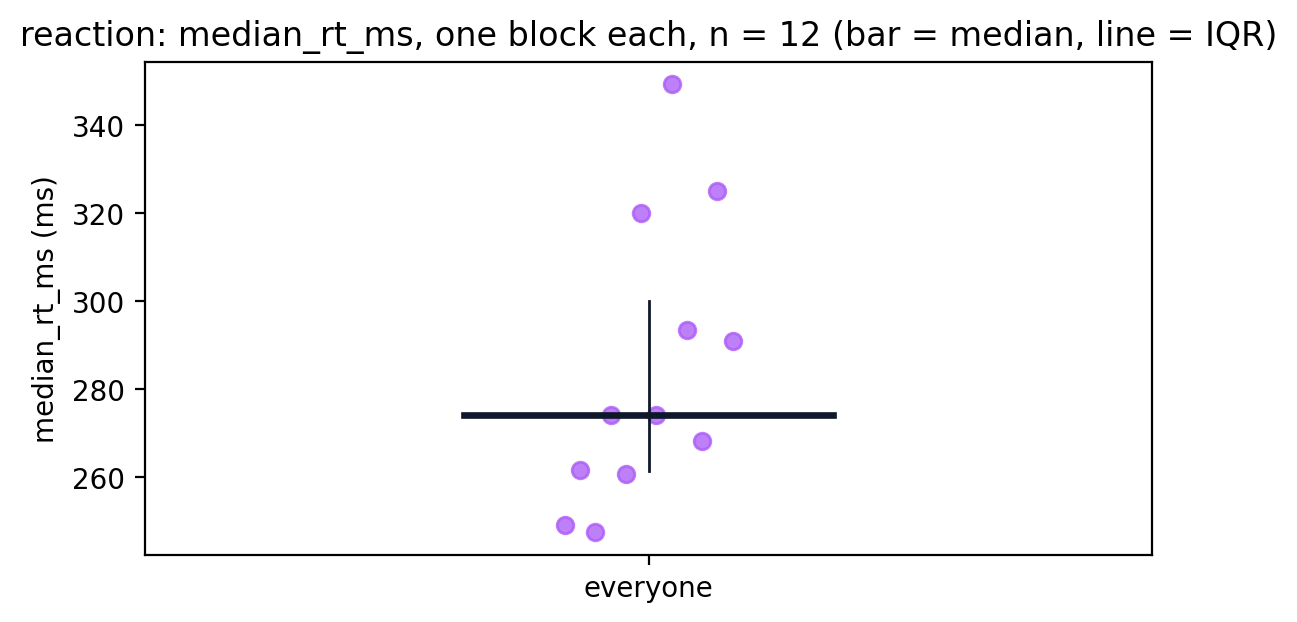
app/docs/images/analysis_norms.png
