basil2fxs/Hand-Rehab-Thesis/app/docs/images/analysis_reliability.png

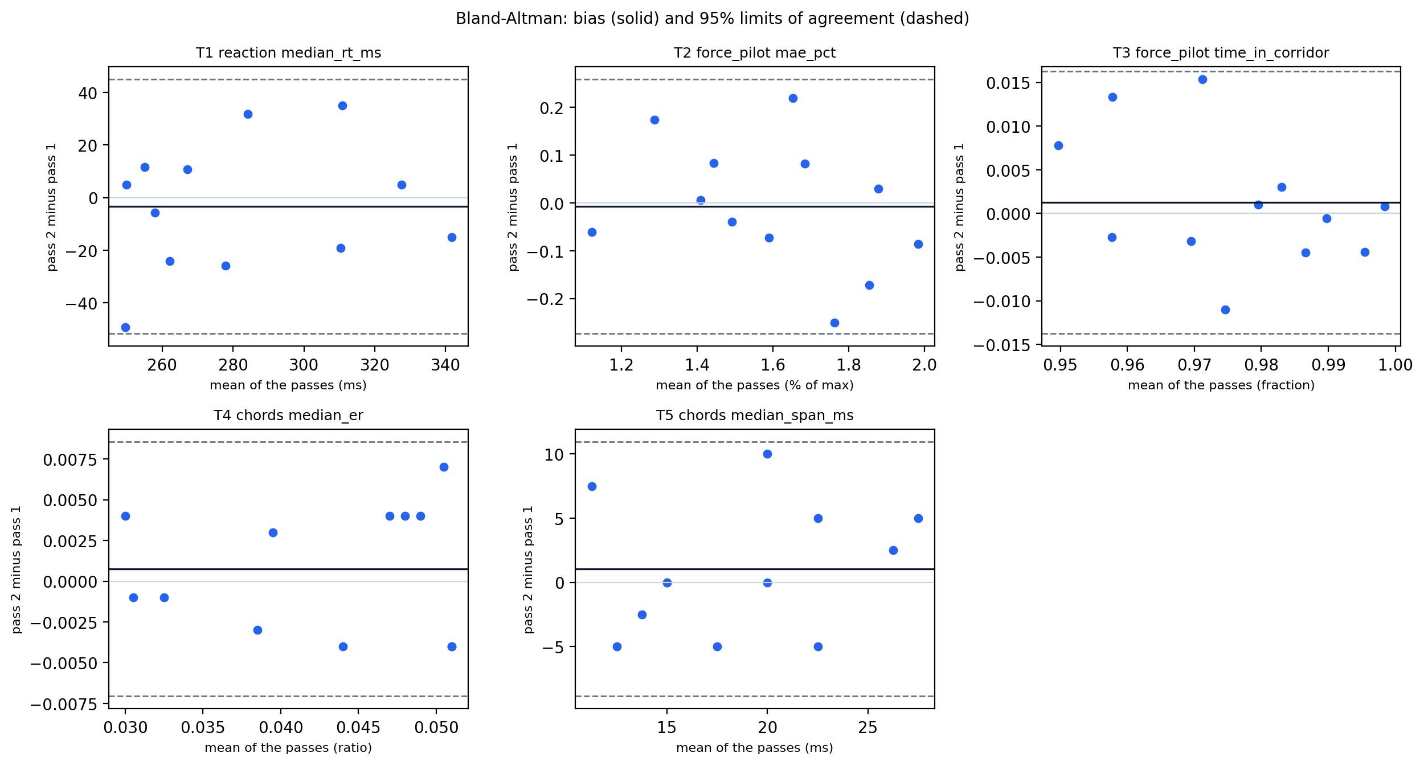
app/docs/images/analysis_reliability.png
