basil2fxs/Hand-Rehab-Thesis/app/docs/images/eeg_port.png

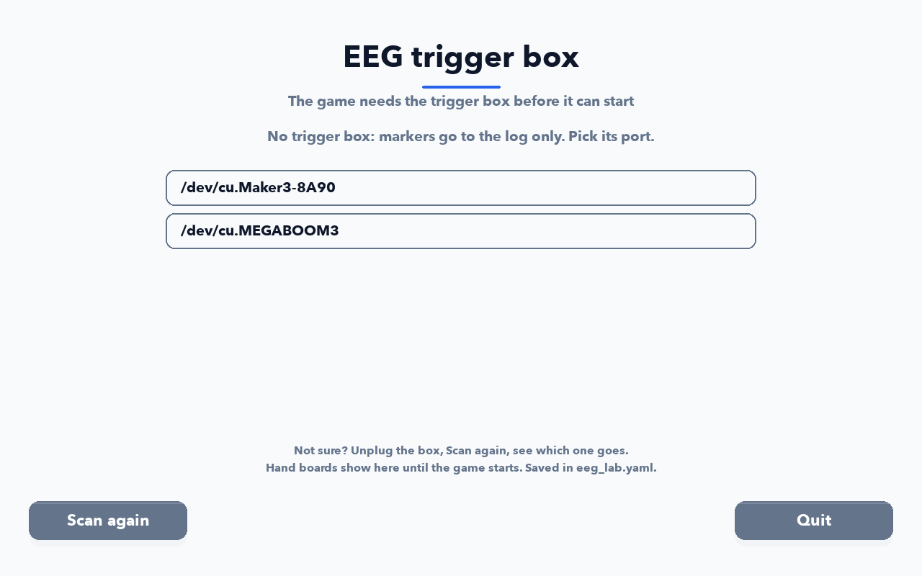
app/docs/images/eeg_port.png
