basil2fxs/Hand-Rehab-Thesis/app/docs/research/rayan/ss1.jpeg

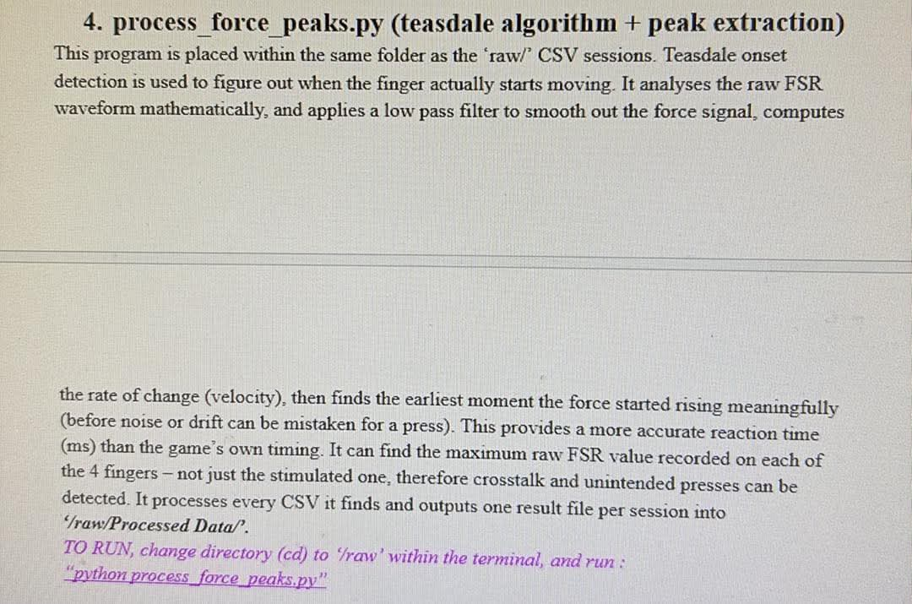
app/docs/research/rayan/ss1.jpeg
