basil2fxs/Hand-Rehab-Thesis/app/docs/research/rayan/ss2.jpeg

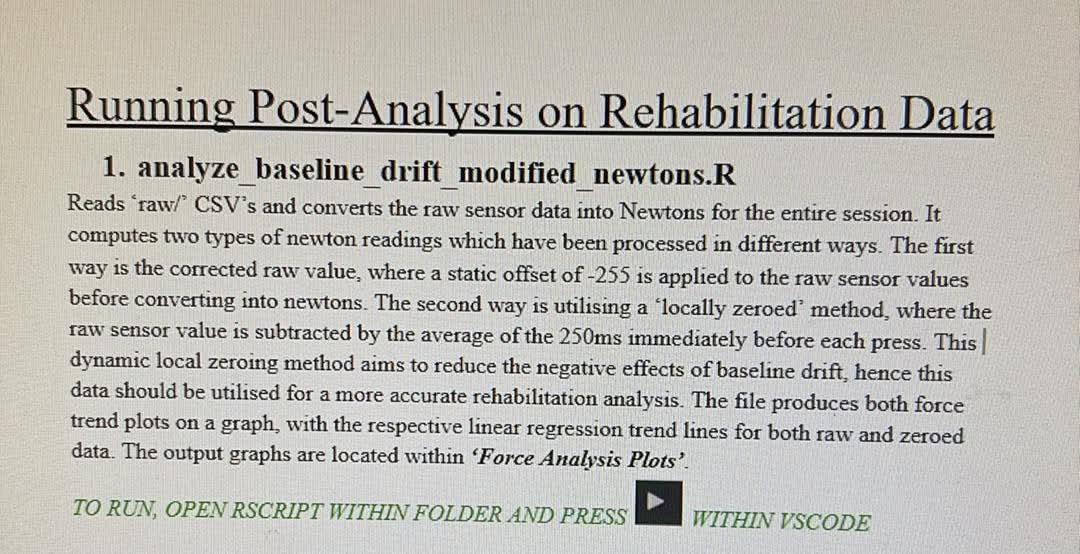
app/docs/research/rayan/ss2.jpeg
