basil2fxs/Hand-Rehab-Thesis/app/docs/research/rayan/ss3.jpeg

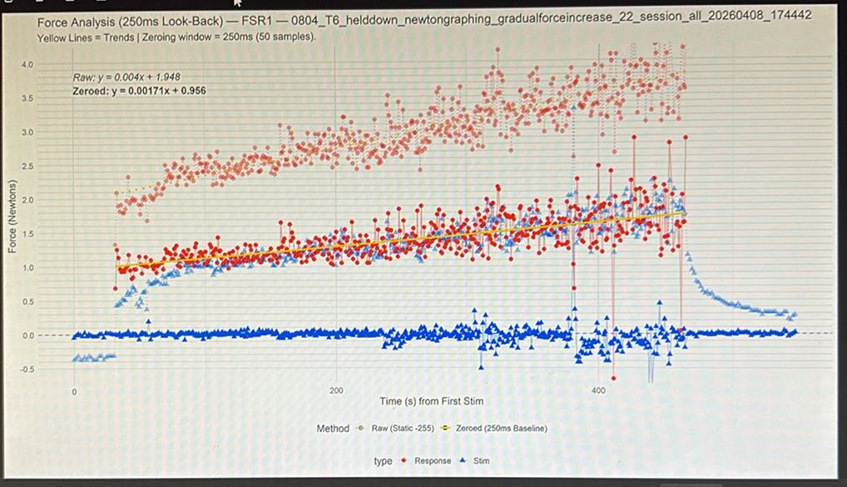
app/docs/research/rayan/ss3.jpeg
