basil2fxs/Hand-Rehab-Thesis/hardware/images/chassis_left_right.png

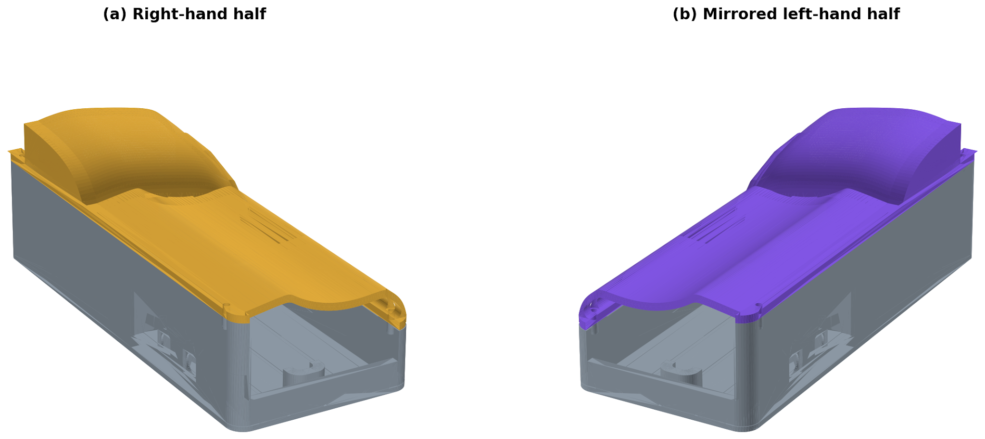
hardware/images/chassis_left_right.png
