basil2fxs/Hand-Rehab-Thesis/hardware/images/chassis_section.png

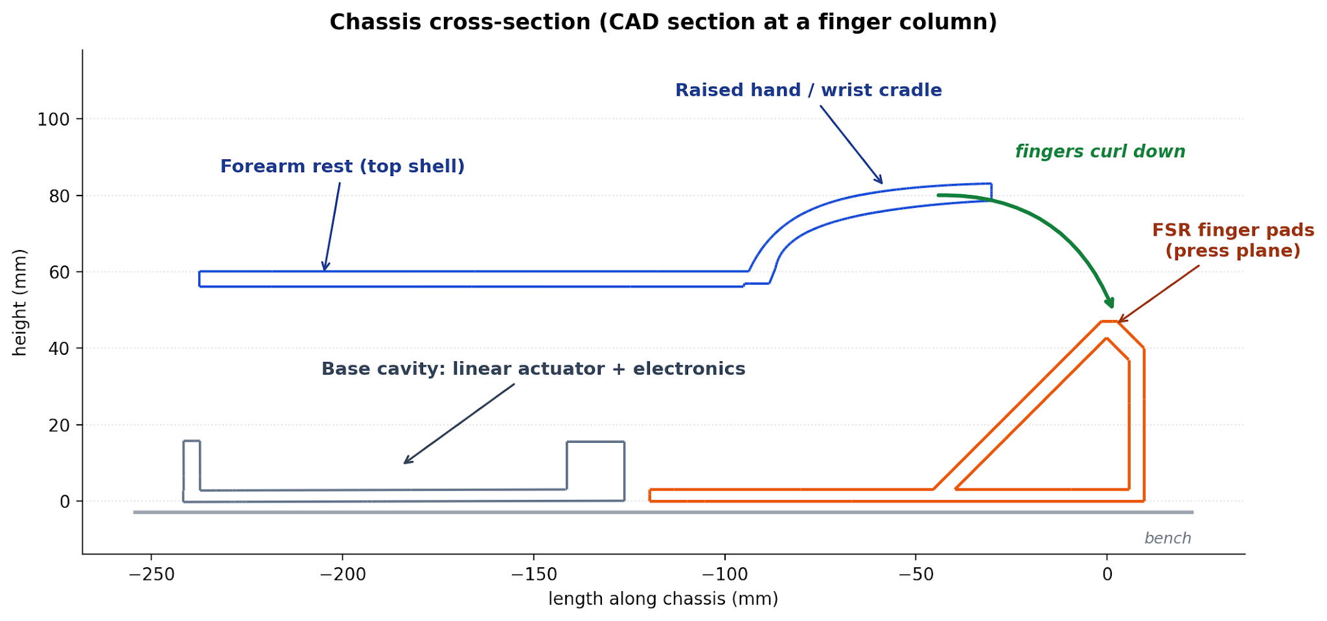
hardware/images/chassis_section.png
