basil2fxs/Hand-Rehab-Thesis/hardware/images/parts_and_wiring.jpg

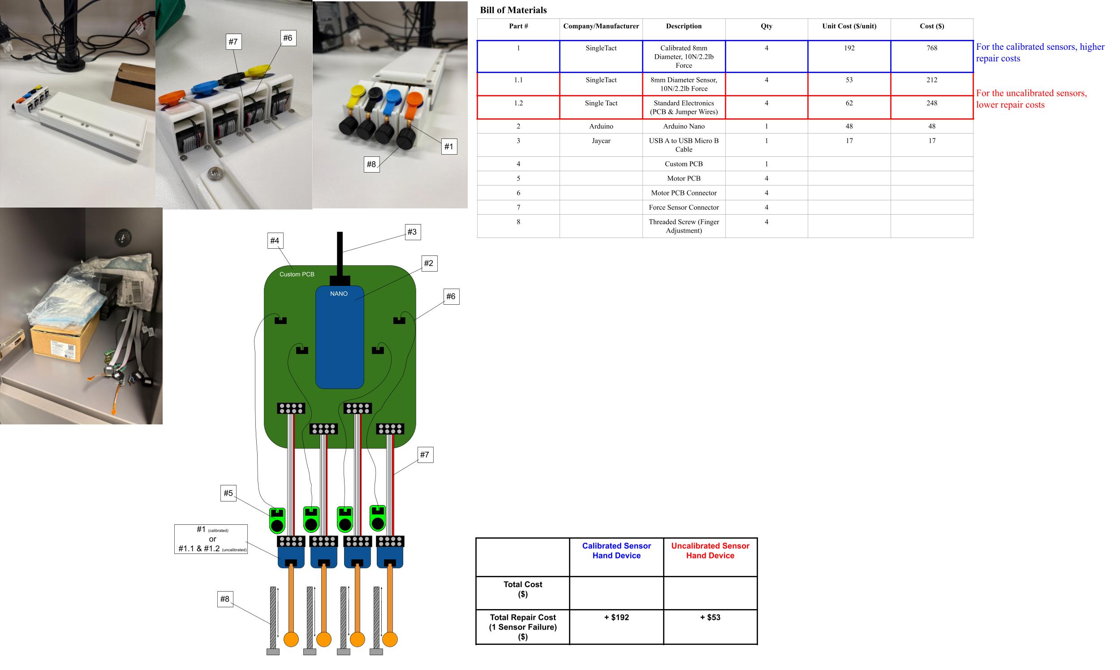
hardware/images/parts_and_wiring.jpg
