basil2fxs/Hand-Rehab-Thesis/hardware/cad/base.stl

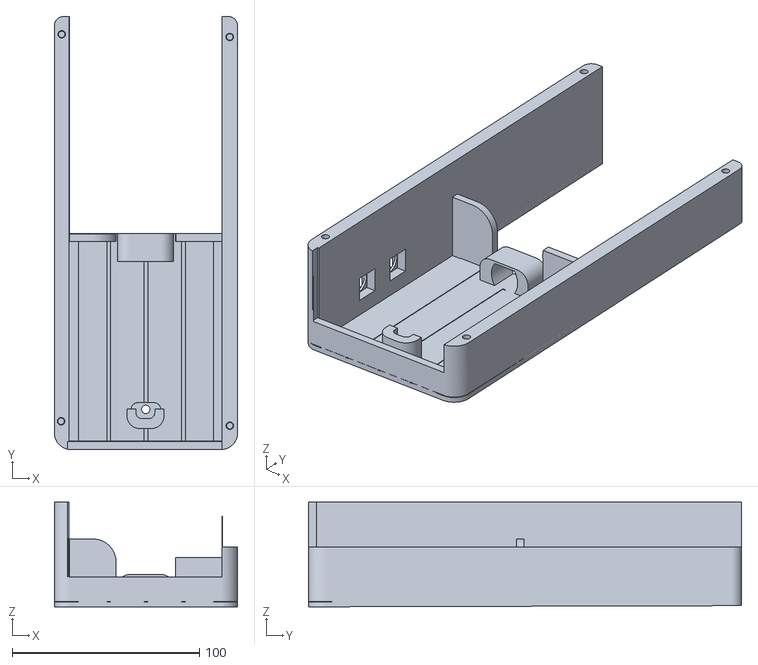
[picture p29: CAD file, 2026-09-28]
hardware/cad/base.stl
98.1 x 231.4 x 56.0
