basil2fxs/Hand-Rehab-Thesis/hardware/cad/top.stl

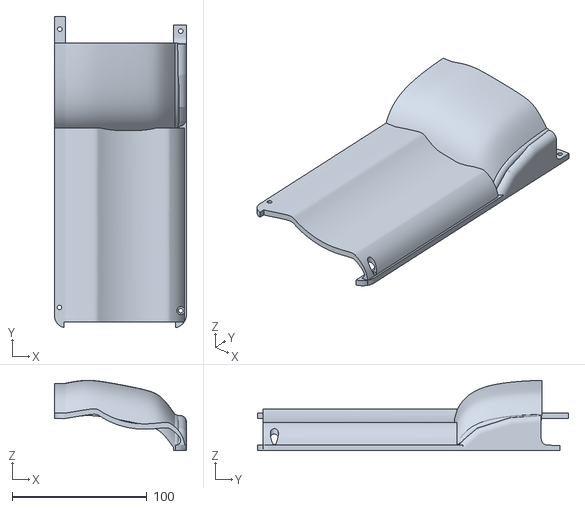
[picture p30: CAD file, 2026-09-28]
hardware/cad/top.stl
98.1 x 231.3 x 52.2
