basil2fxs/Hand-Rehab-Thesis/hardware/cad/fingers.stl

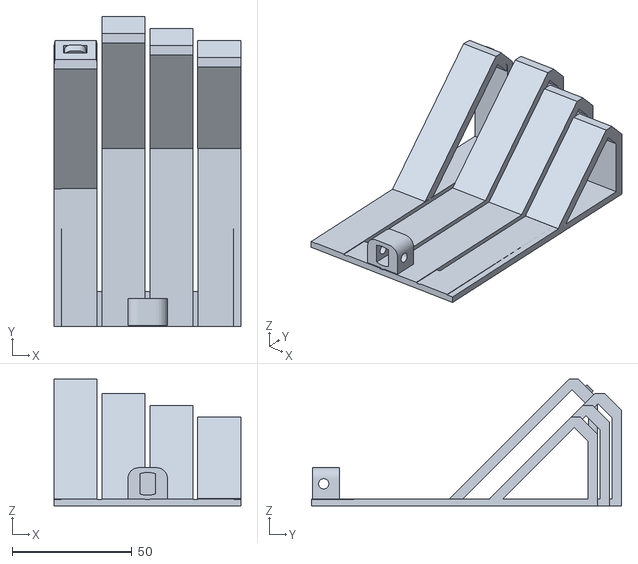
[picture p31: CAD file, 2026-09-28]
hardware/cad/fingers.stl
78.0 x 129.5 x 53.0
