basil2fxs/Hand-Rehab-Thesis/(list of files, cad)

Other CAD files:
hardware/cad/hand_device_v1.f3d
