basil2fxs/Hand-Rehab-Thesis/app/docs/images/reaction_setup.png

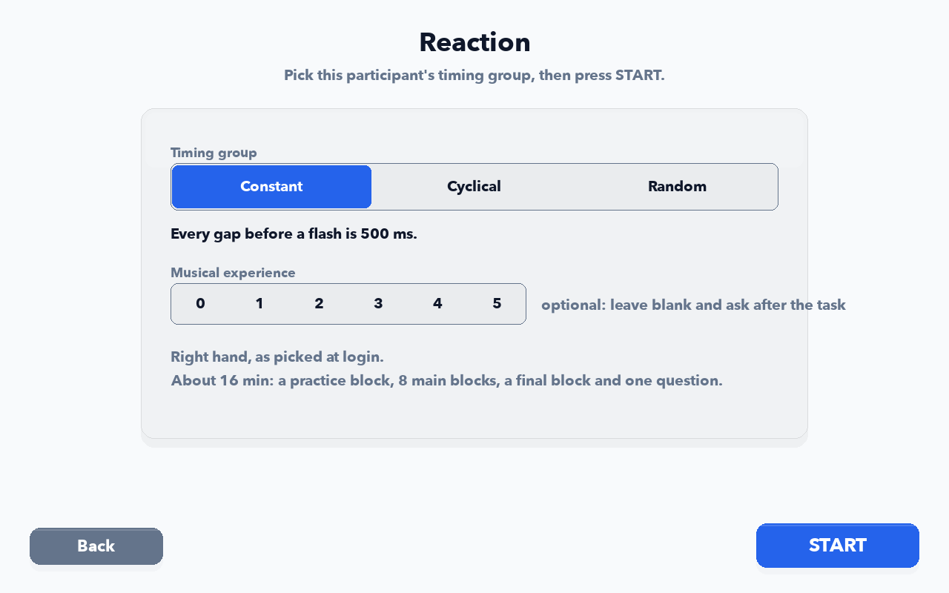
app/docs/images/reaction_setup.png
