basil2fxs/Hand-Rehab-Thesis/app/config/calibration/audio_latency_20260924_121500.csv

path | take | to_mic_ms | strength | usable
song | 1 | 112.56 | 8.6 | True
song | 2 | 121.43 | 8.9 | True
song | 3 | 113.24 | 8.8 | True
song | 4 | 119.55 | 8.5 | True
song | 5 | 118.21 | 9.0 | True
click | 1 | 102.29 | 255.1 | True
click | 2 | 110.48 | 330.4 | True
click | 3 | 115.56 | 270.2 | True
click | 4 | 102.24 | 355.9 | True
click | 5 | 108.71 | 242.2 | True
