basil2fxs/Hand-Rehab-Thesis/archive/old_test_sessions/NA_004804_reaction/raw.csv

iso_ts | t_perf | sample_idx | fsr1 | fsr2 | fsr3 | fsr4 | fsr5 | fsr6 | fsr7 | fsr8 | hand | event | lane | detail
2026-08-24T00:48:04.957 | 218859.524260 | 1 | 0 | 0 | 0 | 0 | 0 | 0 | 0 | 0 | right | block_start |  | reaction
2026-08-24T00:48:04.958 | 218859.524653 | 2 | 0 | 0 | 0 | 0 | 0 | 0 | 0 | 0 | right | reaction_config |  | seed=1 sub_mode=choice level=1 window_s=2.0
