basil2fxs/Hand-Rehab-Thesis/archive/old_test_sessions/NA_004756_mirror/raw.csv

iso_ts | t_perf | sample_idx | fsr1 | fsr2 | fsr3 | fsr4 | fsr5 | fsr6 | fsr7 | fsr8 | hand | event | lane | detail
2026-08-24T00:47:56.856 | 218851.422363 | 1 | 0 | 0 | 0 | 0 | 0 | 0 | 0 | 0 | both | block_start |  | mirror
2026-08-24T00:47:56.856 | 218851.422871 | 2 | 0 | 0 | 0 | 0 | 0 | 0 | 0 | 0 | both | stim | 3 | trial_id=1
2026-08-24T00:47:56.856 | 218851.422871 | 3 | 0 | 0 | 0 | 0 | 0 | 0 | 0 | 0 | both | stim | 7 | trial_id=1
