basil2fxs/Hand-Rehab-Thesis/app/config/default.yaml

# Default config. Override by passing --config path/to/your.yaml.

session:
  data_dir: sessions
  # Where the calibration store lives. null means the usual
  # config/calibration next to the app, so a hand's profile survives a
  # restart. Point it somewhere else for a headless run: Force Pilot's
  # max-press probe saves the profile back mid-block, so a timing or
  # simulation run started from a checkout would otherwise leave the
  # tracked config/calibration/current_<hand>.json modified.
  # scripts/measure_battery.py and scripts/simulate_cohort.py set it to
  # their own temp tree for exactly that reason.
  calibration_dir: null
  participant: null
  # Age captured on the title screen alongside the participant name.
  # Kept as a string so the JSON round-trips raw user input (e.g.
  # "65y" or "NA"). An empty value means "not provided".
  age: null
  # ---- participant details, set these before a participant session --
  # Recorded into metadata.json. They cannot be recovered afterwards,
  # and some analyses cannot run without them.
  #
  # affected_side matters most. Bilateral asymmetry is a signed number,
  # so pooling a cohort where some people are impaired on the left and
  # some on the right cancels the group mean toward zero and reads as
  # no asymmetry when it is actually large. Recording the side lets the
  # analysis flip the sign per participant.
  affected_side: null        # left | right | null when not applicable
  dominant_hand: null        # left | right
  # Impairment score at consent, e.g. "Fugl-Meyer UE 42/66". Free text
  # so the scale is recorded alongside the number. Needed to show the
  # cohort matches the moderate-impairment population the 65 to 80
  # percent challenge band was chosen for.
  impairment_score: null
  # Hand measurements in mm for the ANSUR II percentile check behind
  # the chassis sizing objective.
  hand_length_mm: null
  hand_breadth_mm: null
  # ---- intake fields the login screen collects ----------------------
  # Every one of these is typed or picked on the login screen and
  # lands in metadata.json; set them here only to pre-fill the screen
  # (a per-participant yaml passed as --config, say). The login value
  # always wins over the file.
  sex: null                  # female | male | other | null (not said)
  edinburgh_lq: null         # Edinburgh short-form LQ, -100 to 100
  visit: null                # visit number in a repeated study
  # Per-participant preferences (today: the menu music mute), keyed by
  # the same identity the session folders use. Kept apart from
  # user_settings.yaml because that file describes the machine and is
  # snapshotted into every session's metadata; a mute is one person's
  # choice and follows that person. Written by the app; see
  # finger_rehab/data/prefs.py.
  prefs_file: config/participant_prefs.json

report:
  # Build researcher outputs at the end of every block: report.html,
  # summary.csv and charts/ inside the session folder, plus one line
  # per block in sessions/sessions_index.csv. Needs matplotlib for the
  # charts; tables still generate without it. Set false to skip.
  enabled: true

serial:
  port: auto
  baud: 115200
  read_timeout_s: 0.02
  open_retries: 3
  open_retry_delay_s: 1.0
  # Explicit per-hand port assignments. When set, these override the
  # auto plug-order assignment (first detected = right, second = left).
  # Set from the Settings screen on the title page, persisted to
  # config/user_settings.yaml. null means "auto-pick". A saved port
  # the OS can no longer see is ignored at boot and that hand falls
  # back to plug order, because port names change between plug-ins
  # and a stale entry must not block the session.
  left_port: null
  right_port: null
  # Watch for boards being plugged in while the app is running. With
  # this on, an Arduino plugged in at the login screen, on the hub, on
  # Settings or between two games connects itself and takes the hand
  # the rules above give it, with no Refresh press. A board that
  # arrives mid-game waits for the game to end rather than swapping
  # the source out from under a running trial. Set false on a rig
  # where scanning the USB bus is unwelcome; the Settings screen's
  # Refresh button still works either way.
  autoconnect: true
  # Seconds between port scans. The scan runs on its own thread so the
  # frame never waits on it. A second reads as instant to a person and
  # costs nothing; values under 0.1 are clamped so a typo cannot turn
  # the watcher into a spin loop.
  autoconnect_poll_s: 1.0
  vendor_ids:
    - "0x2341"   # Arduino LLC
    - "0x239A"   # Adafruit
    - "0x10C4"   # SiLabs CP210x
    - "0x1A86"   # CH340
    - "0x0403"   # FTDI

autostart:
  # Start the game by itself when a board is plugged in. The installer
  # turns this on and the Settings screen can toggle it later; nothing
  # here runs unless the watcher has been registered with the operating
  # system.
  #
  # How often the watcher looks for a board, in seconds. Listing the
  # serial ports costs well under 2 ms, so once a second is responsive
  # without being noticeable. Below 0.1 is clamped, since a spin loop
  # on a clinic laptop would be worse than a slow start.
  poll_s: 1.0

firmware:
  # One-click flashing from the Settings screen. The hexes are built by
  # builds/build_firmware.py (CI does it on every push) and the avrdude
  # that writes them ships inside the exe and the .app, so a clinic PC
  # needs neither PlatformIO nor the Arduino IDE installed.
  #
  # Paths are relative to the app's own files (the bundle when frozen,
  # the repo root from source), not to the sessions folder.
  game_hex: assets/firmware/finger_rehab_nano.hex
  addr_tool_hex: assets/firmware/singletact_address_change.hex
  # auto = the bundled avrdude, else a full path to an avrdude binary.
  avrdude: auto
  # Which Nano bootloader to try first. Official boards from 2018 on are
  # 115200 (Optiboot); older boards and most clones are 57600. The hex is
  # identical for both and a board cannot be asked which it has, so the
  # flasher tries the other one on a sync failure and remembers the
  # winner in user_settings.yaml as firmware.preferred_baud.
  baud_order: [115200, 57600]
  preferred_baud: null
  flash_timeout_s: 90
  # How long to wait for the board to print its start-up line after a
  # good write. The game firmware's self test alone takes about 2.6 s.
  banner_timeout_s: 6.0
  game_banner: "### Setup Complete ###"
  tool_banner: "### ADDR TOOL"

eeg:
  # EEG trigger markers. When enabled, every event the analysis wants
  # to epoch on (stimulus onsets, presses, block boundaries, pauses)
  # is written to a trigger box on its own serial port as a single
  # byte, held for pulse_ms and then reset to 0. The code map lives in
  # rehab/hardware/eeg_trigger.py (CODES); every emission is also
  # logged as an "eeg" event row in raw.csv with the intended-event
  # and wire timestamps, on the same clock as the force samples.
  #
  # Shipping default is OFF: a normal rehab session has no amplifier
  # and pays nothing for this block existing. The lab preset
  # (config/eeg_lab.yaml, which the lab folder's exe and
  # run_in_psychopy.py load) flips it on over these defaults.
  enabled: false
  # The trigger box's serial port, e.g. COM10 on the lab's Windows
  # desktop. This is a SECOND port, separate from the Arduino sensor
  # ports; null plus enabled true runs the logging-only dummy backend.
  port: null
  # Virtual COM trigger boxes ignore baud; real UARTs need it to match.
  # Never 1200: the NeuroSpec MMBT-S resets and drops off the bus at
  # that rate (its manual, section 3.3), so the writer refuses it. The
  # lab preset sets the box's documented 9600.
  baud: 115200
  # true (the lab preset): refuse to start without an openable trigger
  # box, so a lab session can never run silently unmarked. false: fall
  # back to the dummy backend and say so at startup, which is right
  # for development and demos.
  require_port: false
  # Let a running EEG simulator (utils/eeg_simulator.py) stand in for
  # a box that will not open. Off here; the lab file turns it on.
  simulator_stands_in: false
  simulator_port: 50410
  # Marker pulse width and the enforced low time between markers, in
  # milliseconds, held on the wall clock, never by frame counting (the
  # old lab script counted frames and delivered 1-4 ms pulses). An
  # amplifier sampling 250 Hz needs at least 8 ms to guarantee two
  # samples of the pulse; 10 ms clears every plausible lab rate.
  # Confirm the amplifier model and rate with Welber and record both
  # in the thesis methods before changing these.
  pulse_ms: 10
  gap_ms: 10
  # Which trigger box and which of its modes the session ran with,
  # copied into metadata.json and otherwise unused. The lab preset
  # names the MMBT-S in Pulse Mode, where the box itself holds every
  # code 8 ms and ignores pulse_ms; null here because the shipping
  # game has no box.
  box: null
  box_mode: null
  # Feedback-onset markers (140 positive / 141 negative) for FRN
  # analyses. Off until an FRN analysis is actually planned; the
  # response and stimulus bands carry everything else regardless.
  feedback_markers: false

fsr:
  num_sensors_per_hand: 4
  sample_rate_hz: 200
  # NEWTONS. The pads are SingleTact CS8-10N: calibrated 8 mm, 10 N
  # full scale, the calibration stored on the matched electronics.
  # The firmware forwards the sensor's 10-bit output untouched. The
  # SingleTact manual gives the conversion
  #     Load (N) = (counts - baseline counts) / 512 counts x rating (N)
  # so one count is 10 / 512 = 0.01953 N (51.2 counts per newton).
  # The baseline term is the detector's tracked resting level (the
  # EMA below, primed from the calibration profile and frozen at each
  # press's rising edge), so the constant is a slope only: the
  # sensor's 256-count zero offset, the pad's chassis preload and the
  # finger's resting load never reach a newton figure. The raw fsr1-8
  # columns stay raw counts; peak_force_n and impulse_n in trials.csv
  # and peak_force_mean / impulse_mean in the block summary are in
  # newtons whenever this key is set, and block_summary.force_unit
  # says so. Leave the key out and everything reports counts, which
  # is how sessions recorded before September 2026 read.
  #
  # Manufacturer accuracy (CS8-10N product page): linearity under 2
  # percent, repeatability under 1 percent, hysteresis under 4
  # percent, drift 2 percent of full scale per minute at half load.
  # So absolute force is good to about 0.4 N and within-session
  # comparisons to about 0.2 N; docs/research/force_units.txt has
  # the sentence for the thesis. scripts/force_check.py checks the
  # slope with known masses and can write a fitted value here.
  # Bench check: not yet run on this rig (fill in the date and slope
  # from the script's JSON when it is).
  force_calibration_n_per_count: 0.019531
  sensor_rating_n: 10.0
  counts_full_scale: 512
  # Baseline tracker. This is an EMA per sample; at the device's 200 Hz
  # the time constant is 1 / (alpha * 200) seconds. It exists to absorb
  # slow thermal and mechanical drift, NOT to follow a press.
  #
  # This was 0.02 (a 0.25 s time constant), which is faster than a weak
  # or slow press builds. The baseline chased the press upward and the
  # signal never crossed the threshold, so a patient pressing gently
  # over a second or two registered nothing at all. At 0.0005 the
  # constant is about 10 s: drift is still absorbed, presses are not.
  baseline_alpha: 0.0005
  value_alpha: 0.35
  # Press point: the share of the resting-to-light-press gap a finger
  # must cover to count as a press, and where the EEG response byte goes
  # out. Settings, Setup, Press point changes it (10 to 60 percent).
  press_fraction: 0.30
  # PRESS THRESHOLDS, measured per finger on the real device.
  #
  # Detection is relative to each sensor's own live baseline, so these
  # travel with the hardware rather than needing a fresh calibration on
  # every machine. They are set from what a hand actually does on the
  # pads, not from how hard a healthy person can press, which is what
  # makes them usable by a weak finger.
  #
  # Resting noise on this device is about 1.1 counts SD per sensor.
  #
  # MEASURED against a resting hand with tools/calibrate_rest_vs_press.py
  # (29 July 2026). Counts are above the empty-device reading:
  #
  #   finger   resting hand   gentle press   usable gap
  #   index         +2.5          +51.5          49
  #   middle        +8.9          +40.9          32
  #   ring         +11.5          +41.5          30
  #   pinky        +30.7         +145.7         115
  #
  # The earlier uniform 12 was UNSAFE: the pinky pad carries +30.7 at
  # rest, so a hand merely resting on the device sat above the trigger
  # and fired phantom presses continuously. A threshold derived only
  # from an empty device cannot see that; it has to be measured with a
  # hand in the normal resting position.
  #
  # These are RELATIVE TO THE TRACKED BASELINE, which already sits at
  # the resting level. So a trigger only has to cover the gap between
  # resting and pressing, not the absolute load on the pad.
  #
  # An earlier set added the resting load on top of a fraction of the
  # gap, which counted that load twice: the baseline had already
  # absorbed it. The pinky suffered worst, ending up needing 67% of its
  # available gap against 45% for the index: 77 counts, 1.50 N on the
  # 10 N pads. (An earlier version of this comment put that at 6.77 N
  # by assuming a 45 N part; the pads are 10 N, see the NEWTONS note
  # above.) In newtons the old trigger sat under Demouche's 2.66 N
  # healthy little-finger mean, so the fault was proportional rather
  # than absolute: a finger that had to spend two thirds of its
  # usable gap to register is a finger that misses gentle presses.
  #
  # Each trigger is now 40% of that finger's gap, with a floor of
  # (resting load + 3 SD of noise). The floor only matters in one case:
  # if a block starts with the hand off the device, the baseline
  # initialises to the empty reading, and the hand landing looks like a
  # rise. The floor keeps that below the trigger. It binds on the ring
  # finger only, and it does NOT inflate the pinky, whose 40%-of-gap
  # value already clears its resting load comfortably.
  #
  #   finger   gap   trigger   % of gap   force (10 N pads)
  #   index     49      20        40%     0.39 N
  #   middle    32      13        40%     0.25 N
  #   ring      30      15        49%     0.29 N
  #   pinky    115      46        40%     0.90 N
  #
  # HONEST LIMIT on the pinky. 0.90 N is a third of Demouche's 2.66 N
  # healthy little-finger mean, so the trigger is within reach in
  # absolute terms; the imbalance is what remains. The pinky pad reads
  # 115 counts for a press described as gentle, three to four times
  # the other fingers, which is a pad placement problem rather than a
  # patient problem. Two things fix it properly: reduce the resting
  # load on that pad in hardware, or run the in-app calibration with
  # the actual patient, which sets every trigger from THEIR light
  # press instead of from these figures.
  #
  # Anything measured by the in-app calibration overrides these. Treat
  # them as the starting point for an uncalibrated device. They date
  # from the 0.40 trigger fraction; the calibration every session runs
  # now sets 0.30 of the gap, capped (calibration_profile.py), so a
  # calibrated hand triggers more easily than these figures.
  #
  # RELEASE VALUES ARE CAPPED BY THE DETECTOR, so they are written here
  # already capped rather than being silently rewritten at runtime.
  # FSRDetector computes off_thr = min(base + off_delta, on_thr - 10). If
  # on_delta were ever under 10 that lands BELOW the baseline, and a finger
  # that has registered one press could then only release by lifting off the
  # device: it stays latched and every later trial on it scores a miss, which
  # looks like a paralysed finger rather than a threshold fault. Keeping
  # on_delta above 12 and off_delta at or under (on_delta - 10) makes the
  # release point always sit above a resting hand.
  on_delta: [20, 13, 15, 46]
  off_delta: [10, 3, 5, 23]
  # Absolute floors are a broken-sensor guard, not part of normal
  # detection. Real baselines sit at 235-260, so 150 never binds during
  # a session; it only stops a sensor whose reading has collapsed to 0
  # (an I2C fault, which the firmware reports as 0) from registering
  # phantom presses. abs_off_max is set high so it never clips release.
  abs_on_min: [150, 150, 150, 150]
  abs_off_max: [1000, 1000, 1000, 1000]
  debounce_ms: 100
  # What counts a press (3 November 2026). Every session before then
  # counted it when the SMOOTHED value crossed the trigger, a median 5
  # to 10 ms after the raw force did and up to 35 ms on a slow press,
  # which missed the progress report's 5 ms target. "raw" counts it on
  # the second raw sample in a row at or above the trigger: one sample
  # (5 ms) after the raw crossing whatever the rise, while one noisy
  # sample still cannot count a press. Replayed over the four
  # sequence-task streams (analysis/count_rule_replay.py) it kept 4,006
  # of the old rule's 4,009 presses and added 15 that only just reached
  # the trigger, where the smoothing had held them under it, counted
  # every scored press one sample after the raw crossing, and moved the
  # four learning scores by 4 ms at most. "smoothed" restores the old rule.
  count_on: raw
  count_samples: 2
  # A finger resting on its pad above the release margin never
  # released, so its next presses went uncounted (Person 3,
  # sequence task, 15 Oct 2026). The detector now releases a
  # finger once it has sat below release_frac of its press peak
  # for rest_release_s, or after hold_max_s, and takes the level
  # it rests at as the new baseline; a baseline left above the
  # signal follows it down at baseline_down_alpha. 0 disables.
  release_frac: 0.5
  rest_release_s: 1.5
  hold_max_s: 2.0
  baseline_down_alpha: 0.05
  # The baseline follows the signal while the finger is up, so a push
  # still rising towards the trigger is partly taken into it. The ramp
  # simulation of 28 Oct 2026 found no rise over 0.8 s counted, but it
  # ran the detector's code default of 0.02 for baseline_alpha, not the
  # 0.0005 above; at 0.0005 every ramp to 3 s is counted (3 Nov 2026,
  # analysis/detector_lag_vs_rise.py). Holding the baseline once the
  # push sits baseline_hold counts above it is therefore not needed,
  # and replayed over the four sequence-task streams 5 counts added 6
  # to 25 presses a session and moved one learning score 11 ms. Off.
  baseline_hold: 0
  baseline_hold_s: 3.0

instructions:
  # Say each game's instruction aloud when its GET READY card opens, in
  # the computer's own voice (finger_rehab/audio/spoken.py), holding the
  # card until it is said. Off for the healthy study, whose sittings ran
  # without it; on for anyone who reads slowly or cannot see the card.
  # Rhythm is left out: its song starts with its countdown.
  spoken: false

quick_cal:
  # The gamified calibration that runs when a session starts, over
  # every hand the attached boards can serve, and again for a board
  # plugged in later in the session. It collects the same empty /
  # resting / light-press captures as the menu calibration and saves
  # through the same CalibrationProfile path; these knobs only shape
  # the game around that collection. Keyboard sessions never see it
  # (no force to calibrate). Set false to turn the automatic pass off
  # entirely; the hub's Calibrate button still works.
  enabled: true
  # Seconds each rest capture runs (hands off, then hands resting),
  # the same 3 s the menu calibration takes.
  rest_capture_s: 3.0
  # Seconds of heads-up each rest step gives, counted down on the ring,
  # before it captures. The steps run on the clock and judge nothing:
  # an earlier gate that waited for the pads to agree the player was
  # still and in place stalled players who were doing it right.
  lead_s: 5.0
  # Seconds a press must sit inside the target band to count. The held
  # plateau is what the light-press level is read from, so shortening
  # this below ~0.5 s starts sampling the rise instead of the hold.
  hold_s: 1.0
  # There is deliberately no target-band setting here. The band the
  # screen coaches against comes from calibration_profile.target_gap_band,
  # built out of the same constants the thresholds are computed from and
  # fed with the run's own empty and resting captures, so it moves per
  # finger with how loaded that pad is. A band set here could ask for a
  # press the threshold maths then rejects, which is the one failure the
  # screen exists to remove.

cue:
  # WHAT THE PATIENT GETS ON A TRIAL, as four switches that are each
  # on or off on their own.
  #
  # Two moments matter. BEFORE the press, something has to tell the
  # patient which finger to move. AFTER a correct press, something can
  # confirm the press landed. Each moment has a buzzer channel and a
  # sound channel, giving the four keys below. All 16 combinations are
  # valid, including all off, and every mode (classic, adaptive,
  # rhythm, mirror) honours whatever is set.
  #
  # This is the comparison the whole project line started from. Palmer
  # (2024) found reaction time differed between an LED-only cue and all
  # cues together, and the 2023 device existed to test exactly that.
  # Splitting the cue into separate channels is what lets a block
  # isolate one of them.
  #
  # Replaces the older game_cue.mode (both / visual / vibration) plus
  # motor.enabled pair. A user_settings.yaml written by that build is
  # translated onto these keys at load, so an existing setup keeps
  # behaving the same until these are set explicitly. See
  # apply_cue_migration in rehab/config.py.
  #
  # Recorded per trial in the cue_flags column so blocks run under
  # different settings can be pooled and split again in the analysis.
  # Changed from the Sensory Cues menu on the Settings screen.
  #
  # With buzz_before and sound_before shipped on, every timed mode is
  # measuring the response to an audio-tactile-visual cue, not a
  # visual one. Auditory and tactile reaction times run faster than
  # visual, so the channel mix changes what the number means, not
  # just its noise. Keep the mix constant within any comparison,
  # split on cue_flags when pooling blocks, and turn channels off
  # here for a block that needs a single-channel measure such as the
  # reaction brief's screen-only visual RT.

  # Buzzer under the TARGET finger fires when that trial's stimulus
  # fires, so the patient feels which finger to press rather than only
  # reading it off the screen. In mirror mode both target fingers buzz
  # together. Buzz length is motor.cue_ms.
  buzz_before: true

  # Cue tone plays when the stimulus fires, so the patient hears the go
  # signal. One tone per stimulus (the lowest target lane in mirror
  # mode, so two fingers do not stack two tones onto one beat).
  #
  # In rhythm mode the tone plays on every note, over the music, which
  # marks the beat the patient has to hit. It is sent latency.tone_ms
  # early so it is HEARD on the beat, like the buzz. Turn it off for
  # rhythm blocks where the song alone should carry the beat.
  sound_before: true

  # Confirmation chime after a CORRECT press, meaning the patient
  # pressed the cued finger inside the response window. Nothing plays
  # on a timeout, and nothing plays on a wrong finger.
  #
  # This switch owns the whole post-press sound channel, so turning it
  # off also silences the low thunk that plays when a miss breaks a
  # streak. Leaving the thunk on would still feed the patient
  # information through the ears after a press, which is the thing
  # this key exists to be able to remove.
  #
  # Off by default, which is a change from the build before these
  # toggles: that one chimed on every correct press with no way to
  # stop it. There is no legacy key to migrate from, so an existing
  # user_settings.yaml will not carry the chime over. Turn it on for
  # blocks where the patient should hear that the press landed.
  sound_after: false

  # Buzzer fires on the finger that was just pressed correctly, for
  # motor.cue_ms. Same rule as sound_after: correct press only, never
  # on a timeout or a wrong finger. In mirror mode both pressed
  # fingers buzz.
  #
  # Off by default, and new in this build so an older
  # user_settings.yaml has nothing to translate from either way. A
  # confirmation buzz on every correct press gets wearing over a
  # forty-trial block, and the reaction-time comparison does not need
  # it: what matters there is what the patient got BEFORE they moved.
  # Turn it on when the point is to reinforce a correct press rather
  # than to measure the response to a cue.
  #
  # One thing to watch once it is on: adaptive can reach 180 BPM,
  # which is 333 ms between stimuli, so a confirmation buzz of any
  # length runs straight into the next trial's cue buzz at the top of
  # the range. Shorten motor.cue_ms or turn this back off if the two
  # start to blur together.
  buzz_after: false

  # SCREEN REVEAL. Not one of the four switches: this is whether the
  # gameplay screen highlights the target finger, and it is kept
  # separate because the screen is always there whether or not any cue
  # channel is on.
  #
  # Off is the interesting condition for a thesis. The tile stays
  # neutral and the finger has to be found from the buzzer alone,
  # which isolates the tactile channel. It is the harder condition, so
  # expect a lower hit rate and a longer reaction time. The timing bar
  # still runs either way so the patient can see how long is left.
  #
  # Off together with buzz_before off leaves nothing at all saying
  # WHICH finger to press, only that a trial has started. The software
  # allows it; the trials will read as misses.
  show_target: true

motor:
  # How long the buzzer runs, in milliseconds. Used by both the
  # pre-press cue (cue.buzz_before) and the post-press confirmation
  # (cue.buzz_after), so the two feel like the same signal.
  #
  # The firmware drives the motor at a FIXED
  # strength: STIM_PWM = 200 is a compile-time constant and the only
  # commands it accepts are "STIM:n" and "STOP". Vibration amplitude
  # therefore cannot be changed from the host at all. What we can
  # change is duration: each STIM re-arms the motor for another 150 ms,
  # so the engine repeats pulses to hold it on for longer. That is what
  # this setting and the Settings slider control, and it is what makes
  # a cue feel stronger or gentler in practice.
  #
  # Default 250 ms, chosen from the vibrotactile literature rather
  # than from what the firmware happens to do in one pulse:
  #
  #  - About 30 ms is the minimum duration for a vibrotactile stimulus
  #    to be perceived as a vibration rather than a single pulse
  #    (Vibrotactile stimulus duration threshold, PMC11814341). 250 ms
  #    sits roughly 8x above that floor, so perception is not marginal.
  #  - Vibrotactile cueing studies use burst durations across roughly
  #    25-400 ms, so 250 ms is mid-range and not an outlier.
  #  - Cutaneous sensation is impaired in about a third of stroke
  #    patients and is 40-84% worse on the more-affected side
  #    (PMC4133225), and roughly 40% greater stimulation is needed for
  #    initial perception on the paretic hand (PMC12742966).
  #
  # That last point is the deciding one. The usual way to compensate
  # for a raised perception threshold is more intensity, but this
  # firmware fixes drive strength at STIM_PWM = 200 and exposes no way
  # to change it. Duration is the only compensating lever available,
  # so the default is set longer than a single 150 ms pulse to give a
  # patient with reduced sensation a cue they can actually feel.
  #
  # Range worth staying inside: 150 ms (one pulse, healthy sensation)
  # up to about 400 ms (upper end of the tested range; beyond this the
  # cue starts running into the patient's own response).
  # tools/calibrate_buzzers.py sets this per device and also checks
  # each motor is wired to the finger the software thinks it is.
  cue_ms: 250
  # Gap between repeat pulses when cue_ms asks for more than one. Must
  # stay under the firmware's 150 ms hold or the motor stutters
  # instead of running continuously.
  pulse_interval_ms: 120
  # How a multi-finger cue (chords mode) is buzzed on one board.
  #   together  every finger of the chord starts at once and is held
  #             out to cue_ms, so the chord is felt as one shape, the
  #             way the screen shows it. The firmware runs each motor
  #             on its own timer, so nothing in the sketch changes.
  #   arpeggio  one 150 ms pulse per finger, index to pinky, spaced by
  #             arpeggio_gap_ms. The fallback for a board that goes
  #             weak with several motors on: the firmware's source
  #             notes all four together draw more than the shared
  #             darlington driver supplies well, and the four-finger
  #             chord is the case to feel for.
  chord_buzz: together
  # The most motors one board runs at once for a chord. A chord with
  # more fingers on one board (the four-finger chord) is buzzed as the
  # arpeggio below instead, so all four never run together on the
  # shared driver. Lower it to 2 if a board goes weak on triples.
  chord_max_together: 3
  # Silence between the pulses of an arpeggio cue (chord_buzz:
  # arpeggio only). At 40 ms a four-finger cue spans about 720 ms.
  # Raising it makes the fingers easier to tell apart and the cue
  # slower; do not go below about 20 ms or the pulses blur together.
  arpeggio_gap_ms: 40
  # PER-FINGER BUZZ LENGTH, one entry per finger in the order
  # index, middle, ring, pinky. Empty falls back to cue_ms for all four,
  # which is what ships and what should normally be used.
  #
  # LEAVE THIS EMPTY unless you have a reason. Every finger gets the same
  # cue length on purpose. A longer buzz is a different stimulus, and the
  # analysis compares reaction time BETWEEN fingers, so a finger cued for
  # longer than its neighbours would look different for a reason that has
  # nothing to do with the patient.
  #
  # The pinky motor being weaker is handled where it belongs, in the
  # firmware: MOTOR_PINKY_PWM is 240 against 200 for the other three, in
  # arduino/firmware_on_device/lib/Config/Config.cpp. If it still feels
  # faint, raise that and reflash rather than stretching the cue here.
  #
  # Clamped to 80% of game.trigger_interval_s if set, so a long cue
  # cannot still be running when the next trial starts.
  cue_ms_per_finger: []
  # WHICH STIM CHANNEL DRIVES WHICH FINGER.
  #
  # The firmware maps STIM:1..4 onto its motor pins in a fixed order,
  # so if a motor is wired to a different pin than that order assumes,
  # the wrong finger buzzes. Rather than touch the sketch, the host
  # sends whichever channel actually reaches the finger it means.
  #
  # The firmware now on the device (arduino/firmware_on_device) drives
  # index D11, middle D10, ring D9, pinky D6, and its motorPins array is
  # in finger order, so straight through is correct for it. The earlier
  # handover sketch drove D3 to D6 instead, which is why nothing buzzed
  # on this wiring: only the pinky pin overlapped.
  #
  # Read this as: to buzz the INDEX finger send STIM:<first entry>,
  # for MIDDLE send STIM:<second>, and so on. The default 1,2,3,4 is
  # the straight-through case where the wiring matches the sketch.
  #
  # Discover the real mapping with tools/calibrate_buzzers.py, which
  # buzzes each channel and asks which finger you felt. It writes the
  # result here so the game uses it from then on.
  channel_map: [1, 2, 3, 4]

bilateral:
  hand: right            # right | left | both
  per_hand_calibration: true

game:
  # EQUAL PRACTICE PER FINGER.
  #
  # Every cross-finger comparison in the analysis assumes each finger got a
  # comparable number of attempts. A finger cued half as often has an average
  # built from half the samples, so a difference between fingers ends up
  # reporting how often each was asked rather than anything about the hand.
  #
  # With this on, classic, rhythm and bilateral give every finger the same
  # number of cues, and bilateral gives both hands the same number too. The
  # order stays unpredictable: a fixed order lets the patient anticipate the
  # cue, which turns a reaction time into a measure of rhythm.
  #
  # Adaptive is different. It deliberately gives a struggling finger more
  # practice, which is the point of the mode, so it keeps its weighting and
  # only puts a floor under each finger (see adaptive.min_finger_share).
  #
  # Turn this off to go back to the old fixed pattern from game.pattern.
  balance_targets: true
  mode: adaptive         # reaction | classic | adaptive | rhythm | mirror
  # Classic-mode pacing. 1.2 s between stim onsets + 1.0 s timeout means the
  # patient has up to ~2.2 s per trial, which is comfortable starting pace
  # for most patients. Adaptive mode ignores trigger_interval_s and
  # drives cadence from the engine's BPM instead.
  trigger_interval_s: 1.2
  timeout_s: 1.0
  early_window_s: 0.1
  total_trials: 40
  # Pre-start "GET READY" countdown (seconds): the ONE prep every mode
  # runs between pressing start and the game beginning. Gameplay-screen
  # modes and syllables show the same card; rhythm welds the same
  # seconds to the front of its note-fall timeline. Research gating
  # rides inside it rather than stacking on it (chords accumulates its
  # baseline-quiet clock during the card). Test mode trims it to keep
  # quick demos quick.
  start_countdown_s: 3.0
  # The first game of a sitting waits this long instead: the one player
  # who ran a sitting alone asked for a pause before the first trials
  # (the players' survey, Appendix M of the thesis). Test Mode still trims it.
  first_countdown_s: 8.0
  # Every enforced wait in every mode can be cut short with Space or
  # by clicking the skip control (see finger_rehab/game/rest_skip.py).
  # Waits shorter than this never draw the control: a button that
  # appears for two seconds cannot be read, let alone aimed at, and
  # one flashing between every trial of a perception or reaction block
  # would be a moving distraction next to the thing being measured.
  # The keyboard skip still works on the short ones. 2.5 is where the
  # per-trial gaps and the sit-through waits actually separate at
  # these settings; the mode-by-mode split is written out in
  # rest_skip.py. Every skip is counted in the block summary and
  # written to raw.csv, and a skip that shortens a wait protecting a
  # measurement also flags the trial it released.
  skip_chip_min_s: 2.5
  # Test Mode is a supervisor-demo shortcut. When enabled, every block
  # (classic / adaptive / rhythm) is capped at test_mode_trials trials
  # so the full pipeline (mode select -> setup -> gameplay -> results)
  # fits inside a 60-second demo. Rhythm mode trims the beatmap to the
  # first N notes; the audio still plays the full track. Researcher
  # runs should keep test_mode_enabled=false so the trial CSVs hold the
  # normal 40-48-trial blocks. Toggleable from the Settings screen.
  test_mode_enabled: false
  test_mode_trials: 6
  # Unilateral RIGHT-hand keymap. Patient rests their right hand on the
  # home row so j (index finger, closest to centre) is lane 0 and ; (little
  # finger, outer edge) is lane 3. Lanes always go 0=index..3=little.
  keyboard_map:
    j: 0           # right index
    k: 1           # right middle
    l: 2           # right ring
    semicolon: 3   # right little
  # Unilateral LEFT-hand keymap. Patient rests their left hand on the home
  # row so f (index, closest to centre) is lane 0 and a (little, outer
  # edge) is lane 3. Same lane convention as right so the rest of the game
  # logic doesn't care which hand.
  keyboard_map_left:
    f: 0           # left index
    d: 1           # left middle
    s: 2           # left ring
    a: 3           # left little
  # Bilateral keymap (both hands). Lanes 0..3 = right hand, 4..7 = left.
  keyboard_map_bilateral:
    j: 0           # right index
    k: 1           # right middle
    l: 2           # right ring
    semicolon: 3   # right little
    f: 4           # left index
    d: 5           # left middle
    s: 6           # left ring
    a: 7           # left little

adaptive:
  # Smallest share of a block any single finger is guaranteed, whatever the
  # weighting says. Adaptive mode is meant to give a struggling finger extra
  # practice, so this is a floor rather than a flattening: the weak finger is
  # still cued most, but no finger is starved to the point where its trials
  # cannot support an average.
  #
  # Without it, a 60-trial block with one weak finger left the strongest with
  # about 3 trials, roughly 5%. At 0.15 the same block gives roughly
  # 9/11/16/24 with the weak finger still on top, and only about 4 of the 60
  # picks are forced by the floor, so the weighting still drives the rest.
  #
  # Capped internally at 1/num_lanes (0.25 for one hand), which would be
  # exact balance. Set 0 to restore the old unfloored behaviour.
  min_finger_share: 0.15
  # Start slow so the patient gets confident hits before the system
  # speeds up. Lowered from 60 -> 30 BPM = 2.0 s between stimuli.
  # 60 BPM (1.0 s) was opening the first block above the comfortable
  # press cadence for stroke-rehab patients, which pushed hit-rate
  # below the 65-80% challenge-point band and bounced the engine
  # straight into recovery. From 30 BPM the patient can string a
  # streak together; the engine bumps up by bpm_step every time it
  # sees a sustained hit rate above target_high.
  start_bpm: 30
  bpm_min: 10                 # crawl mode for severe weakness (6s gap)
  # Raised from 140 with the band-keeping fix, for a headless 280 ms
  # player: its hit rate only fell back into the 65-80% band once the
  # window shrank near 300 ms, which is 180 BPM (window = cadence *
  # 0.90). No healthy four-finger hand is that fast (choice RT 343 to
  # 388 ms, Stark-Inbar et al. 2017; Deary et al. 2011): a healthy
  # hand's 72.5 percent pace falls at about 117 to 145 BPM and 0.2
  # percent of simulated healthy blocks touch the cap, so it is a
  # guard healthy hands do not reach (Adaptive review, 1 October
  # 2026). Five pilot blocks peaked at 90 to 144 BPM, none at the cap,
  # and four entered the band after the climb at trials 22 to 34.
  # Raised again to 240 on 3 November 2026: a 250 ms hand, near Person
  # 5's Reaction speed, sat at 180 with a hit rate of 0.98, outside the
  # band. With the opening climb below, simulated hands of 250 to 800
  # ms reach the band by trial 30 to 33 and hold 0.71 to 0.77
  # (analysis/adaptive_band.py).
  bpm_max: 240
  # Until the block's first miss each hit raises the pace by this factor
  # instead of the pressure rule, which took a fast hand 53 trials to
  # reach the band from 30 BPM, past the study's 40-trial block. 1.0 is off.
  fast_start_gain: 1.2
  bpm_step: 10                # base step. Scaled up when hit rate is far off.
  target_low: 0.65            # the 65-80% band; its centre is 72.5%
  target_high: 0.80
  weakness_bias: 2.5
  min_trials: 2               # two trials in total, across fingers
  block_size: 4               # regenerate the sequence + reweight every 4 trials
  # Timeout scales with cadence so a slow pace gives more time to press.
  # timeout_s = cadence * timeout_factor.
  timeout_factor: 0.90
  # A press on the previous trial's finger within this many ms of the
  # next cue is that trial's late answer, logged as late_press, not a
  # wrong finger on the new trial. Scored as a wrong finger it made one
  # slow response two misses; every such press on the pilot preceded a
  # recovery drop (Adaptive review, 1 October 2026). Presses under 100
  # ms after a cue are not responses to it, as in Reaction.
  carry_ms: 150

scoring:
  # Reaction-time bands for classic + adaptive trials. The patient's
  # press is timed from the stim firing; the band determines both the
  # outcome label shown on screen and the points awarded.
  #
  #   RT  <= perfect_ms  -> "Perfect"  +perfect_points
  #   RT  <= great_ms    -> "Great"    +great_points
  #   RT  <= good_ms     -> "Good"     +good_points
  #   RT  >  good_ms     -> "Late"     +late_points
  #   no press           -> "Miss"     +miss_points
  #
  # The 10/6/3/1 spread is intentionally wider than the historical
  # 3/2/1 - that earlier scheme made the difference between a 150 ms
  # press and a 600 ms press only +2 points, which on a single trial
  # was invisible. Now a Perfect is worth 10x a Late so the patient
  # FEELS the variance in real time.
  perfect_ms: 100
  perfect_points: 10
  great_ms: 200
  great_points: 6
  good_ms: 500
  good_points: 3
  late_points: 1
  # Missed trials + early presses default to 0 (score still won't go
  # below zero, the floor is enforced in engine._apply_wrong_penalty).
  miss_points: 0
  early_penalty: 0
  # Wrong-finger press penalty. Subtracts this many points on EVERY
  # wrong-finger press during a trial (classic + adaptive) and on
  # every unmatched press in rhythm mode. Tuned against the wider
  # point spread above: at penalty=3, mashing 3 wrong fingers costs
  # -9, which overwhelms even a great hit (+6). A Perfect (+10) can
  # still net positive with one wrong (+1), but a focused Perfect
  # (+10) always beats the spam outcome - so the dominant strategy
  # is "press one finger fast", not "mash everything". Floored at
  # score=0 so the display never goes negative. Set to 0 to disable.
  wrong_press_penalty: 3
  # Idle-press penalty. Subtracts this many points per press that
  # lands in classic / adaptive while NO trial is active (between
  # stims). Without it, mashing between trials cost nothing because
  # the press handler short-circuited. Detector debounce_ms already
  # rate-limits the spam at the hardware layer, so this just makes
  # each accepted between-trial press cost something. Smaller than
  # wrong_press_penalty (1 vs 3) because a legitimate finger fidget
  # shouldn't punish as hard as actively pressing the wrong key
  # during a trial. Set to 0 to disable.
  idle_press_penalty: 1

metrics:
  # Miss-force window. For every trial the engine tracks each finger's
  # peak reading (minus baseline) over this many milliseconds after the
  # go stimulus. On a MISSED trial it sums that peak across all fingers
  # and accumulates it, so the results screen can report how much total
  # force the patient was applying across the whole hand when they failed
  # the trial. Units are raw sensor counts (no newton calibration is
  # configured), and the value reads 0 in keyboard mode (no FSRs).
  miss_force_window_ms: 1000

mirror:
  # Bilateral synchronous pressing (not mirror therapy; mirror.py says
  # why). It opens slower than Adaptive (30): at 24 BPM the press
  # window is 2.25 s (0.9 of 60/BPM). The rest after a trial is capped
  # at 1 s from its close, so cues come about 1.5 s apart whatever the
  # pace, which here sets the window more than the cue rate. The
  # adaptive.* keys (band, bpm_min, bpm_max, bpm_step, weakness_bias,
  # timeout_factor) drive the pace from here.
  start_bpm: 24
  # Fixed-ms bound on |right press - left press|. The press window
  # above is BPM-derived and widens with a struggling patient, so it
  # cannot by itself enforce synchronous movement; this fixed gate is
  # what actually does. A pair further apart than this downgrades to
  # a Miss even if both landed inside the window. Healthy hands press
  # about 19 to 24 ms apart (Bonzano et al. 2008, 2013), so for them
  # the gate is nearly inert (0.4 percent of simulated trials); a
  # paretic hand 400 ms behind fails it on most trials, and a gate
  # that adapts per person belongs to a patient study (Mirror review,
  # 1 October 2026).
  max_async_ms: 350
  # Seed for the finger order (weakness-weighted random). Empty draws
  # a fresh seed per block and records it in raw.csv (mirror_config)
  # and the block summary, so any block is reproducible after the
  # fact; a number replays one order exactly.
  seed: null

reaction:
  # Reaction mode: a randomised wait, then press as fast as you can.
  # The baseline block that replaced Classic, so these numbers decide
  # what every cross-session comparison is made of. The research case
  # for each value lives in rehab/game/modes/reaction.py; this file
  # explains what the patient experiences.

  # choice = any of the four fingers can be cued (all fingers get equal
  # counts, order unpredictable). simple = one designated finger every
  # trial, the cleanest eye-to-hand measure. The two are different
  # measures, not difficulty levels: choice adds picking the right
  # finger on top of reacting, about 1.6 times simple RT on a visual
  # four-choice task (Deary et al 2011), likely less with the buzz on
  # the finger that must press.
  sub_mode: choice
  # Which finger simple mode uses, 1=index .. 4=little. Index by
  # default because it is usually the strongest and least impaired, so
  # the first simple blocks measure reacting, not struggling to press.
  srt_finger: 1

  # A block is this many scorable trials (a press or a timeout). False
  # starts, wrong fingers in simple mode and catch trials do not use
  # up scorable slots; attempt_cap ends the block anyway so a rough
  # day cannot trap the patient in an endless block. 25 trials runs
  # about 3 minutes, as long as the short-form vigilance test (which
  # samples about 62 RTs in that time), and stops before time-on-task
  # fatigue sets in.
  block_trials: 25
  attempt_cap: 35

  # The wait before the go signal. Drawn fresh every trial: fp_min_s
  # plus an exponential extra averaging fp_mean_extra_s, redrawn if
  # the total lands past fp_max_s. Exponential is the point, not a
  # detail: it keeps the chance of "go arriving right now" constant
  # however long the patient has waited, so watching the clock does
  # not help and the press stays a reaction. Typical waits run 2-4 s.
  # With the catch trials below that chance falls a little over the
  # wait instead, so RT rising slightly with the wait is expected.
  # fp_mode uniform swaps in a flat 2-10 s draw for blocks meant to
  # be compared against published PVT numbers.
  fp_min_s: 1.5
  fp_mean_extra_s: 2.5
  fp_max_s: 9.0
  fp_mode: exponential
  # EEG variant: set a number (e.g. 2.5) for a CONSTANT wait plus a
  # visible "Ready" cue at its onset, replacing the exponential draw.
  # The exponential keeps the hazard flat on purpose, and a flat
  # hazard suppresses exactly the expectancy ramp the CNV analysis
  # measures, so EEG reaction blocks need the predictable wait. Set in
  # config/eeg_lab.yaml; null keeps the shipped behaviour everywhere
  # else. Do not compare RTs across the two variants: a predictable
  # wait changes what the number means.
  fp_eeg_fixed_s: null

  # On this fraction of trials no go signal ever comes. Waiting it out
  # earns a small reward; pressing anyway is a false start. This is
  # what makes guessing a losing game rather than a free bet. Catch
  # trials come from the foreperiod literature (the PVT has none);
  # 10 percent matches comparable studies, and more catches inflate
  # everyone's RT and start to feel like the game is cheating.
  catch_rate: 0.10
  catch_wait_s: 8.0

  # A press under this many ms after the go signal cannot be a real
  # reaction to it (the eye-to-hand loop is not that fast), so it is
  # scored as a false start, never as a hit. Feedback for every kind
  # of false start stays gentle on purpose: stroke can impair the
  # ability to hold a response back, and punishing that invites
  # pressing harder out of stress.
  anticipation_cut_ms: 100
  # A press at or past this many ms counts as a lapse (pressed, but
  # attention had wandered). Drives level progression, not the score.
  lapse_ms: 500

  # How long the patient has to press, by level. Levels move on
  # lapse-or-miss rate: two consecutive blocks under
  # level_up_lapse_rate tighten the window one step, one block over
  # level_down_lapse_rate widens it back. The window is the ONLY
  # difficulty lever; the press threshold never changes, because a
  # harder press would change what is being measured. Progress resets
  # to level 1 when the app restarts, the safe direction to fail.
  response_windows_s: [2.0, 1.5, 1.2]
  level_up_lapse_rate: 0.10
  level_down_lapse_rate: 0.30

  # The wait only starts once every finger has rested for this long,
  # so a slow release from the last press cannot leak into the next
  # trial as a phantom false start.
  rest_gate_s: 0.3
  # How long the millisecond result stays on screen after a press,
  # how long the pause after a false start lasts (nothing is shown:
  # this mode puts no message on screen, only the RT in the corner),
  # and the blank gap before the next trial arms. Together they set
  # the cycle at roughly 6 s per trial.
  feedback_s: 1.2
  false_start_feedback_s: 1.5
  inter_trial_gap_s: 0.5

  # Set an integer to replay a block's exact wait sequence (testing,
  # or a deliberately repeated protocol). Empty draws a fresh seed per
  # block and records it in raw.csv and the block summary, so any
  # block can still be reproduced afterwards.
  seed: null

srt:
  # The lab's serial reaction time task, Welber Marinovic's PsychoPy
  # script (archive/Webler EEG past program/SRT_Sequence_learning_
  # Final_v2.py) replicated trial for trial in modes/srt.py. It is the
  # Reaction card on the hub. The healthy study battery still plays
  # the reaction block above; the EEG lab's Lab session plays this.
  #
  # The part the lab varies between groups (timing group, learning
  # interval, sequence) is the SETUP, chosen on the setup screen the
  # card opens and kept once per computer (srt_setups.json in
  # ProgramData\Finger Rehab on Windows, /Users/Shared/Finger Rehab
  # on a Mac), so the group last picked is the next participant's,
  # whichever build runs, until someone picks another. Everything
  # below is the lab's
  # protocol, as the script has it: change a number here and the task
  # is no longer the lab's.
  random_trials: 48        # practice and post-test, 12 per square
  learning_blocks: 8
  learning_reps: 10        # sequence repeats per learning block
  random_isi_ms: 500       # random blocks always run at 500 ms
  first_wait_ms: 1000      # before the first trial of every block
  flash_ms: 100            # the red square
  deadline_ms: 2500        # after the flash: 2.6 s from onset in all
  anticipation_ms: 100     # presses this close before a flash count
  miss_pause_ms: 200
  feedback_ms: 200         # practice only: Correct, Incorrect, Miss!
  recall_select_ms: 150    # yellow flash on each recalled square
  saved_hold_s: 1.5        # "Sequence recorded" before the thank you
  # The lab's four tones, one per square left to right (assets/srt).
  tone_dir: assets/srt
  tone_files: [V.wav, B.wav, N.wav, M.wav]
  tone_volume: 1.0
  # Play the tone this many ms before the flash is drawn. The script
  # played it as the flash was drawn (0). Set it to the machine's
  # measured tone delay (latency.tone_ms) to make the sound and the
  # red square reach the participant together.
  tone_lead_ms: 0
  # EEG: the byte on the flip that shows the red square, the one the
  # lab's pipeline epochs on. Nothing else per trial unless
  # response_markers is on (100, 110 and 120 bands, and 130 for a
  # miss); every RT is in the exported CSV either way.
  stim_code: 30
  response_markers: false
  # Words under the squares. Empty: the hand's own keys on a keyboard,
  # the finger names on the pads.
  labels: null
  # lab: the script's own display, a black page and four grey squares
  # near the centre turning red, at the script's sizes and colours, on
  # every build (Basil, 8 October 2026: the Reaction card looks as the
  # lab's PsychoPy program did). app: the finger cards on the light
  # page, the look from 28 September to 8 October 2026. Timing is the
  # same in both.
  look: lab
  # A small patch in the bottom-left corner on flash frames only, for
  # a light sensor timing the flash against the 30 on the amplifier
  # (docs/eeg_lab_setup.txt, the timing check). In the lab look the
  # red square is about as bright as the grey one, so a sensor on the
  # square itself would see little. Off for every participant.
  photodiode_patch: false
  # Where the setups live. Empty means the computer's own file above,
  # or config/srt_setups.json under the data root when that folder
  # cannot be written. Tests point it at a temporary folder.
  setups_file: null
  # Set an integer to redraw a session's random blocks and random
  # intervals exactly. Empty draws a fresh seed and records it.
  seed: null

pattern:
  # Patterns mode: the patient records "takes" of a piano riff, one
  # key lighting at a time, press it and the next follows half a
  # second later. Hidden inside most takes is a repeating sequence: 12
  # notes over one hand's four fingers, or 24 notes over all EIGHT
  # fingers when Both hands is selected, with the hands cued equally
  # every loop. Two takes per session secretly switch to unfamiliar
  # material, and how much the patient slows down on those is the
  # measurement. The research case for every number lives in
  # rehab/game/modes/pattern.py; this file says what the patient
  # experiences. One thing is non-negotiable at the bench: never tell
  # the patient a pattern exists. Knowing about it makes the learning
  # worse after stroke, not better.

  # A take is 4 loops of the 12-note sequence = 48 presses, under a
  # minute. Ten takes plus the warm-up run about 10 to 18 minutes
  # depending on the patient's pace. 48 is near the 50-trial blocks of
  # Oliveira et al. (2024), whose probabilistic task ran 1,000 trials a
  # session (the study battery plays 3 loops, 36), and the first loop
  # of every take still
  # leaves 36 presses for the take's RT mean. It was 5 loops (60),
  # which players found long. With Both hands the loops are twice as
  # long, so the mode halves this (4 -> 2 loops of 24 = 48 presses).
  soc_cycles_per_block: 4
  # Settling-in presses before the first take. Not analysed; they let
  # the hand find the keys and surface any calibration problem before
  # data that matters. One loop's worth.
  warmup_trials: 12
  # Take 1 is mixed-up material every session: it tracks how fast the
  # patient is in general, so later sessions can tell "faster overall"
  # apart from "knows the riff". A multiple of 8 so the shuffle-bag
  # balances both hands exactly in bimanual play, not just the 4-lane
  # unilateral case; changing this away from a multiple of 8 still
  # runs, but bimanual hand balance is then only within one trial.
  # 48, the same length as every other take.
  random_block_trials: 48
  # How many unfamiliar sequences the patient's pool holds. Which two
  # a session uses rotates block to block so none of them gets
  # familiar. Some participants' material only admits 3; the pool
  # then holds 3.
  probe_pool_size: 4
  # Gap between the patient's press and the next key lighting. Fixed
  # on purpose: the rhythm of the game must never change for a
  # participant, or their speed changes for reasons that have nothing
  # to do with learning.
  rsi_ms: 500
  # How long a key stays lit waiting for its press. 2000 suits most
  # patients; raise to 3000 for slower stroke-affected hands. Set it
  # once per participant and leave it.
  timeout_ms: 2000
  # An 8-take session for patients whose stamina will not carry ten.
  # Both hidden-switch takes keep a familiar take on each side, which
  # the scoring needs. The short session skips the long mid-session
  # rest: in eight takes there is no spot where the extra rest cannot
  # lean on the scoring, so every break uses the same floor.
  short_session: false
  # Rests between takes: the patient advances with any press once the
  # floor has passed. Rest length does not change the learning
  # (varied 15 s / 30 s / self-paced in a 268-person study with no
  # difference), so the floor is for recovery and comfort. The longer
  # rest lands after the sixth take, mid-session, where the fresh
  # burst of speed a rest hands the next take cannot touch the takes
  # the scoring compares. A patient who wants more rest simply waits:
  # the floor is a minimum, never a push.
  rest_min_s: 10
  long_rest_s: 30
  # Five lit keys in a row with no press at all reads as a tired hand:
  # the game inserts a proper rest, longer than the between-take floor
  # because its job is recovery. A second such run ends the session
  # gracefully with the data kept. Slowing on the hidden-switch takes
  # never counts toward this.
  fatigue_timeout_run: 5
  fatigue_rest_s: 45
  # Whole-session ceiling. The session ends politely at the next press
  # after this many minutes, however far it got.
  session_cap_min: 30
  # Set an integer to replay a block's exact random material and
  # probe rotation (testing, or a deliberately repeated protocol).
  # Empty draws fresh each block and records it in raw.csv and the
  # block summary. The riff itself is NOT affected: that comes from
  # the participant name so it is the same every session.
  seed: null

  # ---- researcher-supplied sequence file --------------------------
  # A sequence file, once loaded, replaces the hidden riff and the
  # ten-take layout with the blocks and timings it describes, for
  # every Muscle Memory block until it is replaced or cleared on
  # Settings. Load one by dragging it onto the game window on a menu
  # screen, by saving it into the drop folder below as current.yaml,
  # or with Load pattern file on Settings. Nothing here is per
  # participant: the file describes the TASK, so everyone on this
  # machine plays the same one.
  # The loaded copy and its pointer, both written by the app.
  sequence_file: config/pattern_sequence.yaml
  sequence_pointer: config/pattern_sequence.json
  # Where Settings writes the templates, where a file saved as
  # current.yaml is picked up on its own, and where every import is
  # archived with a timestamp under history/.
  sequence_drop_dir: config/pattern_sequences
  # false pins the built-in riff even when a file is loaded, for a
  # study preset that needs the shipped material whatever is on the
  # machine.
  sequence_file_enabled: true

chords:
  # Chords mode: two, three or four fingers pressed together, and the
  # fingers that were NOT asked are scored on staying still. A few
  # single fingers are dealt among the chords as the baseline (see
  # size_mix), no combination repeats twice running, and every finger
  # gets a fair share of work. The research case for
  # every number lives in rehab/game/modes/chords.py; this file says
  # what the patient experiences. One engine block is a whole
  # session: five rounds of chords with proper rests. With Both hands
  # selected the hands take turns on within-hand chords with equal
  # counts, and the third and fifth rounds ask for chords that SPAN
  # the hands (one or two fingers per hand), so both hands play the
  # whole session and the session also measures how well the hands
  # work together. Light presses only, everywhere: the game never
  # rewards pressing harder, and pressing much harder than the
  # calibrated light press is recorded as over_force (no prompt is
  # shown).

  # How long the fingers have to land the chord once it lights up.
  # Generous on purpose: a slow chord still teaches the shape, and the
  # togetherness score is about the gap BETWEEN the fingers, not about
  # answering fast.
  timeout_s: 3.0
  # How many trials of each size one bag of twenty deals, sizes 1 to 4.
  # Twenty is one round (trials_per_subblock), so every round gets
  # exactly this mix: four single fingers (one per finger, the
  # baseline the chord cost and the one-finger leak matrix are read
  # from), ten pairs, five triples and one four-finger chord. Most of
  # the work is two or three fingers, where every chord has a quiet
  # finger to keep still; the four-finger chord has none and drives
  # every motor at once, so it stays rare. Other sizes than the
  # commonest never come up twice in a row.
  size_mix: {1: 4, 2: 10, 3: 5, 4: 1}
  # How close together the finger presses must land to count as "one
  # chord", in milliseconds, from easiest to hardest. The game starts
  # at the first value and only tightens when the patient is landing
  # 8 of their last 10 cleanly; it loosens again the same way. The
  # last value is the floor. A chord study's own criterion is 50 ms
  # (Verwey 2023), so even the floor here stays twice as soft as that.
  sync_windows_ms: [250, 200, 150, 100]
  # Once the chord is together, all its fingers stay down this long.
  # A ring fills on the held tiles while it runs, so the patient
  # watches the hold complete rather than being told about it after
  # the trial is over; a finger that lifts early breaks the hold and
  # is recorded, not named on screen.
  # Kept short on purpose: holding a press makes the unwanted leak
  # onto other fingers grow, which is the opposite of the training
  # goal. Needs the sensors; the keyboard fallback skips the hold.
  hold_ms: 200
  # The hand must be properly at rest for this long before each chord
  # fires, so every trial starts from a still hand and the leak
  # measurement means what it says. If the hand will not settle the
  # screen asks the patient to relax it rather than firing anyway.
  baseline_quiet_ms: 500
  settle_prompt_s: 5.0
  # Breathing room between trials, drawn fresh each time so the next
  # chord cannot be timed rather than reacted to.
  iti_min_s: 1.5
  iti_max_s: 2.5
  # Session shape: rounds of chords, with a floor on the rest between
  # rounds (the patient presses any finger to continue once the floor
  # has passed). 5 rounds of 20 is 100 trials, about 215 finger
  # presses under size_mix: a little under the 300 a session the
  # stroke feasibility benchmark asks for, without overstaying it.
  trials_per_subblock: 20
  subblocks: 5
  rest_between_s: 30
  # There are no single-finger warm-up presses at the start or end:
  # the few singles are dealt among the chords (size_mix), and the
  # per-finger reference the leak numbers divide by comes from the
  # quick calibration at login (the light press each finger
  # demonstrated there).
  # If a round goes clearly worse than the session's first round (hit
  # rate down 30 points, or presses 30 percent slower), the game
  # inserts this longer rest and eases the difficulty one step. A
  # second such round ends the session politely with the data kept:
  # a tired hand trains the wrong thing.
  fatigue_rest_s: 120
  # Whole-session ceiling. The session ends politely at the next trial
  # close after this many minutes, however far it got.
  session_cap_min: 30
  # Set an integer to replay a block's exact chord order and timing
  # jitter (testing, or a deliberately repeated protocol). Empty draws
  # fresh each block and records it in raw.csv.
  seed: null

syllables:
  # Syllables: a children's mode, unlike everything else in this file.
  # The child hears and sees a word, then its syllables come down the
  # screen one set at a time: four written chunks falling over the
  # four fingers of one hand, three wrong and one right, with nothing
  # saying which finger is the right one. Pressing the finger under
  # the right chunk lifts it into the word at the top, and the word
  # fills up left to right. A wrong press just greys that chunk out;
  # nothing is taken away and no error sound plays anywhere in this
  # mode. If a set falls off the bottom unanswered, the right chunk
  # glows on the way out, the syllable is said again, and the whole
  # word comes back later in the block.
  #
  # With both hands connected the hands take turns WORD by word (all
  # four chunks sit over the playing hand; the resting hand shows
  # quiet dots). One hand connected plays every word on that hand and
  # loses nothing.
  #
  # The research case for every number lives in
  # finger_rehab/game/modes/syllables.py; this block says what the
  # child experiences. Two cautions carried from that file: this
  # trains an in-game skill only, it is NOT a dyslexia treatment or
  # test and must never be described to a family as one; and the
  # hardware was scoped for adult rehabilitation, so using it with a
  # child needs its own ethics approval, a check that small fingers
  # reach the pads, and cleaning between children.

  # Word difficulty the block starts at: A everyday words (mostly two
  # syllables), B less common (two and three), C rare and long (the
  # four-syllable words). Moves on its own during a block (8 of the
  # last 10 words finished goes up, under 5 of 10 comes down) and
  # every move is recorded. The words come from
  # assets/words/syllables_bank.json.
  band: A
  # Who the block is set up for. auto reads the intake age: 6-9 (the
  # design below, with print fading above rung 3), 10-12 and 13-15
  # (faster falls, derived words, 20 percent made-up words, a shorter
  # buzz ladder), 16+ (the word heard, not seen, no buzz, rarer
  # derived and made-up words, and the fall time as the thing
  # measured), 60+ (as 16+ with the slower teen falls and bigger
  # tiles). A blank age plays 6-9. classic is the design the study
  # pre-registered, at the slower pace set on 29 September 2026. The
  # case for every value is in
  # finger_rehab/game/modes/syllables_profiles.py.
  age_band: auto
  # The sitting in sections, for every age profile: a short review,
  # hear and pick, build the word from its syllables, then (10 to 59)
  # a speed check where a word is flashed and picked from four. The
  # chunks sit still with a time bar, two wrong presses show the
  # answer, and each word ends whole, read silently before it is
  # heard. The case for it is in
  # docs/research/new_modes/syllables-task-design.md. false plays the
  # single-section block of 29 September 2026; classic ignores it.
  sections: true
  # The reading check (the fixed probe): the same sets in the same
  # order for every session of an age group, with no prompt, replay,
  # return, points or feedback (assets/words/syllables_probe.json,
  # scripts/build_syllables_probe.py). It is the dyslexia case's
  # repeated measure; the in-game numbers adapt and cannot show change
  # across sessions (the deep review of 1 October 2026). Half its
  # words are held out of training whatever this says. case opens a
  # sitting with it only for a case reader, a code from D01 up, so
  # anyone else goes straight to the game (2 October 2026); true or
  # false force it either way. probe_only plays the check alone, for
  # baseline sessions; the card after the check waits for Start, and
  # two presses of Esc there do the same with every answer kept.
  probe: case
  probe_only: false
  # Milliseconds between syllables while the word is modelled, at the
  # least: a syllable's own sound always finishes with half a second
  # of quiet before the next. After the syllables the whole word is
  # said again (the blend). 500 until 29 September 2026, when play
  # felt rushed; 900 until 2 October 2026, when the breaks between
  # voice prompts felt a little long.
  beat_ioi_ms: 800
  # Session shape: rounds of words with a proper rest between rounds,
  # and a whole-session ceiling so an engaged child still stops in
  # time. Each finished round stamps a sticker onto the session's
  # walking strip on the rest screen, runs of words answered right
  # first time light up to three corner stars (3, 5 and 8 in a row),
  # and moving up a word band shows a one-shot Bigger words card. All
  # of it is fixed and earned, never random, and nothing is ever taken
  # away. 30 sectioned words take about 12 to 17 minutes by age and
  # reading speed (the deep review's simulation of 1 October 2026, less
  # the 4 to 7 percent the shorter gaps of 2 October save), not the 11
  # once given here; 6 to 9 plays 20 (syllables_profiles.py),
  # inside the 8 to 12 minutes GraphoGame's developers advise for
  # children. The probe comes on top.
  words_per_block: 30
  round_size: 10
  break_s: 30
  # The prompt: a set still unanswered late in its fall buzzes the
  # right finger once, and only that finger. Progressive time delay,
  # per word: a new word's prompt comes at the first share of the
  # fall in prompt_steps; each set of that word answered right before
  # any buzz moves it to the next, and past the last the word plays
  # with no prompt. A wrong first press before the buzz, or a set
  # that leaves the screen, moves it one step back. The buzz never
  # comes before this child's own median time to a first press found
  # alone (a Kaplan-Meier median over the last 12 sets, with sets the
  # buzz or the fall cut off counted as censored, once three were
  # answered alone) plus prompt_floor_margin_ms, and never after 0.9 of
  # the fall. The share of sets answered right before the buzz mixes
  # speed with accuracy, so the notebook reports it beside the time to
  # a first press and the accuracy before the buzz. prompt false turns
  # it off for the whole block.
  prompt: true
  prompt_steps: [0.6, 0.75, 0.9]
  prompt_floor_margin_ms: 300
  # Seconds the whole word is shown and spoken before the syllables
  # are modelled.
  attend_s: 3.0
  # Two touches on one finger inside this window count once. Sits on
  # top of the hardware debounce so a bouncy little finger cannot rack
  # up phantom presses.
  tap_debounce_ms: 150
  # Quiet gap between words, and the session ceiling. The block ends
  # politely at the next word boundary after the cap. 1500 until
  # 2 October 2026.
  inter_trial_gap_ms: 1300
  session_cap_min: 20

  # How hard the wrong chunks are. Rung 1 is far-off foils, a slow
  # fall and the syllable said again as the chunks appear; rung 8 is
  # foils that differ by one flipped or swapped letter, a faster fall
  # and no repeat. The game moves the rung itself: three sets right
  # first time makes it harder, one set wrong or missed makes it
  # easier, which settles near 80 percent right. Every move is
  # recorded. Change rung_min / rung_max only to pin a child inside a
  # narrower range.
  rung: 1
  rung_min: 1
  rung_max: 8
  # Seconds a set of chunks is on screen, one entry per rung. Never
  # under 4.0 (the mode clamps it): the fall is a floor for thinking,
  # not a race, and reading four chunks and comparing them takes a
  # child of this age most of a second before any deciding starts.
  # Half as long again as the first table (4.0 down to 2.5).
  fall_s: [6.0, 6.0, 5.5, 5.5, 5.0, 5.0, 4.5, 4.5]
  # Quiet gap after one set clears before the next falls. 1.0 until
  # 2 October 2026.
  set_gap_s: 0.8
  # Presses in this window after the chunks appear are recorded as
  # anticipations and ignored: the tiles are still fading in, so a
  # press that early answered a set nobody could have read. 0.2 is the
  # floor whatever is set here.
  spawn_lockout_s: 0.25
  # Which rungs say the syllable again as its chunks appear. On the
  # low rungs this makes the task recognition (easier); off it, the
  # child has to hold the word in mind, which is the harder and more
  # useful version.
  respeak_rungs: [1, 2, 3]
  # A word whose set was missed comes back after this many other
  # words, first time then second time. A third miss retires it for
  # the block. Coming back spaced out is what makes a missed word
  # worth meeting again.
  return_after: [2, 4]
  # Seconds the finished word is shown and spoken before the next one,
  # at the least. 3.0 until 2 October 2026.
  complete_s: 2.8
  # Allow the same-sound-different-spelling foil (ka for ca) at rungs
  # 7 and 8. Off by default: it can only be answered by knowing how
  # the word is spelt, which is past what this mode trains.
  homophone_foils: false
  # Both hands connected: take turns word by word (true), or play
  # every word on the main hand (false).
  alternate_hands: true
  # Was an adult sitting with the child for this session? Recorded on
  # every row. It matters: the one thing that reliably moved outcomes
  # in the review of this kind of game was supportive adult
  # interaction, so a session played alone is a different condition
  # and the analysis has to be able to tell them apart.
  supervised: true
  # Spoken words and syllables. backend auto plays a rendered file
  # when there is one and falls back to the Mac say command for
  # whoever is working on the mode; file never speaks without a
  # rendered file (the shipping setting for the lab machine, which is
  # Windows and has no say); say never reads a file; off is silent.
  # Files live under dir: <word>.wav for each word, and each word's
  # syllables as they sound in that word (the manifest's syllable_map
  # names them: a chunks/<chunk>.wav where the chunk said alone sounds
  # the same, a syllables/<word>_<k>.wav where it does not), made by
  # scripts/syllables_tts.py. A word the map does not cover plays its
  # chunks' spelt files.
  speech:
    backend: auto
    dir: assets/speech
    volume: 1.0
  # Set an integer to replay a block's exact word order, foils and
  # target fingers (testing, or a deliberately repeated protocol).
  # Empty draws fresh each block and records it in raw.csv.
  seed: null

force_pilot:
  # Force Pilot: one finger's continuous force flies a craft through a
  # scrolling corridor. The research case for every number lives in
  # rehab/game/modes/force_pilot.py; this block says what the patient
  # experiences. Needs the force pads: the mode says so on screen and
  # refuses to run from the keyboard. Session max presses are probed
  # in the mode when missing or older than six hours, and every force
  # target below is a PERCENTAGE of that finger's probed max, never a
  # raw sensor value.

  # The block is a FIXED LADDER of twelve named waves (Slow breath,
  # Tide, Swell, Stairs, Hills, Beach waves, Heartbeat, Dunes, Chop,
  # Open ocean, Storm, Uncharted), same order every play, one run per
  # level, one finger per level. The table lives in the mode file and
  # NOT here on purpose: a config edit must not be able to change the
  # levels a thesis result rests on. Both hands selected means every
  # level is flown by the first hand then the second, 24 runs.
  ladder: waves_v1
  # How many times the ladder runs inside one block. 1 ships; 2 gives
  # a within-block learning curve at the cost of another 6.7 minutes.
  passes: 1
  # Fly the six-wave short ladder the mode file defines (Tide, Stairs,
  # Hills, Dunes, Storm, Uncharted) instead of all twelve. Off ships,
  # and no sitting turns it on since 2 October 2026 (the 15 and the 30
  # flew it before then). The config can switch between the two ladders
  # but cannot name levels, for the reason above.
  short_ladder: false
  # Force-to-altitude mapping: 0 to span_pct of the finger's max fills
  # the screen height. Low force is where the cited deficits live, and
  # staying under half of max keeps repeated runs sub-fatiguing. The
  # ladder's own targets sit between base_pct and about base_pct + 23.
  span_pct: 40
  # The resting altitude every run opens on. Level heights in the
  # ladder are offsets from this, so moving it moves the whole ladder
  # together and nothing in a wave jumps.
  base_pct: 8
  # Stairs only: how long after each step edge is left unscored. The
  # target jumps in zero time and no finger can follow it, so that
  # window would measure reaction time, not tracking. Dropped from
  # time in corridor, error, stalls and rings, in the game and again
  # in the offline re-score.
  step_grace_s: 0.6
  # Test Mode plays these rungs only, on one hand, so a supervisor
  # demo reaches Results in a couple of minutes.
  demo_levels: [1, 4, 7, 12]
  # Visual gain magnifies the DISPLAYED error only (craft shows
  # target + gain x error; scoring always uses the true force).
  # Archer 2017 shows gain moves patient error substantially, so hold
  # it constant within any comparison; it is logged per run.
  visual_gain: 1.0
  # Rings sit on the corridor centreline and collect when the craft
  # passes them inside the corridor; each is worth ring_points on top
  # of the run outcome.
  ring_interval_s: 1.5
  ring_points: 2
  # Corridor-exit buzz: tactile error feedback on the working finger.
  # Rides the cue.buzz_after switch (so a silent-error block stays
  # separable in the CSV) with a cooldown so edge wobble cannot drone.
  exit_buzz_ms: 80
  exit_buzz_cooldown_s: 1.0
  # Max-press probe: presses per finger (median kept), the counts a
  # press must clear to count as an attempt, and how old a stored max
  # may be before it is re-measured.
  probe_presses: 3
  probe_floor_counts: 30
  probe_max_age_s: 21600
  # Between-run pacing. One card carries both halves of the old pair
  # (how the last run went, which wave is next), because the brief
  # asked for little time between runs. The only other wait is one
  # rest halfway up the ladder, which is long enough to draw the skip
  # chip; the cards are not, and keyboard skip still works on them.
  announce_s: 1.8
  # A new finger or hand fills the screen for this long instead, and so
  # does each max-press finger.
  finger_card_s: 3.0
  mid_rest_s: 15.0
  # Set an integer to replay a block's exact run plans (testing, or a
  # deliberately repeated protocol). Empty draws fresh each block and
  # records it in raw.csv.
  seed: null
  # Quiet background music during a Force Pilot block, and only there.
  # Basil asked for it: the runs are long silent holds and a track
  # keeps a block from dragging. It draws on the licensed menu
  # playlist (audio.menu_music_tracks), starts once the menu music
  # has faded, and stops with the block. Gameplay audio is otherwise
  # a recorded condition, so no other mode reads these keys, and
  # config/eeg_lab.yaml turns it off so the lab records in silence.
  # The mode never reads the stream: scoring is the same with it on
  # or off (tests/test_force_pilot_music.py pins the rows).
  music_enabled: true
  # Fraction of master_volume. 1.0: in-game music plays at full
  # level, the same as the rhythm songs; only the menus are turned
  # down (audio.menu_music_volume). Lower it here if the track covers
  # the exit buzz or the ring chime on a given speaker.
  music_volume: 1.0

buzz_hunt:
  # Buzz Hunt: the vibrotactile perception suite. The buzz IS the
  # stimulus, so these pulses bypass the cue.* before-press switches
  # by design (after-press feedback still honours them), and nothing
  # on screen ever names the target finger. The research case for
  # every number lives in rehab/game/modes/buzz_hunt.py; this block
  # says what the patient experiences. Needs the hardware: a keyboard
  # cannot buzz a finger, and the mode says so on screen. One block
  # runs the stage ladder in order: localisation, cross-hand
  # distractors (both-hands sessions only), sequence span, gap
  # detection.

  # Localisation: trials per hand (fingers stay balanced within the
  # hand), and the share of trials where nothing buzzes at all. Catch
  # trials price guessing: the false-alarm rate they produce is what
  # makes the accuracy numbers readable.
  loc_trials_per_hand: 32
  catch_rate: 0.1
  # THE PULSE IS FIXED. Every localisation and distractor buzz is
  # loc_pulse_ms long, and getting answers right never shortens it.
  # It used to: a duration staircase walked the pulse down with every
  # correct answer until the player could not feel it, which is what
  # a coin ERM does with a command shorter than its own start-up (lag
  # about 40 ms, rise to half amplitude about 87 ms, Precision
  # Microdrives 310-103 class; latency.* in this file). 150 is one
  # firmware hold, so it is delivered with no host-side quantisation,
  # and it sits inside the 50 to 200 ms band Kaaresoja and Linjama
  # (2005) rated best on a phone motor. It does not reach full
  # amplitude: on this rig half strength comes 100 to 140 ms after
  # the command, so the drive ends near half strength and the motor
  # coasts to a stop. The mode clamps
  # anything under 100. Same length as the span stage's pulses, and
  # under motor.cue_ms so it reads as a stimulus, not a cue.
  loc_pulse_ms: 150
  # What gets harder instead: the response window, in seconds,
  # longest first. Up a level after window_promote[0] correct of the
  # last window_promote[1] trials at the level, down a level after
  # window_demote[0] misses in the last window_demote[1] (a timeout
  # is a miss), one ladder per hand, starting at the longest window.
  # The level is stamped on every trial row and the top level reached
  # is the block's difficulty summary, next to accuracy at the fixed
  # pulse, d-prime from the catch trials and median RT.
  window_levels_s: [3.0, 2.0, 1.5, 1.2]
  window_promote: [6, 8]
  window_demote: [2, 4]
  # LEGACY: the duration staircase (2-down 1-up per hand on the pulse
  # length, 70.7 percent point). Off by default and only here so an
  # earlier block can be reproduced exactly; with it on the window
  # stays at response_window_s and the four keys below run the
  # staircase as they always did (ms of REQUESTED duration; the floor
  # is the host's 40 ms, not a perceptual number, see the mode
  # docstring: WHY THE PULSE IS FIXED).
  duration_staircase: false
  start_ms: 300
  step_ms: 40
  floor_ms: 40
  ceil_ms: 500
  # How many of the last reversals average into a staircase's
  # threshold estimate (the gap stage, and the legacy duration
  # staircase).
  threshold_reversals: 6
  # Distractor stage (both hands only): trials per hand, and how far
  # ahead of the target the other hand's decoy pulse starts. These
  # trials run at the fixed pulse and the window the ladder has
  # reached, without moving it.
  distractor_trials_per_hand: 8
  distractor_lead_ms: 150
  # Sequence span: total trials, the opening sequence length, the
  # pulse length and onset-to-onset spacing of the playback, and how
  # often the hidden repeating sequence returns (every Nth span
  # trial). The hidden sequence is derived from the participant name,
  # so it is the same every session; do not mention it to players.
  span_trials: 10
  span_start: 2
  span_pulse_ms: 150
  span_ioi_ms: 400
  hebb_every: 3
  # Gap detection: trials per hand; one long buzz (two shorts plus
  # the gap, so length never gives it away) or two shorts with a
  # silent gap between. The gap runs a 2-down 1-up staircase per
  # hand (a gap IS a duration, and a silence has no amplitude to
  # lose). The floor is the motor's spin-down plus a display frame: a
  # coin ERM keeps ringing for about 115 ms after current off, and
  # the DELIVERED gap is the request minus up to one frame (the first
  # short ends on the firmware's own timer while the second starts at
  # the next frame at or after its planned onset, measured on a
  # replayed wire: 320 -> 316.7, 160 -> 150.0, 120 -> 116.7). At the
  # old 120 floor that left under 2 ms of real silence, so the bottom
  # of the staircase was a level nobody could answer and a good
  # performer walked straight down to it. 150 leaves the spin-down a
  # full frame of headroom and is one firmware hold, the same number
  # as gap_short_ms; the mode clamps anything lower. A threshold that
  # lands on the floor is CENSORED, at or below the floor, never a
  # number. The shorts are felt pulses (150, one firmware hold), not
  # the 80 ms twitch they were. Set gap_trials_per_hand 0 to drop the
  # stage, as the study battery does.
  gap_trials_per_hand: 20
  gap_start_ms: 320
  gap_step_ms: 40
  gap_floor_ms: 150
  gap_short_ms: 150
  # Trial pacing: the unpredictable quiet wait before each stimulus
  # (uniform draw between these bounds, so the buzz cannot be timed),
  # the response window for the span and gap stages (localisation
  # takes its window from window_levels_s), and the extra replay time
  # per span item.
  wait_lo_s: 0.8
  wait_hi_s: 2.2
  response_window_s: 3.0
  replay_item_s: 1.5
  # Between-trial pacing and the stage cards that explain each task.
  # Neither number protects anything: the wait that has to stay
  # unpredictable is wait_lo_s to wait_hi_s above, which is the
  # foreperiod inside the trial. These two only decide how long the
  # ready card and the result card sit there. Trimmed from 2.0 and
  # 3.0, which across 62 trials was over five minutes of an eleven
  # minute block spent reading cards.
  announce_s: 1.5
  rest_s: 2.0
  stage_intro_s: 5.0
  # Hard cap on the whole block, minutes. Enforced between trials
  # only, so a trial in flight always finishes and is scored; the
  # block ends at the next card with everything already played kept
  # and end_reason time_cap in the summary. Measured on a headless
  # simulated block at these settings (2026-09, window ladder and
  # the longer gap stimuli): one hand runs about 8.4 minutes for an
  # ordinary responder and 10.0 in the worst case (nobody responds,
  # every window expires); both hands about 16.2 and 19.9. Sustained
  # tactile discrimination is attention-heavy, and past a quarter
  # hour the tail trials measure fatigue more than perception, so 15
  # leaves one-hand blocks untouched and trims only the bilateral
  # gap tail (an ordinary responder plays 123 of 130 trials). Raise
  # it to 17 for a protocol that must have every bilateral gap
  # trial.
  session_cap_min: 15
  # Set an integer to replay a block's exact trial plans (testing, or
  # a deliberately repeated protocol). Empty draws fresh each block
  # and records it in raw.csv. The hidden repeating sequence comes
  # from the participant name, not from this seed.
  seed: null

echo:
  # Echo: the Simon-says span game. The rig plays a sequence (tile
  # light plus a buzz on that finger), the patient replays it, and
  # the sequence grows by one item every time they get it right. The
  # longest echo is the headline. The research case for every number
  # lives in rehab/game/modes/echo.py; this block says what the
  # patient experiences. Plays fine on a keyboard: the stimulus is on
  # screen, the buzz reinforces it.

  # simon (the default) is the toy's own rule: ONE sequence per game,
  # drawn at game start and revealed one item longer each trial,
  # starting at a single item. ladder is the legacy Kessels 2000
  # Corsi climb (two different sequences per length, up while at
  # least one comes back right, over when both fail) with its hidden
  # Hebb repeats. The two are different tests and their spans never
  # pool.
  rule: simon
  # Games per block, and the spare life each game carries. A miss
  # (wrong press or timeout) spends the life and replays the same
  # sequence at the same length once; a second miss ends the game.
  # One life is a two-error stop rule applied once, which removes
  # most of the downward bias a single-shot rule puts on the score
  # (Woods 2011 in the mode file) without doubling the trials. Set
  # lives 0 for the strict arcade rule.
  games: 1
  lives: 1
  # Simon starts at one item and stops when the player does; 20 is a
  # ceiling nobody in the study is expected to reach (adult Simon
  # spans sit around 7 on four buttons). The ladder rule reads
  # start_len 2 and max_len 9 instead, so change these together with
  # rule.
  start_len: 1
  max_len: 20
  # Read only when rule is ladder: two trials per length, and runs
  # extra climbs per block. The Kessels standard is one run.
  trials_per_len: 2
  runs: 1
  # Presentation. The Corsi standard is one item a second (eCorsi:
  # 500 ms lit, 1000 ms onset to onset), and that rate played as
  # slow and stale on the rig, so the schedule sits between the
  # standard rate and the hardware floor: each item is lit and
  # buzzed for item_on_ms; the onset-to-onset interval is ioi_ms
  # for the shortest sequence and shrinks by ioi_step_ms for every
  # extra item of length, never below ioi_floor_ms (2 items at 800
  # ms, 3 at 750, 4 at 700, 5 at 650, 6 and up at 600; lengths 1 and
  # 2 share the opening rate, which is what ioi_anchor_len sets). The rate is
  # a function of LENGTH only: it never moves with success inside a
  # length, both trials at a length share it, and every trial row
  # records the interval it ran at, which is what keeps blocks
  # comparable (Berch 1998 in the mode file). ioi_step_ms 0 is the
  # fixed-rate protocol. The floor is the motors': a coin ERM of the
  # class on this rig reaches half amplitude about 87 ms after current
  # on (100 to 140 ms on this rig by the design notes) and spins down
  # for about 115 ms after current off (latency.*), so
  # the mode never lets the interval under item_on_ms plus 150 ms
  # whatever is written here. Changing these is a protocol deviation
  # the analysis names, so leave them unless it is deliberate.
  item_on_ms: 400
  ioi_ms: 800
  ioi_step_ms: 50
  ioi_floor_ms: 600
  # Lengths at or under this all play at ioi_ms, so a Simon game's
  # first two trials run at the rate the ladder always opened at and
  # one schedule serves both rules.
  ioi_anchor_len: 2
  # Read only when rule is ladder: every Nth trial secretly replays
  # the participant's hidden sequence (derived from the name, stable
  # across sessions). Do not mention it to players. The Simon rule
  # has no hidden trials; every trial repeats the same material by
  # design, so there is nothing to hide a repeat among.
  hebb_every: 3
  # Reproduction is self-paced and never scored on speed; this is
  # only how long a silent hand gets before the trial closes as a
  # timeout.
  idle_timeout_s: 10.0
  # Short breather between trials, skippable like every wait.
  rest_s: 2.0
  # A timeout that spends the game's life gets this long rest before
  # the replay: a hand that answered nothing needs more recovery than
  # a wrong press does. fatigue_timeout_run is read only when rule is
  # ladder (there, two straight timeouts force the rest and a second
  # forced rest ends the block); under simon two straight timeouts
  # already end the game through the life rule.
  fatigue_timeout_run: 2
  fatigue_rest_s: 20.0
  # Hard cap on the whole block, minutes, enforced at trial close. A
  # Simon game to span 7 with the life spent is about 9 trials and a
  # couple of minutes; the cap only catches a player who keeps going
  # at long lengths.
  session_cap_min: 10
  # Set an integer to replay a block's exact sequences (game N uses
  # seed + N). Empty means each game draws from the participant's
  # name and their game count, so the same person on their third
  # game always meets the same sequence and no two games repeat.
  # seed_follows_game_count counts N from the participant's earlier
  # games instead of from this block's first, so a fixed seed gives
  # everyone the same sequences without repeating any (the study).
  seed: null
  seed_follows_game_count: false

rhythm:
  difficulty: medium     # easy | medium | hard
  # Seconds after the visual countdown ends before the audio starts +
  # the first beat is due. Gives the falling-notes visualiser time to
  # ramp in so the patient sees notes sliding down before they need to
  # press one. The 3 s countdown ticking from "3" to "GO" still runs;
  # this is an ADDITIONAL silent ramp on top of it.
  pre_song_lead_s: 2.0
  # Difficulty is NOT config-driven: how many notes fire per difficulty
  # lives in code as _DIFFICULTY_STRIDE / _DIFFICULTY_KEEP_FRAC /
  # _DIFFICULTY_MIN_GAP_S / _DIFFICULTY_MAX_GAP_S in
  # rehab/audio/beatmap.py, because tuning them needs the onset-
  # strength data those functions already have in scope. Edit that
  # file, not this one, to change beat density per difficulty.
  perfect_ms: 50
  great_ms: 100
  good_ms: 175
  miss_ms: 300
  # Audio-output latency compensation. pygame.mixer's buffer + the OS
  # audio path add ~20-50 ms between when our song_time clock thinks a
  # beat occurs and when the patient actually HEARS it. Without this
  # the patient's "on the beat" press lands as ~40 ms Late even when
  # they're perfectly in time. Default 40 ms is the typical pygame
  # latency on macOS / Windows; bump it up if presses still feel late,
  # or down toward 0 if they feel early. Only applied while a song is
  # actually playing; a keyboard-only or audio-disabled session has
  # nothing to compensate for and gets 0.
  audio_offset_ms: 40
  # Same idea for the click-track metronome fallback (no song file).
  # The metronome uses the same 512-sample mixer buffer, ~12 ms at
  # 44.1 kHz, far less than a decoded song's latency.
  metronome_offset_ms: 12
  # WHEN THE BUZZ HAPPENS, relative to the beat. The tone, the
  # falling note and the EEG stimulus marker always sit on the scored
  # beat (note time plus the audio offset above); this switch only
  # moves the buzzer.
  #
  #   lead      the STIM command goes out buzz_lead_ms plus the motor's
  #             rise (latency.buzzer_ms) BEFORE the beat, so a player
  #             who REACTS to the buzz lands on the beat instead of a
  #             reaction time behind it. Adaptation below then tunes
  #             the lead to the player: a predictor's lead shrinks to
  #             0 (buzz on the beat), a reactor's settles at their own
  #             reaction time. The buzz is marked as its own EEG event
  #             (22) and the beat byte drops the buzzer bit.
  #   on_beat   the STIM command goes out on the beat minus the motor
  #             rise only, no lead and no adaptation. This is the
  #             pre-September behaviour once the rise is 0.
  #   feedback  no cue buzz at all; the pressed finger buzzes for
  #             motor.cue_ms the instant a press scores a hit
  #             (Perfect, Great or Good). The fallback if leading the
  #             beat does not suit a player.
  #
  # Measured on a fake wire at 60 Hz through the real engine with the
  # then-shipping numbers (lead 150, buzzer latency 45): the STIM command
  # led the scored beat by 196 ms on average (range 187 to 206, so
  # jitter within one frame either side) while the tone stayed on the
  # beat. A simulated reactor pressing 200 ms after the felt buzz
  # scored +237 to +254 ms (every note Late) on the old on-the-beat
  # wire, +39 to +60 ms (Perfect or Great) under a fixed 150 ms lead,
  # and settled within +/-13 ms once the lead had adapted to about
  # 200 ms after three updates (12 notes); a 250 ms reactor took
  # five. A predictor pressing 30 ms early kept scoring -30 whatever
  # the buzz did and the lead walked down 15 ms per update toward 0.
  # In feedback mode the STIM followed the press by 8 to 23 ms: the
  # press is scored on the next frame and the command leaves then.
  tactile_mode: lead
  # Reaction allowance for lead mode, in ms. Bao et al. 2019 put
  # simple reaction time to a buzz at about 200 to 230 ms in young
  # adults and 250 to 330 ms in older adults, a coin motor added
  # about 45 ms over a lab tactor in the same study, and this rig's
  # motor class takes 87 ms to reach half strength (Precision
  # Microdrives 310-103 datasheet). 350 lands a typical reactor near
  # the beat from the first note. It was 150 (the fastest healthy
  # touch reaction time, Robinson 1934 via Kosinski 2013), which
  # players felt as every buzz arriving too late to act on.
  buzz_lead_ms: 350
  # Adaptation: every buzz_lead_every scored presses, take the median
  # of the last buzz_lead_window press offsets (Perfect, Great, Good,
  # Late and Early; a Miss has no offset) and move the lead by
  # buzz_lead_gain times that median. Late and Early count because
  # they are the presses that show the lead is wrong: with them left
  # out, a player landing Late never moved the lead at all. The
  # median over eight keeps one wild press from moving the cue. The
  # move is at most buzz_lead_step_ms per update, clamped to 0 and
  # buzz_lead_max_ms (700, for the slowest older reactors). A late median raises the lead, an early one
  # lowers it. Gain 0.5 on a 4-hit period converges in about three
  # updates without overshoot; 25 ms is under the Great window so one
  # update cannot flip a hit into a miss. A median inside
  # buzz_lead_deadband_ms is on the beat and moves nothing: dispatch
  # jitters by a third of a frame on its own, and because the window
  # is twice the update period the estimate lags the lead by one
  # update, so without the dead-band a reactor's lead overshot by 2
  # to 3 ms and then hunted back in sub-millisecond steps all block.
  # The lead in force is written on every trial row (waveform_params)
  # and carried across blocks within a login session, so block two
  # starts where block one ended.
  buzz_lead_adapt: true
  buzz_lead_window: 8
  buzz_lead_every: 4
  buzz_lead_gain: 0.5
  buzz_lead_max_ms: 700
  buzz_lead_step_ms: 25
  buzz_lead_deadband_ms: 5
  # Bench-measured command-to-felt time for THIS rig's motors, in ms,
  # subtracted from the buzz target in every tactile mode so the felt
  # vibration, not just the command, sits where the mode wants it.
  # 0 (shipping) means "use latency.buzzer_ms", the datasheet-class
  # estimate documented in the latency block; set a number here only
  # from your own measurement (scripts/latency_check.py).
  buzz_rise_comp_ms: 0

latency:
  # HOW LONG EACH STIMULUS TAKES TO REACH THE PATIENT after the
  # software commands it. The software cannot see any of these; they
  # are constants the rig owner measures once. Used in three places:
  # rhythm sends the buzz command buzzer_ms early so the felt
  # vibration lands where the mode wants it (rhythm.tactile_mode);
  # rhythm draws the falling note visual_ms early so the note reaches
  # the strike line on the retina on the audible beat; and every EEG
  # block copies the four values below and the derived
  # marker-to-stimulus offsets into metadata.json (eeg.latency and
  # eeg.marker_offsets_ms) so epochs can be shifted from the byte to
  # the stimulus.
  #
  # measured: false means every number here is a datasheet or
  # first-principles estimate for this class of hardware, not a
  # measurement of this rig. Settings, Setup, Audio delay (or
  # scripts/audio_latency.py --write) measures this computer's sound
  # paths and the motors with the built-in
  # microphone and saves config/latency_profile.yaml, which is laid
  # over these values at every start (per machine, never committed);
  # the study MacBook was measured on 24 September 2026. The display
  # lag still needs scripts/latency_check.py with a phone at 240 fps.
  measured: false
  measured_on: null
  # Host STIM command to first FELT motion of the pad, in ms.
  #   USB write plus 7 bytes at 115200 baud       about 1 ms
  #   one firmware loop (200 Hz sample block)      0 to 5 ms, mean 2.5
  #   10 mm coin ERM lag to first motion           about 40 ms
  # (Precision Microdrives 310-103 class values: lag 40 ms, rise to
  # half amplitude 87 ms, stop 115 ms after current off). So about 45
  # ms to the first felt motion and about 95 ms to half amplitude;
  # the first number is the one a reaction is timed from. PMD's 8 mm
  # parts span lag 20 to 29 ms and rise 54 to 92 ms at 3 V (308-107,
  # 308-100 datasheets); lag is to 0.08 G and rise to 50 percent
  # (PMD AB-029). Nobody publishes when a coin ERM is first FELT, so
  # only a bench measurement settles this one.
  buzzer_ms: 45
  # Flip return to a mid-screen tile changing on a 60 Hz monitor with
  # vsync, in ms: half a scan (8 ms of the 16.7 ms frame) plus pixel
  # response (4 to 10 ms TN, 8 to 16 ms IPS), no signal-processing
  # lag assumed. A television or a monitor with processing on adds
  # tens of ms; only a photodiode gives the real number. For scale:
  # Bridges et al. 2020 (PeerJ 8:e9414) measured 4 to 7 ms at the
  # TOP of a plain 60 Hz office LCD on Windows for most packages,
  # 6 ms for pygame-based Expyriment on Windows and 29 ms on macOS.
  # Mid-screen adds about half a frame, so 20 is likely high on a
  # plain lab monitor. In the lab: a photodiode on the tile into a
  # BioSemi AUX input records it next to the markers.
  visual_ms: 20
  # Cue tone dispatch to sound, in ms: the mixer's 512-sample buffer
  # at 44.1 kHz, the same path rhythm.metronome_offset_ms compensates.
  # A decoded song carries more (rhythm.audio_offset_ms); this is the
  # short-sound path the stim tone takes. Measure with an audio
  # loopback if the tone ERP is analysed.
  tone_ms: 12

audio:
  enabled: true
  # master_volume scales the WHOLE game (music, cues, feedback). The two
  # levels below sit on top of it so the clinician can balance the press
  # cue against the confirmation chime without touching the overall level.
  # Final volume of a sound is master x category x trial_gain x a fixed
  # per-sound factor. All three are set from the Settings screen and
  # persist to user_settings.yaml.
  master_volume: 0.8
  # Pre-press cue level: the go sound before a press. In classic and
  # adaptive that is the cued finger's lane tone; only Rhythm's
  # metronome plays the 2 kHz click.
  cue_volume: 1.0
  # Post-press feedback level: the hit chime + miss thunk after a press.
  feedback_volume: 1.0
  music_dir: assets/music
  # Menu music: a shuffled playlist that plays on the menu screens
  # only (login, game select, the hand picker and results). It fades
  # out when any block starts and never plays during gameplay, because
  # gameplay audio is a recorded condition and a background track
  # under a block would be an uncontrolled stimulus. Rhythm mode's own
  # songs are separate and unaffected. Both keys are set from the
  # Settings screen and persist to user_settings.yaml. Each person can
  # also mute the menus for themselves with the corner button on any
  # menu screen (M); that choice is remembered per participant in
  # session.prefs_file, not here.
  menu_music_enabled: true
  # Level as a fraction of master_volume, like the other category
  # levels. 0.12: every menu is very quiet (about 18 dB under the game)
  # and only the games are loud; the Rhythm song picker's preview plays
  # at this level too. Never above 0.30, whatever is saved. null falls
  # back to 0.12. The Settings menu music slider writes a number here.
  menu_music_volume: 0.12
  # Which files from music_dir the menu playlist draws on. Named
  # explicitly rather than "everything in the folder" so the rhythm
  # library can grow without the menus picking up a slow ambient track
  # that was added for gameplay pacing. Missing files are skipped with
  # a log line, so a renamed track cannot stop the app.
  menu_music_tracks:
    - Wallpaper.mp3
    - Life_of_Riley.mp3
    - Fluffing_a_Duck.mp3
    - Happy_Alley.mp3
    - Beachfront_Celebration.mp3
    - Vivacity.mp3
  # Per-lane stim cue tone (C, E, G, C, repeating for bilateral) that
  # fires the moment a stim is dispatched. SUPERSEDED by
  # cue.sound_before, which is the switch the game reads now and the
  # one the Settings screen writes. Kept here because a
  # user_settings.yaml that turned this off is translated onto
  # cue.sound_before at load, so an existing silent setup stays
  # silent. Nothing reads this key at run time.
  stim_tone_enabled: true
  # Programmatic loudness variation. On a small fraction of trials,
  # spread evenly across the whole session (not random clusters), the
  # cue + feedback play slightly louder. This is automatic, not a manual
  # per-patient knob: it keeps the auditory cue salient so the patient
  # doesn't habituate to a constant level over a long training block.
  # fraction 0.10 = roughly 1 in 10 trials; boost 1.35 = 35% louder on
  # those trials. Set fraction to 0 to disable.
  loud_trial:
    fraction: 0.10
    boost: 1.35

ui:
  resolution: [1280, 800]
  # Boot fullscreen (kiosk-style clinical use). F10 toggles to a
  # windowed view at runtime. The render size stays 1280x800 either
  # way; the display opens with SCALED so it upscales to fit the monitor.
  fullscreen: true
  theme: clinical
  font_scale: 1.0
  # How the app words what just happened.
  #   encouraging  the shipping game. Wording comes from
  #                finger_rehab/ui/feedback_bank.py: never a judgement
  #                word as a label, always the next action or the good
  #                part, a different variant each time.
  #   neutral      the EEG lab. No words after a trial at all: one ring
  #                glyph per outcome, identical in size, position,
  #                colour and lifetime, so nothing about the feedback
  #                event differs between a hit and a miss except the
  #                fill. Emotional words make an ERP of their own in
  #                the 200 to 300 ms window (the early posterior
  #                negativity), which is the window the
  #                feedback-related negativity is measured in, so words
  #                and the FRN cannot be separated in one record.
  #                Streak banners and the reaction NEW BEST chip are
  #                off in this style too.
  feedback_style: encouraging
  # Milliseconds between the press and the feedback glyph. 0 in the
  # shipping game (today's behaviour exactly). neutral style requires
  # 500 to 5000: feedback inside 500 ms lands on top of the
  # response-locked activity, past 5 s attention has moved on. Out of
  # bounds is refused at startup, not mid-block.
  feedback_delay_ms: 0

logging:
  level: INFO
  file: sessions/rehab.log
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
