basil2fxs/Hand-Rehab-Thesis/app/finger_rehab/audio/beatmap.py

"""Beatmap = a list of (time, lane) notes for rhythm mode.

If librosa is available we extract beats from a real audio file. If not we fall
back to a procedural BPM-driven beatmap so the game still plays without the
audio dependency.
"""
from __future__ import annotations

import json
import logging
import threading
from dataclasses import dataclass, field, asdict
from pathlib import Path
from typing import Iterable

from ..config import PROJECT_ROOT


log = logging.getLogger(__name__)

# The study's frozen charts (scripts/build_study_chart.py): one file per
# track and difficulty, every note moved onto the music's attack.
CHART_DIR = PROJECT_ROOT / "assets" / "charts"


# Every call that opens an audio file through librosa has to hold this.
#
# librosa reads through soundfile, which is a cffi wrapper over
# libsndfile, and libsndfile's MPEG decoder sets up shared state on its
# first use per file open. Two threads inside sf_open on an mp3 at the
# same time crash the process with SIGBUS (EXC_ARM_DA_ALIGN in
# mpeg_init) rather than raising anything Python can catch. The rhythm
# setup screen probes track durations on a background thread while the
# main thread can be extracting a beatmap from the track the user just
# picked, so the two really do overlap. One lock over both call sites
# is the whole fix: decoding is not on any hot path.
DECODE_LOCK = threading.Lock()


@dataclass
class Note:
    t: float            # song time in seconds when the user should press
    lane: int           # 0..3
    kind: str = "tap"

    def to_dict(self) -> dict:
        return asdict(self)


@dataclass
class Beatmap:
    title: str = "Untitled"
    bpm: float = 80.0
    song: str | None = None             # path to audio file, None for click track
    difficulty: str = "medium"          # easy | medium | hard
    notes: list[Note] = field(default_factory=list)
    # Where a frozen chart came from (study_chart); None for a chart
    # built from the audio at run time. Not saved with the notes.
    chart: dict | None = None

    def __post_init__(self) -> None:
        if self.notes:
            self.notes = sorted(self.notes, key=lambda n: n.t)

    @property
    def duration_s(self) -> float:
        return self.notes[-1].t + 1.0 if self.notes else 0.0

    @classmethod
    def load(cls, path: str | Path) -> "Beatmap":
        p = Path(path)
        with p.open("r", encoding="utf-8") as f:
            raw = json.load(f)
        known = {"t", "lane", "kind"}
        notes: list[Note] = []
        for n in raw.get("notes", []):
            if not isinstance(n, dict) or "t" not in n or "lane" not in n:
                continue
            try:
                notes.append(Note(**{k: v for k, v in n.items() if k in known}))
            except (TypeError, ValueError):
                continue
        return cls(
            title=str(raw.get("title", p.stem)),
            bpm=float(raw.get("bpm", 80.0)),
            song=raw.get("song"),
            difficulty=str(raw.get("difficulty", "medium")),
            notes=sorted(notes, key=lambda n: n.t),
        )

    def save(self, path: str | Path) -> None:
        p = Path(path)
        p.parent.mkdir(parents=True, exist_ok=True)
        with p.open("w", encoding="utf-8") as f:
            json.dump({
                "title": self.title,
                "bpm": self.bpm,
                "song": self.song,
                "difficulty": self.difficulty,
                "notes": [n.to_dict() for n in self.notes],
            }, f, indent=2)


def chart_sha(notes) -> str:
    """A short hash of a chart's (time, lane) list to the millisecond,
    so two blocks can be shown to have played the same chart. Takes
    Note objects or the dicts a chart file holds."""
    import hashlib
    rows = []
    for n in notes:
        t = n["t"] if isinstance(n, dict) else n.t
        lane = n["lane"] if isinstance(n, dict) else n.lane
        rows.append(f"{float(t):.3f}:{int(lane)}")
    return hashlib.sha256(";".join(rows).encode("ascii")).hexdigest()[:16]


def study_chart(track: str | Path, difficulty: str,
                num_lanes: int = 4) -> "Beatmap | None":
    """The frozen chart for this track and difficulty, its song set to
    `track`, or None when there is none to use: no file, a chart for
    another number of lanes, or an mp3 that is not the one the chart
    was built on (its notes would sit on another song's attacks)."""
    import hashlib
    p = Path(track)
    f = CHART_DIR / f"{p.stem}_{difficulty}.json"
    if num_lanes != 4 or not f.is_file():
        return None
    try:
        raw = json.loads(f.read_text(encoding="utf-8"))
        want = raw.get("track_sha256")
        got = hashlib.sha256(p.read_bytes()).hexdigest() if want else None
    except (OSError, ValueError) as e:
        log.warning("frozen chart %s unreadable (%s); building from the "
                    "audio instead", f.name, e)
        return None
    if want and got != want:
        log.warning("frozen chart %s was built on another %s; building "
                    "from the audio instead", f.name, p.name)
        return None
    bm = Beatmap.load(f)
    bm.song = str(p)
    bm.chart = {"source": "frozen", "file": f.name,
                "sha": chart_sha(bm.notes),
                "aligned_to": raw.get("aligned_to"),
                "median_lag_ms": raw.get("median_lag_ms")}
    return bm


_DIFFICULTY_STRIDE = {"easy": 4, "medium": 2, "hard": 1}

# Fraction of detected beats kept per difficulty after onset-strength
# ranking. Easy keeps only the strongest ~22% (sparse, big-hit feel);
# medium sits much closer to easy now (was 0.55 -> rehab patients
# found the jump too steep), so it adds maybe one extra beat for
# every two easy beats rather than doubling the density. Hard keeps
# most beats so the tempo carries the track. Tuned against the
# bundled Kevin MacLeod tracks; everything below the threshold is
# dropped.
_DIFFICULTY_KEEP_FRAC = {
    "easy":   0.22,
    "medium": 0.35,
    "hard":   0.85,
}

# Minimum gap between consecutive notes per difficulty (seconds).
# Stops onset clustering (a kick + cymbal hit ~30 ms apart) from
# producing two notes the patient can't physically separate. Higher
# gaps on easy = friendlier pace; lower gaps on hard let dense
# percussion through. Medium gap pulled up to 0.42 s to match the
# softer keep_frac - if we let the gap stay tight on a sparser
# beatmap, the patient gets bursts of three notes inside one beat
# followed by long silences.
_DIFFICULTY_MIN_GAP_S = {
    "easy":   0.55,
    "medium": 0.42,
    "hard":   0.18,
}

# Maximum gap allowed between consecutive notes per difficulty.
# Strong-beat filtering can leave long silences in songs that have
# quiet breakdowns or intros; the patient reads those as the game
# stalling. We fill any gap longer than this with the strongest
# unused beat from that span so there's always something to press
# to, even if it's not on the loudest hit of the song.
_DIFFICULTY_MAX_GAP_S = {
    "easy":   3.8,
    # Medium max gap pulled up from 2.6 to 3.2 because the new
    # softer keep_frac leaves longer natural silences; clamping
    # tighter would force backfill beats into spots that aren't
    # actually loud, defeating the strong-beat principle.
    "medium": 3.2,
    "hard":   1.8,
}


def _default_pattern(num_lanes: int) -> list[int]:
    """One cycle of lanes. Every lane appears exactly once per cycle, so
    over a song each finger gets the same number of notes.

    The bilateral default used to be [0,4,1,5,2,6,3,7,1,5,2,6], which repeats
    the middle and ring fingers within the cycle. That gave those two fingers
    twice the notes of the index and pinky, about 16.7% each against 8.3%, on
    every bundled track and difficulty. A per-finger comparison of rhythm
    timing was therefore built from twice as many samples for the inner
    fingers as the outer ones.

    Kept deterministic. Rhythm mode shows the notes coming, so an
    unpredictable order buys nothing here, and a fixed map means retrying a
    block gives the patient the same chart.
    """
    if num_lanes >= 8:
        # Alternate hands so the patient keeps swapping between them, and
        # walk the fingers in order so each hand sees each finger once.
        n = num_lanes // 2
        out: list[int] = []
        for finger in range(n):
            out.append(finger)          # right hand
            out.append(n + finger)      # left hand
        return out
    return [0, 1, 2, 3, 1, 2, 0, 3] if num_lanes == 4 else list(range(num_lanes))


def _assign_lanes(beat_times: Iterable[float],
                  pattern: list[int] | None = None,
                  num_lanes: int = 4) -> list[Note]:
    """Spread beats across lanes using a repeating pattern. `num_lanes` tells
    us whether this is a unilateral (4-lane) or bilateral (8-lane) session
    when no explicit pattern is supplied."""
    pat = pattern or _default_pattern(num_lanes)
    notes: list[Note] = []
    for i, t in enumerate(beat_times):
        lane = pat[i % len(pat)]
        if 0 <= lane < num_lanes:
            notes.append(Note(t=float(t), lane=lane))
    return notes


def _coerce_scalar(x) -> float:
    """Coerce a librosa-returned tempo (which can be a 0-d or 1-d ndarray,
    or a plain float) into a single float."""
    if hasattr(x, "item"):
        try:
            return float(x.item())
        except (TypeError, ValueError):
            pass
    try:
        return float(x)
    except (TypeError, ValueError):
        return float(x[0])


def _fill_long_gaps(chosen_times: list[float],
                     all_times: list[float],
                     all_strengths: list[float],
                     max_gap_s: float,
                     min_gap_s: float) -> list[float]:
    """If two consecutive `chosen_times` are separated by more than
    `max_gap_s`, insert the strongest beat from `all_times` that
    falls inside that window AND sits at least `min_gap_s` from
    either neighbour. Iterates until every gap is acceptable or
    there's nothing left to insert in the gap.

    This is what stops a quiet 8 second breakdown turning into a
    "did the game freeze?" moment for the patient."""
    if not chosen_times or max_gap_s <= 0:
        return list(chosen_times)
    chosen = sorted(chosen_times)
    # Build a strength lookup so we can rank unused beats quickly.
    strength_of = {t: s for t, s in zip(all_times, all_strengths)}
    chosen_set = set(chosen)
    # Loop until no gap exceeds max_gap_s OR we ran out of candidates.
    while True:
        # Find the LONGEST gap first; filling the worst case first
        # converges fastest and keeps the result balanced.
        worst_idx = -1
        worst_size = 0.0
        for i in range(len(chosen) - 1):
            gap = chosen[i + 1] - chosen[i]
            if gap > worst_size:
                worst_size = gap
                worst_idx = i
        if worst_idx < 0 or worst_size <= max_gap_s:
            return chosen
        lo = chosen[worst_idx]
        hi = chosen[worst_idx + 1]
        # Candidate beats inside the gap that don't crowd either edge.
        cands = [
            t for t in all_times
            if (lo + min_gap_s) <= t <= (hi - min_gap_s)
            and t not in chosen_set
        ]
        if not cands:
            # Nothing fits. Accept the long gap rather than spinning
            # forever - the song genuinely has no beat to put here.
            return chosen
        # Pick the strongest of the candidates.
        best = max(cands, key=lambda t: strength_of.get(t, 0.0))
        # Splice it in. List insert keeps the list sorted because we
        # picked from inside [lo, hi].
        chosen.insert(worst_idx + 1, best)
        chosen_set.add(best)


def _select_strong_beats(beat_times: list[float],
                          beat_strengths: list[float],
                          keep_frac: float,
                          min_gap_s: float) -> list[float]:
    """Pick the subset of beats whose onset strength is in the top
    `keep_frac` of the song, then enforce a minimum gap so two beats
    that landed within `min_gap_s` of each other don't both survive.

    The strength threshold is derived from the percentile, so a song
    with uniformly punchy beats keeps most of them while a sparse
    track with one big drop keeps that drop and prunes the filler.
    """
    if not beat_times:
        return []
    if len(beat_times) != len(beat_strengths):
        # Length mismatch should never happen, but if it does just
        # return the raw beats so the player still has something to
        # press to.
        return list(beat_times)
    # Compute the strength threshold: anything below it is dropped.
    # numpy is already a librosa dep so we can use it freely here.
    import numpy as np
    strengths = np.array(beat_strengths, dtype=float)
    if strengths.size == 0 or float(strengths.max()) <= 0.0:
        # Onset envelope was flat (silent track, or onset detection
        # failed). Pretend every beat is equally strong and let the
        # stride logic do the work.
        return list(beat_times)
    # Percentile such that exactly keep_frac of beats survive. e.g.
    # keep_frac=0.55 -> threshold = 45th percentile, keep top 55%.
    pct = max(0.0, min(100.0, 100.0 * (1.0 - keep_frac)))
    threshold = float(np.percentile(strengths, pct))
    # Pair (time, strength) and keep those above threshold, sorted
    # in chronological order.
    candidates = [
        (t, s) for t, s in zip(beat_times, beat_strengths)
        if s >= threshold
    ]
    candidates.sort(key=lambda ts: ts[0])
    # Greedy gap enforcement: walk left-to-right, drop any beat that
    # lands within min_gap_s of the most recently accepted beat. If
    # two near-each-other beats arrive, the stronger one wins (we
    # back-substitute the weaker for the stronger).
    chosen: list[tuple[float, float]] = []
    for t, s in candidates:
        if not chosen:
            chosen.append((t, s))
            continue
        prev_t, prev_s = chosen[-1]
        if t - prev_t >= min_gap_s:
            chosen.append((t, s))
        elif s > prev_s:
            # Replace the previous weaker beat with this stronger one
            # so the kept set stays anchored to the loudest hits.
            chosen[-1] = (t, s)
    return [t for t, _ in chosen]


# librosa.load's own defaults, which every beat map was made with.
DECODE_SR = 22050


def decode_mono(path: str | Path, sr: int = DECODE_SR):
    """The track as librosa.load(path, mono=True) returns it: float32,
    channels averaged, resampled to `sr` with librosa's default
    resampler. Read through soundfile first, because librosa.load asks
    audioread for its backends before it tries anything, audioread
    imports aifc, and PsychoPy's Python (3.10, a trimmed standard
    library) has no aifc: under PsychoPy every track failed and rhythm
    silently played a procedural map instead of the song's beats.
    librosa.load stays as the fallback for a file soundfile cannot
    read."""
    import librosa
    try:
        import soundfile as sf
        data, native = sf.read(str(path), dtype="float32", always_2d=True)
    except Exception:
        return librosa.load(str(path), mono=True, sr=sr)
    y = librosa.to_mono(data.T)
    if native != sr:
        y = librosa.resample(y, orig_sr=native, target_sr=sr)
    return y, sr


def extract_beatmap(audio_path: str | Path,
                    difficulty: str = "medium",
                    lane_pattern: list[int] | None = None,
                    num_lanes: int = 4) -> Beatmap:
    """Detect the song's beats and pick the strongest ones (kicks,
    snares, downbeats) for the patient to press to. Falls back to a
    procedural BPM-only map if librosa or the audio file is missing.

    The two-pass approach: first librosa.beat.beat_track gives the
    tempo grid (uniform pulses at the song's BPM); then we look up
    each beat's onset strength in the percussive envelope and keep
    only the top `keep_frac` by strength. Result: notes line up with
    the kicks and snares the listener already feels as "the beat" -
    not the in-between sixteenths nobody taps along to.

    `lane_pattern` lets the caller route beats to specific fingers.
    Default rotates through index, middle, ring, little (with both
    hands woven together when num_lanes is 8).
    """
    p = Path(audio_path)
    try:
        import librosa
        with DECODE_LOCK:
            y, sr = decode_mono(p)
        # Onset envelope (energy of percussive hits over time).
        # Computed once and shared between beat-track + strength
        # ranking so beat_track follows the same percussive cues we
        # use to filter.
        onset_env = librosa.onset.onset_strength(y=y, sr=sr)
        tempo, beats = librosa.beat.beat_track(
            onset_envelope=onset_env, sr=sr,
        )
        bpm = _coerce_scalar(tempo)
        times = librosa.frames_to_time(beats, sr=sr).tolist()
        # Per-beat onset strength. We look up the envelope value at
        # each beat frame; that single number captures "how much hit
        # is happening here" relative to neighbouring beats. Window
        # +/- 1 frame so a beat that's a few ms early of the kick
        # still picks up the kick's strength.
        if onset_env.size > 0 and beats.size > 0:
            beat_strengths: list[float] = []
            for f in beats:
                lo = max(0, int(f) - 1)
                hi = min(int(onset_env.size), int(f) + 2)
                if hi > lo:
                    beat_strengths.append(float(onset_env[lo:hi].max()))
                else:
                    beat_strengths.append(0.0)
        else:
            beat_strengths = [1.0] * len(times)

        keep_frac = _DIFFICULTY_KEEP_FRAC.get(difficulty, 0.55)
        min_gap_s = _DIFFICULTY_MIN_GAP_S.get(difficulty, 0.30)
        max_gap_s = _DIFFICULTY_MAX_GAP_S.get(difficulty, 2.6)
        subset = _select_strong_beats(
            times, beat_strengths,
            keep_frac=keep_frac, min_gap_s=min_gap_s,
        )
        # Floor: if filtering left fewer than ~1 note per 4 seconds
        # of song the patient runs out of things to press, so we
        # fall back to the every-Nth-beat stride for that case.
        # Compares against the half-keep_frac equivalent so it kicks
        # in only when ranking REALLY dropped too much (not just a
        # naturally sparse song).
        if times and len(subset) < max(8, len(times) * keep_frac * 0.5):
            log.info("Strong-beat filter dropped too much (%d/%d); "
                      "using stride fallback", len(subset), len(times))
            stride = _DIFFICULTY_STRIDE.get(difficulty, 2)
            subset = times[::stride]
        # Backfill any remaining long silences with the strongest
        # unused beat in each gap so the patient never sits
        # wondering whether the game has stalled. Skipped on the
        # stride-fallback path because uniform-spaced beats can't
        # have a gap > 1 beat period.
        subset = _fill_long_gaps(
            subset, times, beat_strengths,
            max_gap_s=max_gap_s, min_gap_s=min_gap_s,
        )
        notes = _assign_lanes(subset, lane_pattern, num_lanes=num_lanes)
        return Beatmap(
            title=p.stem,
            bpm=bpm,
            song=str(p),
            difficulty=difficulty,
            notes=notes,
        )
    except Exception as e:
        # librosa missing or audio unreadable. Make a procedural map.
        log.warning("librosa beat-track failed (%s); using procedural map", e)
        return procedural_beatmap(bpm=80.0, beats=64, difficulty=difficulty,
                                  title=p.stem, song=str(p),
                                  lane_pattern=lane_pattern,
                                  num_lanes=num_lanes)


def procedural_beatmap(bpm: float, beats: int, difficulty: str = "medium",
                       title: str = "Procedural", song: str | None = None,
                       lane_pattern: list[int] | None = None,
                       num_lanes: int = 4) -> Beatmap:
    if bpm <= 0:
        raise ValueError(f"bpm must be > 0, got {bpm}")
    if beats <= 0:
        raise ValueError(f"beats must be > 0, got {beats}")
    stride = _DIFFICULTY_STRIDE.get(difficulty, 2)
    period = 60.0 / bpm
    times = [(i + 1) * period for i in range(beats)][::stride]
    notes = _assign_lanes(times, lane_pattern, num_lanes=num_lanes)
    return Beatmap(
        title=title, bpm=bpm, song=song, difficulty=difficulty, notes=notes,
    )
