basil2fxs/Hand-Rehab-Thesis/app/tests/test_chords_mode.py

"""Tests for Chords mode, the multi-finger co-activation block. The
guarantees pinned here are the ones the measurement depends on: the
deal holds the size mix exactly per bag of twenty (four singles, one
per finger, ten pairs, five triples, one quad), never opens a block on
a single, keeps singles out of every chord number, balances per-finger
participation and never deals the same chord twice running, the
difficulty formula still ranks the analysis table
the way the enslaving-adjacency literature predicts, every chord
lights all its fingers at once and lands in the CSV as "1+3+4" with
the full target set in correct_keys, the synchrony window is what
separates a chord from a sequence of taps, cross-talk is scored from
the force-window peaks against the quick-cal light-press reference
and rewarded separately from completion, the buzzer cue for a
same-board chord buzzes every finger together (or, with
motor.chord_buzz: arpeggio, spaces them out), and the safety rails (quiet-hand gate, enforced rests,
fatigue triggers, session cap) end a block rather than trap a tired
hand in it.
"""
from __future__ import annotations

import csv
import json
import os
import sys
import tempfile
import unittest
from pathlib import Path
from unittest.mock import MagicMock


sys.path.insert(0, str(Path(__file__).resolve().parents[1]))
os.environ.setdefault("SDL_VIDEODRIVER", "dummy")
os.environ.setdefault("SDL_AUDIODRIVER", "dummy")


def _press(lane: int, t: float = 0.0):
    from finger_rehab.hardware.fsr_detector import PressEvent
    return PressEvent(lane=lane, t_perf=t, value=0, baseline=0.0,
                       hand="right")


def _build_mode(**overrides):
    """A ChordsMode wired to a MagicMock engine, driven with explicit
    `now` values instead of sleeping, following the pattern-mode test
    harness. The engine reports keyboard input (no live FSR data) so
    the sensor-dependent checks relax unless a test wires them up."""
    from finger_rehab.game.modes.chords import ChordsMode
    from finger_rehab.game.scoring import ScoreConfig
    engine = MagicMock()
    engine._screens = {}
    engine.hand_mode = "right"
    engine.source.provides_samples = False
    engine.detectors = {}
    engine.calibration_profiles = {}
    engine._force_window_peak = {}
    engine._force_window_saw_samples = False
    engine.cfg.get = MagicMock(side_effect=lambda k, d=None: {
        "fsr.on_delta": [20, 13, 15, 46],
    }.get(k, d))
    kwargs = dict(
        engine=engine,
        hand="right",
        lanes=[0, 1, 2, 3],
        timeout_s=3.0,
        sync_windows_ms=[250, 200, 150, 100],
        hold_ms=200,
        baseline_quiet_ms=500,
        settle_prompt_s=5.0,
        iti_min_s=1.5,
        iti_max_s=2.5,
        trials_per_subblock=20,
        subblocks=5,
        rest_between_s=30.0,
        fatigue_rest_s=120.0,
        session_cap_min=30.0,
        score_cfg=ScoreConfig(),
        seed=7,
        demo_trials=None,
    )
    kwargs.update(overrides)
    mode = ChordsMode(**kwargs)
    mode._t0 = 0.0
    return engine, mode


def _force_pair(mode, hand: str = "right") -> None:
    """Make the hand's next deal a two-finger chord: tests that press
    exactly two lanes need a pair, and the size bag's opening size
    depends on the seed."""
    mode._deck[hand]._classes._bag.insert(0, 2)


def _complete_chord(mode, t0: float, gap_s: float = 0.05) -> float:
    """Press every target of the active chord, onsets `gap_s` apart.
    Returns the time of the last press."""
    t = t0
    for lane in mode.active.targets:
        mode._handle_press(_press(lane, t), t)
        t += gap_s
    return t - gap_s
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
