basil2fxs/Hand-Rehab-Thesis/tools/calibrate_buzzers.py

"""Check the buzzers are on the right fingers and pick a cue length.

The buzzer's job in this software is to tell the patient WHICH finger
to press. That only works if motor 1 is actually under the index
finger, motor 2 under the middle, and so on. A miswired or repositioned
motor would cue the wrong finger every trial and the resulting data
would be quietly wrong rather than obviously broken, so this checks the
mapping by asking which finger you actually felt.

The game now has this built in: Calibrate on the title screen runs the
same check as step 5 of its flow, and saves the result the same way.
Use this script when you want to test the motors without starting the
game, or to tune the cue length, which the in-app flow does not cover.

It then plays several cue lengths so you can pick one that is easy to
feel without being unpleasant.

    python3 tools/calibrate_buzzers.py

About strength: the firmware drives the motors
at a fixed STIM_PWM = 200 and accepts only "STIM:n" and "STOP". There
is no command to change vibration amplitude, and the board is not being
reflashed. Duration is therefore the only property the host can vary,
which is what this tool sets. Each STIM re-arms the motor for 150 ms,
so longer cues are produced by repeating the pulse.

Default is 250 ms, chosen because about 30 ms is the floor for a
vibration to register as a vibration at all, published cueing studies
use bursts across roughly 25-400 ms, and stroke patients need markedly
more stimulation on the affected hand for the same perception.
"""
from __future__ import annotations

import sys
import time
from pathlib import Path


sys.path.insert(0, str(Path(__file__).resolve().parents[1]))
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
