basil2fxs/Hand-Rehab-Thesis/(commit log)

2026-05-27 Add InteractiveGame data folder
    [12345_50_20251014.csv, 123_123_session_all_20251015_130755.csv, 1_1_20260512.csv, 1_1_session_all_20260512_125416.csv, 20551122_22_20251013.csv, 20551122_22_20251016.csv, 20551410_22_20251014.csv, 20555470_23_20251013.csv]
2026-07-30 Finger colours, calibrated press thresholds, buzzer cue, analysis notebook
    Colours: index orange, middle light blue, ring black, pinky yellow, with
    label contrast following the tile fill.
    Press thresholds measured against a resting hand. The old uniform value
    sat below the pinky's resting load, so a hand resting on the device fired
    phantom presses. Baseline tracker slowed so it no longer chases a slow
    press.
    Buzzer cue on the target finger as the stimulus, in every mode, with a
    Settings toggle and cue-length slider. Nothing buzzes on a press or a
    miss.
    Settings shows live sensor feedback and opens the data folder. Trial CSV
    gains stim_delivered; pauses are recorded.
    analysis/ holds a not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
    [calibrate_buzzers.py, calibrate_fsr.py, calibrate_rest_vs_press.py, default.yaml, engine.py, test_bilateral.py]
2026-08-04 Cue modality options, participant metadata, analysis guide
    Cue can now be set to visual only, vibration only, or both, from a pill
    in Settings. Vibration only withholds the on-screen reveal so the finger
    has to be found by touch, which is the condition that isolates the
    tactile channel. Logged per trial as cue_mode. This restores the
    comparison the project line started from; the buzzer previously fired on
    every trial so there was no contrast left to measure.
    metadata.json gains the participant details that cannot be recovered
    after a session: affected side, dominant hand, impairment score and hand
    measurements. Affected side matters most, since bilateral asymmetry is
    signed and pooling a mi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
    [default.yaml, engine.py]
2026-08-04 In-app calibration and buzzer channel mapping
    Calibrate button on the title screen walks through hand off the device,
    hand resting, each finger, all four together, then the buzzers. The
    result is saved and stamped into every session that runs under it, so
    the analysis can say what a press meant on the day.
    Press thresholds no longer double-count the resting load. The baseline
    already sits at the resting level, so a trigger only has to cover the
    resting-to-press gap. This drops the pinky from 6.77 N to 4.04 N, under
    the healthy little-finger maximum Demouche recorded.
    Buzzers now route through motor.channel_map, so a motor wired to a
    different pin than the sketch assumes is corrected in the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
    [calibrate_buzzers.py, calibration_profile.py, default.yaml, engine.py, test_calibration.py]
2026-08-04 Fix latching thresholds, add balanced target schedulers
    A calibrated finger could latch pressed for a whole block. The detector
    caps release at (on_thr - 10). With on_delta under 10 that put the
    release point below a resting hand, so a finger registered one press and
    then could only release by lifting off the device. Every later trial on
    it scored a miss, which reads in the data as a paralysed finger rather
    than a threshold fault. Reproduced with the real detector: 30 seconds
    back at rest and it was still pressed.
    Thresholds are now computed against that cap, gaps too small to carry a
    valid threshold are refused during calibration, and the shipped release
    values are written already capped s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
    [calibration_profile.py, default.yaml, test_calibration.py, test_scheduling.py]
2026-08-04 Give every finger a fair share of trials in every mode
    Classic ran a fixed [1,0,2,1,3,0] repeated eight times: index and middle
    got 16 trials each against 8 for the ring and pinky, in an order short
    enough to learn in seconds. In bilateral it named only lanes 1 to 4, so
    the left hand was never cued once across a 48-trial block while its lanes
    stayed live and could only lose points.
    Rhythm's bilateral pattern repeated the middle and ring within its cycle,
    giving them twice the notes of the index and pinky on every track.
    Adaptive weighting with no floor left the strongest finger on about 5% of
    trials, too few to average, and nothing balanced the two hands.
    Classic, rhythm and bilateral now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
    [beatmap.py, default.yaml, engine.py, test_mode_balance.py]
2026-08-04 Add regression tests for the calibration review findings
2026-08-04 Normalise force by each sensor's own calibration
    Pads differ in sensitivity: a light press reads about 49 counts on the
    index and 115 on the pinky. Raw counts were never comparable between
    fingers, so every cross-finger force figure was partly reporting the
    hardware. Force is now also expressed as a fraction of that finger's own
    calibrated press, which is comparable. Newtons are kept alongside for the
    comparison against Demouche's healthy figures.
    Verified: the same patient effort on two rigs whose pinky pads differ
    reads 57% apart in raw counts and 0% apart normalised.
    The analysis no longer collapses several calibrations into one. A
    selection spanning two calibrations used to report the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
2026-08-04 Note that a two-finger pool forces a predictable alternating order
2026-08-04 Fix cross-hand calibration leak and unreachable triggers
    Review found two ways a calibration could ruin a session.
    A pad carrying more load at rest than the finger can add produced a
    trigger above the finger's whole travel, and the profile still saved as
    usable. On the real device a pinky moving 28 counts against a 31-count
    resting load got a 34-count trigger: unreachable, so every pinky trial
    would score a miss and read as a paralysed finger. Refused now, with a
    message naming pad placement as the cause.
    Thresholds were written into the shared fsr config, which both detectors
    read when they are rebuilt. Calibrating the strong hand therefore handed
    its numbers to the affected hand at the n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
    [calibrate_buzzers.py, calibration_profile.py, engine.py, test_calibration.py, test_mode_balance.py, test_rehab_analysis.py]
2026-08-04 Remove an order bias and a lost weighting in the schedulers
    The shuffle bag fixed a boundary collision by swapping the first two
    entries, which sent the just-played lane to index 1 on 50% of boundaries
    against the 33% an unbiased order gives. That is a rhythm a patient can
    pick up on, which turns a reaction time into an anticipation. Reshuffles
    instead, measured back to 0.333.
    With exactly two lanes the floor scheduler zeroed the previous lane to
    suppress a repeat, leaving one candidate, so the weights were discarded
    and the mode emitted a fixed alternation. In adaptive and mirror the
    weighting is the mode, so a two-finger drill has to keep favouring the
    weaker finger. No-repeat now applies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
    [test_scheduling.py]
2026-08-04 Correct what the normalised force column can be read as
    Dividing a finger's force by its own calibration press removes the pad
    difference, but the calibration press is the patient's own light press,
    so a genuinely weak finger produced a small reference too and the
    division cancels the real weakness along with the hardware. Verified on
    four identical pads with a 4:1 weakness gradient: every finger came out
    near 1.0.
    The column stays, renamed to relative effort against that finger's own
    reference press, which is what it actually measures and is the right
    basis for consistency and for change over time. Between-finger strength
    comparisons now show the newton figures with the pad differences sta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
2026-08-04 Auto-save 2026-08-05 01:32 AWST
    [12345_50_20251014.csv, 123_123_session_all_20251015_130755.csv, 1_1_20260512.csv, 1_1_session_all_20260512_125416.csv, 20551122_22_20251013.csv, 20551122_22_20251016.csv, 20551122_22_session_all_20251016_121005.csv, 20551410_22_20251014.csv]
2026-08-04 Notebook in my own words, plus a run everything below button
    Picking a save and then running twenty cells by hand was the wrong
    workflow. The button sits next to the dropdown, stays disabled until a
    save is picked, and runs every cell under it. Handles classic Notebook
    and Lab 4 / Notebook 7, which have completely different APIs, and if it
    cannot reach either it says to use Run then Run All Below rather than
    firing an alert.
    Rewrote every markdown cell and comment so it reads like I wrote it
    instead of like documentation aimed at me. Same facts, same caveats,
    same numbers. The opening is four lines now rather than a wall of text,
    with each caveat moved down to the section it actually belong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
2026-08-04 Make the notebook stand on its own
    session_analysis.ipynb now carries the whole analysis in folded cells and
    imports nothing local. Hand someone the one file and it works. Proved it
    by copying only the .ipynb into an empty directory with a sessions folder
    and running it there: zero python files present, no errors, 8 figures.
    rehab_analysis.py and parts/ are gone. The code moved into the cells, it
    was not rewritten. A differential run over 4 selections and 2 session
    trees gave byte-identical output against the old module.
    Every code cell is folded, so scrolling shows headings, the picker and
    results, and nothing else until you open a fold. Markdown is down from
    1703 words to 507, no cell ov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
    [test_rehab_analysis.py]
2026-08-05 Degrade instead of raising when there is no sessions folder
    Opening the notebook with no recordings threw FileNotFoundError out of
    the first cell and stopped everything. The message was clear but a
    traceback is a rotten way to meet someone who has just opened the file.
    It now says where it looked and how to point it somewhere else, and every
    section below reports it has nothing rather than falling over.
2026-08-05 Stop the person picker matching the path above the sessions
    Picking one person from the dropdown ran resolve(), which fell back to a
    substring match on the whole absolute folder path. This repository lives
    under a directory with my own name in it, so asking for my games matched
    every folder on disk and pooled P01's blocks into my results: 4 games and
    198 trials where there should have been 2. Nothing in the output said it
    had happened. Anyone whose name appears in a parent directory hits the
    same thing.
    It matches the folder's own name now, exactly first so a de-duplicated
    sibling cannot be caught by a prefix.
    The dropdown also carried a positional catalogue index, and the button
    re-runs t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
    [test_rehab_analysis.py]
2026-08-05 Warn that results are stale when the save changes, collapse all inputs
    The run button cannot tell success from silence. ipylab's execute() posts
    over the widget comm and returns without waiting, and JupyterFrontEnd()
    constructs fine with no front end attached, so the no-front-end branch
    was unreachable and the button claimed to have run something either way.
    Changing the save now says outright that everything below is the previous
    one until it is re-run, so the header cannot name one save while the
    tables show another.
    Every code cell also carries collapsed as well as source_hidden, and the
    notebook carries the document-level hint, so inputs are folded on open.
2026-08-05 Read the new four-way cue state in the analysis
    Sessions from v3.2 record cue_flags and cue_target_shown instead of the
    old cue_mode. The cue comparison now reads either, mapping the new state
    back onto the three names the earlier work reported, and keeps the exact
    four-way state alongside for a finer split.
    The screen switch is what decides the label, not the buzzer. What made
    the old vibration condition worth reporting was that the screen did not
    name the finger, so it had to be found by touch.
2026-08-05 Four sensory cue toggles, per-hand calibration, v3.2
    Replaces the buzzer on/off pill and the both/visual/vibration pill with
    four switches that are each on or off on their own: buzzer before, sound
    before, sound after, buzzer after. All 16 combinations work and every
    mode honours them, rhythm included, which was the one mode where the cue
    sound switch did nothing at all.
    The screen reveal is a fifth switch, kept separate on purpose. What made
    name the finger, so it had to be found by touch. Folding that into the
    four would have quietly retired the tactile-only experiment.
    After-press cues fire on a correct press only,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
    [default.yaml, engine.py, test_buzzer_cue.py, test_capture_completeness.py]
2026-08-05 Match the firmware that is actually on the device
    The PlatformIO project is what is flashed now, so it moves out of bin
    into arduino/firmware_on_device, and the handover sketch moves the other
    way into bin/old_handover_sketch_Arduino_20251111.
    That swap explains why the buzzers never worked. The handover sketch
    drives D3 to D6, the firmware on the device drives D11, D10, D9 and D6,
    and the hardware is wired for the latter. Only the pinky pin overlapped
    at all, which is why nothing was felt on any finger.
    Everything else about the two is the same: 115200 baud, FSR: a,b,c,d
    out, STIM:n and STOP in, a 150 ms stim hold, 200 Hz sampling and the
    same I2C addresses. Its motorPins array is in fing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
    [calibrate_buzzers.py, default.yaml, engine.py, main.cpp, test_calibration.py]
2026-08-05 Only drive one motor per board at a time
    All four motors on a board share one darlington driver. The firmware's
    own source says it cannot supply them together and that only one should
    be on at a time. The firmware turns each motor off on its own 150 ms
    timer, so two fingers cued inside that window were both driven, and that
    does not give two buzzes, it gives two weak ones. At that point the cue
    the patient reacts to is not the cue that was asked for.
    A pulse aimed at a different finger on the same board now stops that
    board first and drops anything still queued for the finger it cut off.
    The stop is hand-prefixed, so in mirror mode the two hands still buzz
    together: separate boards, separat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
    [beatmap.py, engine.py, test_sensory_cues.py]
2026-08-05 Serialise audio decoding so the app cannot die mid-session
    The rhythm setup screen probes each song's duration on a worker thread,
    and librosa.get_duration opens the file through soundfile. Two threads
    inside sf_open on an mp3 at the same time takes the whole process down
    with SIGBUS, so a duration probe overlapping a beatmap extraction killed
    the app outright. In a session that means the block is gone.
    extract_beatmap already held DECODE_LOCK for this reason. The duration
    probe did not, and its own guard only stopped one screen starting a
    second worker, not two screens or a screen and an extraction.
    This is what the intermittent bus error in the test suite was. It has
    been dismissed as en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
2026-08-05 Fix the run button, give the pinky a longer buzz, pin the notebook contract
    The button sent notebook:run-all-below, which starts from whichever cell
    the notebook thinks is active. Clicking a button inside an output area
    does not make its cell active, so it ran from wherever the cursor was,
    and from the last cell it did nothing at all. It runs every cell now,
    which does not depend on the cursor. The chosen save survives that
    because cell 1 reads pick back out of globals rather than resetting it.
    The pinky motor is the weak one. The firmware already drives it harder
    than the other three and that PWM is compile-time, so buzz length is the
    only lever the host has. motor.cue_ms_per_finger gives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
    [default.yaml, engine.py, test_notebook_matches_software.py, test_sensory_cues.py]
2026-08-05 Keep the Arduino connected without restarting the app
    The reader thread exited for good the first time a read failed. A USB
    glitch, the board resetting, the cable nudged: any of them killed the
    connection permanently and the only way back was restarting Python.
    Mid-session that costs the block. It now closes what is left, waits, and
    opens again, backing off so an unplugged board does not spin and never
    giving up, because plugging the cable back in should be the whole fix.
    Changing a port in Settings needed a restart too, and the screen said so
    out loud. It applies straight away now, through the same rules startup
    uses: both were the same logic written twice and only one copy was ever
    kept c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
    [default.yaml, discovery.py, engine.py, test_connection_reliability.py, test_sensory_cues.py]
2026-08-05 Let SDL own the mouse mapping, and fold the notebook on every run
    The click boxes were still off. The cause was a hand-written scale: the
    app drew to a 1280x800 surface, stretched it onto the window, and undid
    that by hand for every mouse position. Getting the draw transform and
    the hit-test transform to agree by hand is a bug waiting to come back
    each time either side is touched, and it did.
    pygame.SCALED does both. The surface handed back is always 1280x800
    whatever the window size, SDL stretches it, and SDL translates mouse
    events back into the same space before pygame sees them. The manual
    transform is gone, so the two cannot disagree.
    F3 draws a crosshair wherever the app thinks the p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
    [engine.py]
2026-08-05 Fix the motor timer overflow that killed the buzzers after a minute
    stimOffAt held each motor's switch-off deadline in a uint16_t while
    millis() is 32-bit, so it only covered the first 65536 ms of uptime.
    Past 65.5 seconds the stored deadline could no longer represent the real
    time, the switch-off test was true the moment it was looked at, and
    every motor was cut microseconds after being told to turn on.
    That is why the buzzers worked for about a minute and then stopped with
    no error anywhere, why the force sensors were unaffected, and why only
    restarting the app brought them back: reopening the serial port resets
    the board and restarts millis() from zero, buying another 65 seconds.
    The ear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
    [buzz_soak.py]
2026-08-05 Keep outputs visible, only fold the inputs
    A probe left outputs_hidden on every cell, which would have collapsed
    the results as well. The results are the only thing meant to be on
    screen. Also removes the probe notebook it left behind.
2026-08-05 Sensory Cues on the results screen, and stop tests writing real settings
    Between two blocks is when the cue condition actually gets changed: run
    one with the buzzer, run the next without, compare. That meant going
    back to the title screen and into Settings, four clicks away from what
    the researcher came to the results screen to do. The same menu is on the
    results screen now, opening upward because the pill sits low and a list
    opening down would run off the bottom.
    One definition, shared. The rows and the setter moved to module level so
    the two screens cannot drift apart: a switch meaning one thing on one
    screen and something else on the other would be worse than no switch.
    Tests can no lon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
    [test_screen_layout.py]
2026-08-05 Cover the objectives the report commits to, and restore what the rewrite dropped
    An audit read the progress report and the past theses, mapped the twelve
    numbered objectives against what the notebook produces, and found real
    gaps. Thread D objectives 1 and 2, startup latency and the sub-two-second
    setup, had no output at all. Neither did statistical inference: no
    intervals, no tests, no effect sizes anywhere, in a project whose own
    software table lists scipy. The Abstract commits to comparing the three
    training modes and the report promises a fixed-cadence against RAS
    comparison in three separate places; neither had a section.
    Added, each tied to a quoted line in the report rather than inve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
2026-08-05 Put the opening back to three lines
    The selection table went into the intro, which is the first thing anyone
    sees. It is real reference material but it belongs beside the code it
    configures, so it moved into the setup cell's comments where someone
    setting pick by hand is already looking.
2026-08-05 Rebuild the notebook for VS Code, which is where it is actually opened
    Three attempts at collapsing the inputs failed because I never asked
    which editor was being used and assumed JupyterLab. Basil opens it in VS
    Code, where none of it applies:
    VS Code's ipynb serialiser has no reference to source_hidden,
    outputs_hidden or collapseState. It round-trips cell metadata and
    never acts on it, so the metadata does nothing there. Of its 240
    notebook.* keys none collapse inputs by default, only manual commands.
    And ipylab drives JupyterLab's command API, which VS Code does not
    have, so the Run button could never have worked and it was throwing a
    visible widget error on every open.
    Si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
2026-08-07 Plumb the mode picker for four new modes
    Seven cards in a two-column grid: Reaction, Adaptive, Patterns, Chords,
    Rhythm, Syllables, Mirror. Reaction replaces Classic on the picker.
    Classic's fixed six-trial loop was learnable in seconds, so half of what
    it measured was anticipation; begin_classic_block survives for old
    sessions and tests, it just is not offered.
    The four new entry points drop back to the picker until each mode lands,
    so a card can exist before its mode does without stranding anyone.
    Two columns join the trial log ahead of the modes that write them:
    stimulus (the word in syllables mode, the chord in chords mode) and
    pattern_trial (sequence or random probe, which is the enti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
    [engine.py]
2026-08-07 Four new modes built from their research briefs
    Reaction replaces Classic as the baseline. Truncated-exponential
    foreperiod seeded per block so the wait cannot be timed, 10% catch
    trials, sub-100 ms presses scored as false starts that never become
    hits, choice over the four fingers through the balanced scheduler with a
    simple-RT config switch, millisecond feedback and session bests. The
    measurement floor (60 Hz display, 200 Hz sensors) is stated in the mode
    docstring rather than hidden.
    Patterns is a proper SRTT. A 12-item second-order conditional sequence
    built as a seeded Eulerian circuit on the four fingers: each finger
    three times per cycle, all twelve transitions exactly once, so only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
    [default.yaml, engine.py, test_chords_mode.py, test_info_overlay.py, test_pattern_mode.py, test_reaction_mode.py, test_syllables_mode.py]
2026-08-07 Analysis chapters for the four new modes, and the cross-talk heatmaps
    Reaction opens with the measurement floor stated before any figure: a
    60 Hz display and 200 Hz sensing mean single-trial differences under
    about 20 ms are noise, block medians resolve about 20 ms, session pools
    10 to 14 ms. The RT distribution excludes and counts anticipations, and
    a foreperiod-vs-RT diagnostic catches patients timing the wait.
    Muscle memory draws the SRTT learning curve, trained takes filled and
    probes open red, with the literature anchors printed beside it, and
    scores each probe against its flanking trained blocks with bootstrap
    intervals.
    Chord mode validates the difficulty ladder against the patient'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
    [test_notebook_matches_software.py]
2026-08-07 A verified reference list, and three citation errors fixed
    The notebook ends with 79 references in 7 groups: reaction time, motor
    sequence learning, finger individuation and enslaving, phonological
    awareness rhythm and dyslexia, motor learning and rehabilitation,
    measurement methods, and the nine Curtin project theses this device line
    runs through, each identified from the Past Years folders by author,
    year, role and student number.
    Every public reference was verified against publisher or index pages
    before listing. One entry could not be fully confirmed (Aiden's firmware
    authorship) and says so with a visible details-to-confirm marker instead
    of a guessed detail: an invented reference foun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
    [engine.py]
2026-08-07 Close the tactile-only leak the polish verification caught
    With cue.show_target off, the timing bar was armed only on the target
    lane, so the tactile-only frame named the finger anyway: a bar counting
    down over one tile is as loud a cue as the highlight it replaced. Every
    lane now runs the identical bar in that condition, so the countdown
    survives and the frame carries no lane information.
    The gate test that let this through only ever looked at the target
    lane. A new test asserts every visual property a lane strip exposes is
    identical across all four lanes at cue time with the reveal off, which
    is the condition the whole tactile experiment rests on.
    Most of the UI polish (mode-accent progr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
    [engine.py, test_sensory_cues.py]
2026-08-07 Pin the cue timing per mode and finish every mode's screen
    The cue instrument found one real timing defect: the syllables beat
    model re-anchored each syllable to the frame clock, so the 2 Hz grid
    stretched by up to 25 ms per word. Absolute deadlines bring the model
    IOI to 500.6 ms mean with drift bounded at one frame. The rest of the
    cue path measured clean: one tone and one STIM per cue at every mode's
    fastest pacing, sub-frame alignment to the arm timestamp, correct
    150+40 ms chord arpeggio, recovery through a mid-block serial drop.
    tests/test_cue_timing.py holds the line.
    Screens: message chips with pop-in, stim ignition ring keyed on
    lane.active so the tactile gate cannot leak, reaction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
    [default.yaml, engine.py, test_cue_timing.py, test_screen_layout.py]
2026-08-07 Both hands means eight fingers everywhere, and two real bugs die
    Patterns runs its trained sequence across both hands, Chords
    alternates whole chords between hands under paired balancing, and
    Syllables counts either hand's finger for each syllable position, so
    selecting Both now puts all eight fingers in play in every mode. One
    3-second GET READY prep replaces each mode's mismatched waits.
    tests/test_hand_support.py proves the matrix through the real engine,
    left board routing and mirrored labels included.
    Syllables now reads as a story: every phase announces itself (LISTEN,
    WATCH with hands off, GET READY, YOUR TURN), the count-in counts down
    to GO, response blocks are hollow outlines that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
    [default.yaml, engine.py, test_chords_mode.py, test_hand_support.py, test_syllables_mode.py]
2026-08-07 Three new modes: Force Pilot, Lighthouse and Buzz Hunt
    Built from the verified research briefs in docs/new_mode_research.
    The foundation they share: per-finger max-press probes persisted with
    the calibration profile, ForceView continuous calibrated force access
    (the 200 Hz analogue signal was only ever used as a press threshold
    before this), timed motor pulses with a measured 20 ms floor, and
    four new trial columns plus raw-stream segment markers so the
    notebook can rebuild every target trajectory exactly.
    Force Pilot: finger force flies a craft through corridors of holds,
    ramps, sines and a seeded assessment section; release scored apart
    from press (Lodha 2013, Pennati 2020, Taud 2021). Li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
    [calibration_profile.py, default.yaml, engine.py, test_buzz_hunt.py, test_force_foundation.py, test_force_pilot.py]
2026-08-10 Triple-checked logic audit: 33 findings, 16 survived, 12 fixed
    Eleven auditors drove every mode and the analysis chain headlessly
    against a fixed checklist (does the score match the trained ability,
    can difficulty ratchet on a metric the patient cannot influence, can
    the scoring be gamed, is every comparison fair). Two independent
    skeptics then tried to refute each finding by reproduction and by
    clinical consequence; only findings that survived both went near a
    fix. Fixes were verified by reproducing the ORIGINAL problem headless,
    not by reading the diff.
    Reaction: guessing every trial (0% choice accuracy, fast presses) read
    as a clean block and advanced difficulty, because the lapse-rate
    f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
    [engine.py, test_buzz_hunt.py, test_capture_completeness.py, test_mirror_mode.py, test_reaction_mode.py, test_rhythm.py, test_syllables_mode.py]
2026-08-10 The five documented audit findings are fixed, none left
    Reaction: every trial row now logs the hand its lane belongs to, so
    bilateral reaction blocks split by hand in analysis; block accuracy
    reaches the notebook's stored-stats table; the response-window level
    finally shows on screen instead of living only in metadata.
    Pattern: the SRTT chapter now performs the consistency check its own
    docstring promised, splitting sessions whose rsi/timeout/cue settings
    differ instead of silently pooling their RTs; random_block_trials
    rounds to 64 so the finger-balance claim holds across 8 lanes; the K8
    bimanual sequence backbone gets its first tests.
    Mirror: two new columns, mirror_right_rt_ms and mirro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
    [default.yaml, engine.py, test_buzz_hunt.py, test_force_pilot.py, test_force_pilot_notebook_levels.py, test_mirror_mode.py, test_notebook_matches_software.py]
2026-08-10 All 113 audit findings fixed: every mode, the notebook, keyboard play
    Fourteen sequential stages, each reproducing the original problem
    against the real engine or notebook before touching code and again
    after, with a regression test per fix. Grouped by area for shared-file
    safety since almost every stage touches engine.py, screens.py or the
    notebook.
    Foundation: the notebook's chords chapter used five constants it
    never defined, so Run All crashed on any selection containing a
    chords block and nothing after it ran. Keyboard-only sessions logged
    every trial as a fabricated hardware cue failure (the buzz attempt
    ran even when the active source could not deliver one), so the
    notebook blanket-e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
    [default.yaml, engine.py, test_adaptive.py, test_buzz_hunt.py, test_force_pilot.py, test_force_pilot_notebook_levels.py]
2026-08-11 Quick calibration at session start and a guard on mid-session exits
    A first-time player now meets a pressure-bar game after Setup: rest
    capture, then per finger a live bar with a glowing target band and a
    hold-to-fill meter that pops when the light press lands. It collects
    the same captures as the clinical calibration screen and saves and
    applies through the identical CalibrationProfile path, so the
    thresholds are numerically the ones the clinical flow would compute
    (the verifier asserted this). The target band sits at the level the
    games actually score, so the teaching is honest. Returning players
    skip at zero cost, keyboard sessions never see it, bilateral runs
    left hand first, Skip for no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
    [SRT_Sequence_learning_Final_v2.py, default.yaml, engine.py, test_exit_confirm.py, test_quick_calibration.py]
2026-08-11 EEG marker layer: the game is now its own lab program
    Replaces Aiden's unwired prototype (whose map used 30 for miss while
    Welber's pipeline epochs on 30 as stimulus onset; the conflict and
    the open question are documented in the module docstring). The new
    rehab/hardware/eeg_trigger.py speaks the lab's serial protocol with
    the two old-file bugs corrected deliberately: 10 ms pulses held on a
    real clock (the old frame-counted hold delivered 1-4 ms, risky at
    amplifier sampling rates) and single-byte writes for every code (the
    old chr encoding emitted two bytes above 127).
    Marker scheme in readable bands: preparation 20-25, stimulus onset
    30-38 by cue condition (30 stays pure stimulus onset for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
    [default.yaml, test_eeg.py, test_eeg_contract.py]
2026-08-11 Save the EEG research notes and integration spec
    Three research lanes (event-related potentials incl. the ERN
    correctness response, motor preparation and attention with the
    honest limits on attention indices, trigger hardware and timing
    validation) plus the integration spec the marker layer was built
    from. The spec records the two bugs found in the old lab file and
    the conflict between Aiden's prototype code map and the lab's
    epoch-on-30 convention, with the open questions for Welber listed.
2026-08-11 Session login model, chords warm-up fix and bimanual chords, syllables read-across row, shorter pattern rests, honest mode cards, reaction UI
    Sessions now work the way Basil described: boot lands on a login
    screen (name and age, stored in metadata), game select is home base,
    a mid-game quit asks End this game and lands back on game select
    with everything saved, and the only session warning is on leaving
    game select for the login screen, with a games-and-minutes summary.
    EEG session markers bracket the login, not the process.
    Chords: the single-finger experience was the unsignposted probe
    warm-up: 8 to 16 single-finger trials (26 to 53 s) before any chord.
    Probes now wear a WARM-UP banner wi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
    [default.yaml, engine.py, test_chords_mode.py, test_exit_confirm.py, test_hand_support.py, test_pattern_mode.py, test_quick_calibration.py]
2026-08-11 One-folder EEG lab package built by CI
    FingerRehab-EEGLab-Windows.zip: the self-contained exe, the lab
    config, a double-click launcher and the setup notes in one folder.
    Copy to the lab desktop, plug the trigger box in, double-click. No
    Python, no PsychoPy, no pip: the exe carries everything, and CI
    builds the package from the same commit as the game on every push,
    so the lab version can never lag the code.
2026-08-12 Base folder cleanup
    The package is finger_rehab now (was rehab), tools/ is scripts/, and
    tests/ keeps its name because that is the name every Python tool
    expects. All 87 files of references updated; prose that used rehab as
    a plain word repaired back afterwards. The spec, launchers, CI and
    notebook all follow.
    arduino/ holds only the firmware that is flashed; the one-off address
    sketches moved to bin and the hardware guide to docs. The calibration
    scripts the in-app flow replaced moved to bin; buzz_soak and
    test_device stay in scripts/.
    Notebook outputs now land inside the session folder they describe
    (sessions/<date>/<session>/analysis/), so a session folder is
    self-contained and analysis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
    [individuation_per_trial.csv, selected_trials.csv, session_summary.csv]
2026-08-12 Rayan and Welber's methods in the analysis, research docs consolidated
    Rayan's two reference methods now live in the notebook, verified
    against his actual scripts. His exact Teasdale onset algorithm is the
    one canonical implementation in finger_rehab/analytics/signal.py
    (replacing our paraphrase and the notebook's divergent copy, both
    pinned by AST-equality tests): trial-by-trial parity with his
    process_force_peaks.py on real sessions is exact, every detection
    identical within 0.05 ms. The Movement onset chapter compares
    onset RT to the game's logged RT (logged sits ~50-65 ms after true
    movement onset, r 0.96-0.99). A new Baseline drift chapter
    reproduces his static-versus-250 ms-look-back c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
    [test_eeg_contract.py, test_notebook_matches_software.py, test_pause.py, test_signal.py, test_startup.py]
2026-08-12 Restore the EEG lab setup notes lost during the rename shuffle
    The md-to-txt rename staged cleanly but the destination file
    disappeared from the worktree before the commit, so the repo briefly
    had no setup notes at all and the CI lab-package step failed on the
    missing file. Recovered from the last commit that had it.
2026-08-12 Cut the MATLAB handover doc to the basics
2026-08-12 Auto hand assignment and a one-folder lab package
    Boot now assigns the first detected board to the right hand and the
    second to the left, with no Settings visit needed. A saved port
    override that names a port which no longer exists no longer holds the
    game hostage: it falls back to plug order and says so. Overrides for
    ports that do exist still win, and the Settings panel states which
    rule is in force.
    docs/lab_package is the whole lab install: the exe (gitignored, the
    build scripts drop it in), eeg_lab.yaml, the setup notes, the bat as
    a convenience window, and run_from_source.py for anyone who wants the
    Python route. Double-clicking the exe works on its own now, since it
    picks up the eeg_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
    [default.yaml, discovery.py, engine.py, test_connection_reliability.py, test_eeg_contract.py, test_hand_autoassign.py]
2026-08-12 Notebook exports one HTML per run, and the instruction files get cut back
    Every run now writes report.html into the session folder it analysed,
    holding everything the notebook printed and drew with the figures
    embedded, so it opens anywhere as one file. Analysing a single person
    also writes sessions/individual_patient_results/<name>/summary.html,
    replaced each run so it is always their latest full analysis, with a
    line appended to runs.txt beside it.
    The capture hangs off keep(), which every section cell already calls:
    prepare() wraps each sec_ function so its output is buffered, printed
    straight back out (cell output is unchanged) and filed with whatever
    figures appeared while it ran. A se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
    [test_notebook_matches_software.py]
2026-08-16 Syllables slides its word window across every finger; session-level calibration and light game exits
    A word of n units still taps left to right in reading order, but its
    window now slides across the desk row word to word, so ring and
    little fingers play short words too and neither hand idles in
    bilateral play. The window owns its lanes, the screen shows placement
    with resting seat dots, the offset is logged (map=off<k>) and the
    notebook rebuilds lane-per-unit exactly, with a per-finger
    participation table.
    Calibration is a session event now: the first game that needs a hand
    runs the pressure-bar flow, later games skip it across hand-mode
    changes, a hand added mid-session calibrates alone, a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
    [default.yaml, engine.py, test_exit_confirm.py, test_hand_support.py, test_keyboard_only_navigation.py, test_quick_calibration.py, test_rehab_analysis.py]
2026-08-17 Syllables places each word over the least-cued fingers
    The verifier's honest caveat on the sliding window: dealing OFFSETS
    equally still starved the edge fingers, because an edge lane sits in
    one window position while a middle lane sits in up to n. Measured in
    bilateral play: index fingers cued 32 times while the littles got 8.
    The draw now scores every candidate offset by the cue tally of the
    lanes its window would cover and picks uniformly among the lowest,
    with mixed word lengths sharing one tally. Measured after: one hand
    40/36 (was up to 3 to 1 possible), bilateral 20/19 across all eight
    fingers (was 4 to 1). The random tie-break keeps placement
    unpredictable across seeds, pinned by a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
2026-08-17 Note in the handover doc that keyboard sessions have no sample rows
2026-08-17 Auto-save 2026-08-17 21:00 AWST
    [raw.csv]
2026-08-23 Cut the lab README to just how to run
2026-08-24 Full audit round two: 93 findings, every fix verified by re-driving the software
    Highest severity closed: reaction difficulty, clean-block progress and
    session bests no longer survive into the next patient's session; the
    mirror pick paths run quick calibration like every other mode; the
    lighthouse echo study lane must actually be released during the blind
    delay; a single board dropping in bilateral play parks that hand's
    detector, clears its latches, re-primes on reconnect and shows a red
    connection banner instead of fabricating phantom presses; syllables
    EEG response markers carry the press's own timestamp.
    Chords honesty batch: sensor dropouts close trials as device_drop
    (excluded from th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
    [selected_trials.csv, session_summary.csv]
2026-08-24 Tests can no longer write into the real sessions tree
    The audit's verifier found seven tests building engines straight from
    Config.load(), which dropped an NA folder into the real sessions tree
    on every suite run; 55 of them had piled up. The default data_dir is
    now redirected to a temp path at load time, so a test that forgets
    the redirect no longer matters, and a session-scoped guard fails the
    run if anything writes there anyway. The stale folders moved to bin
    and the index lines went with them.
    The guard is session-scoped rather than per-test on purpose: walking
    the tree every test is slow enough on the cloud-synced copy to look
    like a hang.
    [raw.csv]
2026-08-24 Calibration polish and a PsychoPy trap closed
    Three rough edges the verification sweep caught: the hold instruction
    stayed under the ring after the press was already banked, Skip on the
    finished calibration would have binned four measured presses while
    still reading as free (it says Discard and skip there now), and Force
    Pilot showed a finger count and a press count side by side with
    nothing saying they counted different things.
    run_from_source.py now catches the PsychoPy case properly. Standalone
    PsychoPy ships classic pygame, so the plain import check passed and
    the game died later on a pygame-ce call looking like an unrelated
    fault. It names that specifically, tells the user the install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
2026-08-31 Boards join on their own, every wait is skippable, calibration moved to login
    Plugging an Arduino in now brings it into play at any screen with no
    Refresh press: a background port watcher publishes a change counter,
    the frame path rebuilds through the normal reconnect when a new hand
    can be served, a replugged board returns to the hand it had with its
    baseline re-primed, and a board arriving mid-block waits for block
    end rather than disturbing a running trial. The mid-block guard was
    also genuinely broken before this: it read an attribute nothing ever
    set, so it could never have fired.
    Every enforced wait in every mode can be skipped: a chip with the
    remaining time on waits over 2.5 s, Spac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
    [default.yaml, discovery.py, engine.py, test_autoconnect.py, test_classic.py, test_quick_calibration.py]
2026-08-31 Menu music, vs-last-time chips, and the first slice of the mode fixes
    Six upbeat Kevin MacLeod tracks with their licence files and an
    updated attribution list. A menu music player shuffles them on the
    four menu screens only, fades out inside the GET READY when a block
    starts, ducks under the results chime, and is guarded inside the
    audio engine so it can never take the music stream off rhythm.
    Settings gains a music slider and an on/off pill.
    Every end screen now compares the game to the same participant's
    previous completed game of the same mode and hand: one chip beside
    the headline, direction-aware per mode, absent on first plays.
    Also closes a bug shipped in the last commit: the skip b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
    [default.yaml, engine.py, menu_music.py, test_chords_mode.py, test_menu_music.py]
2026-08-31 Band-keeping holds, buzzers land on the beat, Buzz Hunt gets a cap
    Closes the remaining three of the four mode fixes (chords landed in
    the last commit).
    Adaptive: config bpm_max moves to 180 to match the band-keeping
    blend already in the controller. Measured on a headless 280 ms
    simulated hand: at 140 the trailing hit rate never re-entered the
    65-80 band in 300 trials (parked at 100 percent); at 180 it settles
    back inside around trial 53, about half a minute of play. The two
    tests pinning the old utilisation veto now pin the blend (veto kept
    in band and for all-Lates play), plus a closed-loop settle test.
    Rhythm: the cue path (buzz, tone, EEG marker ride one on_stim) now
    dispatches against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
    [default.yaml, engine.py, test_adaptive.py, test_buzz_hunt.py, test_rhythm.py]
2026-08-31 Force Pilot and Lighthouse redrawn as clinical instruments
    Both screens now speak the band-and-marker grammar quick calibration
    teaches at login. Presentation only: trial rows, raw events, scores
    and block_stats byte-equal on a scripted run before and after.
    Force Pilot: the craft, halo and gold rings are gone. The corridor
    is a quiet band on a percent-of-max grid; the patient is a plain
    trace ending in a marker on a fixed now-line. Sections announce
    themselves in words, baked labels scroll with the band, release
    stretches draw in their own grey with a down arrow, and time in
    corridor is the one large number. Stalls stay steady-state and name
    the direction to correct.
    Lighthouse: the lante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
    [test_force_pilot.py]
2026-09-01 Echo span mode lands and syllables earns its rewards
    Echo is the explicit memory game: watch-then-repeat sequences on the
    Kessels ladder, light plus buzz, a hidden repeating sequence every
    third trial, and a fatigue guard whose omission streak survives the
    forced rest so a silent hand ends as fatigue rather than a fake
    memory result. Wired end to end: prep countdown, mode card, setup,
    EEG id 12, hand matrix tests, notebook chapter.
    Syllables keeps its one game and gains a deterministic reward layer:
    per-tap marks from what scoring already computes, streak stars at
    3, 5 and 8, exactly one sticker per finished round, a Bigger words
    card on band promotion, and an ease-in draw after two misses.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
    [default.yaml, eeg_trigger.py, engine.py, test_echo_mode.py, test_echo_notebook_span.py, test_eeg_contract.py, test_hand_support.py]
2026-09-02 Healthy baseline study: intake at login, study battery, cohort chapter
    No patients this semester, so the thesis validates the instrument on
    a healthy cohort first. The design is written up in
    docs/research/healthy_baseline_study.txt: within-subject, both hands,
    28 analysed of 32 recruited, two visits a week apart, a 50 minute
    battery of nine modes, 27 pre-specified validity checks, ICC(2,1)
    with SEM and MDC95, and a low-risk ethics scope with a run sheet.
    Login is now a study intake: participant code, age, sex, dominant
    hand, Edinburgh score, visit number and hand size, all keyboard
    navigable, with the next free code and the visit number suggested
    from the sessions tree. Sessions, the index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
2026-09-02 Simpler login, Play all, menu mute, song preview, Force Pilot music
    Login asks for a main hand, left or right, and nothing more than
    that about handedness: the Edinburgh field is gone and the visit
    number is worked out from the participant's history rather than
    typed. Hand length and breadth prefill from the last session that
    matches the same code, or the same name and age, and say which day
    they came from; typing over them replaces them.
    The hub's study button is now Play all. Menu music sits ten decibels
    under the game music by default, and every menu screen carries a
    mute pill remembered per participant in a small preferences file
    outside the user settings. The rhythm setup screen previe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
    [block_music.py, default.yaml, eeg_trigger.py, engine.py]
2026-09-03 Rhythm buzz leads the beat, echo and buzz hunt reworked, lighthouse retired, real newtons
    Rhythm's tactile cue now leads the beat by 150 ms so an ordinary
    reaction to the buzz lands the press on time, with a bounded running
    correction toward the player's own timing and a dead band so it
    stops hunting on jitter. The old on-beat behaviour and a feedback
    mode that buzzes only on a correct press stay as config choices. The
    EEG layer marks the buzz command with its own code and records the
    buzzer and display latencies and every marker-to-stimulus offset in
    metadata.json, so epochs can be shifted rather than trusted blind.
    The lab config now matches the NeuroSpec MMBT-S box the lab actually
    uses: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
    [default.yaml, eeg_trigger.py, engine.py, force_check.py, measure_battery.py]
2026-09-03 Lab package is four things: exe, yaml, a PsychoPy launcher and its source
    The folder handed to the EEG lab carries no text files any more.
    It holds the frozen exe, the lab yaml the exe loads by itself, a
    single run_in_psychopy.py that Welber opens in PsychoPy Coder and
    runs, and a generated source tree the launcher runs the real game
    from under PsychoPy's own Python. The launcher checks the eight
    packages the game needs and prints one pip line for any that are
    missing, and falls back to the exe when no source tree sits beside
    it. One script assembles the package for the Mac build, the Windows
    build and the CI zip, clears any stale file and refuses an
    unexpected one, so the three can never dr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
    [build_lab_package.py, test_eeg_contract.py, test_lab_package.py]
2026-09-03 Auto-save 2026-09-03 21:00 AWST
    [0804_T6_helddown_newtongraphing_gradualforceincrease_22_20260408.csv, 0804_T6_helddown_newtongraphing_gradualforceincrease_22_session_all_20260408_174442.csv, 0804_T6_heldown_newtongraphing_constantforce_22_20260408.csv, 0804_T7_newtongraphing_constforceV2_22_20260408.csv, grand_average_snr_summary.csv, overall_peak_force_summary.csv, processed_peaks_0804_T6_helddown_newtongraphing_gradualforcein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]
2026-09-04 Syllables becomes a reading game, Echo becomes Simon, one long session
    Syllables is rebuilt for dyslexia practice. The word is spoken and
    shown split into its syllables, then for each syllable in turn four
    options fall down the four finger lanes: one right, three wrong. The
    wrong ones are the mistakes the reading literature says these
    children actually make, vowel swaps, cluster simplifications, b and d
    reversals, letter migrations, and the correct lane is never hinted,
    so the press is a reading decision rather than a copy. Only the right
    finger scores, a missed syllable comes back a few words later, and
    the difficulty follows a three-down one-up staircase that settles
    near four right in fiv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
    [his_grand_average_snr_summary.csv, his_overall_peak_force_summary.csv, his_processed_peaks.csv, his_repeatability_summary.csv, trials_T6_constant.csv, trials_T6_gradual.csv, trials_T7_constant_v2.csv]
2026-09-04 Notebook covers every mode and every one of Rayan's analyses, README is a handover
    Each of the ten modes now has its own chapter that prints the checks
    the literature sets for it, with the measured number, the reference
    value and the citation on the same line, a per-finger breakdown, a
    both-hands comparison where the mode uses both, and a paragraph
    saying plainly what the chapter cannot claim. Mirror and adaptive had
    no chapter at all before this. The reference list grew from 110
    entries to 161.
    Rayan's analyses are all reproduced and checked against his own saved
    results: peak force, repeatability, noise and signal to noise ratio,
    baseline drift raw and zeroed, per-block raw traces and the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
    [raw.csv]
2026-09-04 One sitting, every mode once, and the analysis that suits it
    The collection plan settled on a single session per student with no
    repeated block, so the software now matches it. The battery is eleven
    blocks covering all ten modes, reaction once per hand and the rest
    once each, measured at 44.4 minutes on the rig across five sittings
    through the real engine, inside the 45 minute budget.
    With nothing measured twice there is no test-retest, so the analysis
    drops the intraclass correlation, the standard error of measurement,
    the minimal detectable change, the Bland-Altman plot and every
    before-and-after comparison, along with the two validity checks that
    depended on a second visit. They are dele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
    [default.yaml, measure_battery.py, simulate_cohort.py, test_cohort_notebook.py, test_force_bench.py]
2026-09-05 Every check decides on a real collection day
    A ten student day was simulated through the shipped engine and read
    end to end by the notebook, and the gaps that run exposed are closed.
    Every sitting finished inside the budget, all ten modes produced
    trials on all four fingers of every hand they use, and the analysis
    recovered what was planted in the data: a 25 ms dominant hand
    advantage came back as 28 ms, a 15 ms mirror lead as 15.6 ms, and the
    within block warm up at the right size with its interval covering the
    truth.
    Four checks could never have been decided by any number of students,
    because the battery does not play the thing they test. Force Pilot's
    bandwidth check is now asked of the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
2026-09-09 Plug a board in and the game opens
    A therapist should not have to find an icon. A small watcher starts at
    login, checks the USB ports once a second, and opens the game the
    moment an Arduino appears. It reacts only to a board arriving, and it
    checks a lock the running game holds, so a replug during a session
    cannot open a second copy and closing the game with the board still
    plugged in leaves it closed. The watcher is the game binary in a
    different mode, so there is one executable to build and trust rather
    than two that can fall out of step.
    Registration is per user on both platforms, a scheduled task on
    Windows and a LaunchAgent on macOS. Neither asks for an administrator,
    which is the diff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
2026-09-22 Local_Runner starts the EEG build on this Mac
    Double-click Local_Runner.command and the lab build comes up here:
    same software, same markers, same lab settings. It passes a new
    --no-eeg-box flag, which relaxes the one rule that makes sense only at
    the lab, that the session refuses to start without the trigger box. A
    real box is still used when it opens; with no box the markers go to
    the dummy backend and are still written to raw.csv, so a run on this
    desk produces the same files the lab produces minus the wire.
    Everything else stays two deliverables: the installer for people at
    home, the lab folder for the lab.
2026-09-22 Analysis says what the data supports, not what the maths fell out as
    An audit drove every mode through the real engine and recomputed the
    notebook's headline numbers by hand. Forty-three findings, and some of
    them would have put wrong numbers in the thesis.
    The worst was a Force Pilot within-block check that could only ever
    return zero. The battery climbs the twelve-wave ladder once in a fixed
    order, so level and run index correlate at 0.997; regressing the
    residual of one on the other is orthogonal by construction. It printed
    a tiny number and a verdict of fail, which read as a real null result
    and was arithmetic.
    A block where a board came unplugged counted every trial as analysed,
    inclu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
    [engine.py, test_analysis_gaps.py, test_analysis_logic_gaps.py, test_cohort_notebook.py, test_notebook_matches_software.py, test_rehab_analysis.py]
2026-09-23 Auto-save 2026-09-23 08:52 AWST
    [0804_T6_helddown_newtongraphing_gradualforceincrease_22_20260408.csv, 0804_T6_helddown_newtongraphing_gradualforceincrease_22_session_all_20260408_174442.csv, 0804_T6_heldown_newtongraphing_constantforce_22_20260408.csv, 0804_T7_newtongraphing_constforceV2_22_20260408.csv, 12345_50_20251014.csv, 123_123_session_all_20251015_130755.csv, 1_1_20260512.csv, 1_1_session_all_20260512_125416.csv]
2026-09-23 Seven things at the top level instead of twenty
    The folder is now arranged around what actually gets used. At the top:
    the notebook, the sessions it reads, the two things people are handed,
    the one launcher, and the code in app/.
    Local_Runner.command start the EEG build on this Mac
    analysis/ where results get analysed
    sessions/ recorded sessions
    Installers/ Windows exe and macOS dmg
    EEG_Lab/ copy this folder to the lab PC
    app/ code, config, assets, tests, build scripts
    archive/ old material, nothing live
    The lab folder came up from docs/lab_package, so what goes on the USB
    stick is obvious ra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
2026-09-23 Find the Windows uninstaller rather than assuming its name
    Inno numbers the uninstaller, so unins000.exe is only its name when
    none was there before. Start-Process on a missing path throws and the
    step failed nine seconds in, which read as a broken uninstall when the
    uninstall had not been attempted. It now looks the file up, and prints
    the folder when there isn't one.
2026-09-23 Say where the Windows install check gets to
    The step was failing with no output, so there was nothing to read. It
    now prints what it installed, what it found, and which uninstaller it
    used, and dumps the task when one survives.
2026-09-23 Installers folder holds what people install
    Both installers from the CI build sit where the folder map says they
    do, each beside a short note saying where they come from and that git
    does not keep them. The dmg was checked: it mounts with Finger Rehab
    app and an Applications symlink, which is the drag-to-install shape.
2026-09-23 Every block opens on the recording before anything inside it
    Checked the lab build against Welber's SRT task byte by byte. The wire
    matches: COM10 at 9600 8N1, one raw byte, held, then 0. It is better
    in one place, since his bytes(chr(n), 'UTF-8') would send two bytes
    for any code over 127 and ours sends one for all 39 codes.
    It did not match in order. The engine sends a block start and its GET
    READY in the same frame, and markers that close together queue by
    priority. Block starts sat at the bottom of that list, so the queue
    put GET READY ahead of them and every block on a recording opened with
    a 20 lying just outside the block it belonged to. Anyone cutting a BDF
    from 2xx to 22x lost it.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
2026-09-23 Rhythm can supply error trials to the ERN
    The EEG research plan lists rhythm among the error-rich modes the
    error-related negativity is drawn from, and the ERN is error trials
    against correct ones. Every wrong-finger press in rhythm went out as
    131, idle press, so epoching errors on 110 to 117 found none from
    rhythm at all. The notebook's own code table already listed rhythm as
    sending wrong-press bytes; the software never did.
    Two different things had shared that code. The wrong finger pressed
    while another finger's note was due is a commission error and now goes
    out as 110 plus the lane pressed. A press with no note due in any lane
    is genuinely idle and stays 131. Rhythm only ever looked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
    [eeg_trigger.py, engine.py, test_rhythm_error_markers.py]
2026-09-23 The trigger box port can be picked in the game
    A wrong COM number opens a port list instead of quitting, and the pick
    is saved on the port line of eeg_lab.yaml. Settings has the same list.
    Hand-board discovery and the flasher no longer touch the box's port.
    FRN bytes go out in reaction, chords and force_pilot only, and the
    half ring sends 142. The lab launcher runs from source if Windows
    blocks the exe. CNV and latency notes corrected against BioSemi and
    published measurements.
    [default.yaml, discovery.py, eeg_port.py, eeg_trigger.py, engine.py]
2026-09-23 Wrong-finger bytes go out at the press
    A real-time run of the lab folder in PsychoPy, against a virtual
    trigger box, showed classic's wrong-finger byte on the wire at trial
    close, about a second after the stimulus. Every mode that keeps a
    trial open now marks the wrong press when it lands.
    Also from that run and a review:
    - a feedback glyph cut short by the block end sends no byte
    - the lab build never registers auto-start on the lab PC
    - run_in_psychopy.py installs what PsychoPy lacks beside itself, and a
    run from source saves to the same sessions/ as the exe
    - the trigger box is known by its USB identity, so it never becomes a
    hand board, and bench scripts will not guess between two d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
    [build_lab_package.py, buzz_soak.py, discovery.py, eeg_trigger.py, engine.py, force_check.py]
2026-09-23 Local_Runner starts the normal game from the current code
    This Mac never has an EEG, so the lab settings never load here.
    Recordings go to the top-level sessions/ the notebook reads, through a
    new --data-dir option; after the move into app/ they would have landed
    in app/sessions.
2026-09-23 The lab folder keeps the EEG recordings with the games
    sessions/eeg/ ships in the lab folder. After login the game menu names
    the recording (participant and date) and says where to save it, and
    every game's metadata.json records which recording it belongs to; the
    notebook reports each one as present or missing. The session-start
    byte now goes out with the first game, so ActiView can be started
    after reading the name.
    Mirror marks each hand at its own press, and a set whose first press
    was a wrong finger gets no second, correct byte at close. The lab
    checklist is rewritten for the current flow.
    [build_lab_package.py, eeg_trigger.py, engine.py, test_eeg_notebook.py, test_eeg_recording_file.py, test_lab_package.py, test_mirror_mode.py, test_session_model.py]
2026-09-23 One hand per session, quieter games, a prompt buzz in Syllables
    The hand is picked once after login, and a lone board only offers its
    own hand. Quick calibration checks the hands really are off, then on,
    and skips a hand that is not there. Thresholds after calibration are
    lighter.
    No words after a press in any mode, a grey flash instead of red, no
    thunk, and a banner only at 10, 20, 30, 50, 75 and 100 in a row.
    Reaction shows the RT small in the corner. Skip buttons sit inside the
    rest cards. Results tiles count what went right.
    Syllables drops the warm-up and the model buzz, and buzzes the right
    finger at 3/4 of the fall, fading per word (EEG code 52). Buzz Hunt
    loses the get-ready text a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
    [calibration_profile.py, default.yaml, eeg_trigger.py, engine.py, test_buzz_hunt.py, test_calibration.py]
2026-09-23 Quieter menu music, both hands calibrated for Play all, a check per mode
    Menu music defaults to a quarter of master; in-game music plays at
    full level.
    Play all calibrates every hand the study plays before its first block.
    The study's rhythm block puts the buzz on the beat, so Rh1 and Rh2
    measure synchronisation. Syllables counts a set as prompted only when
    the buzz went out.
    The notebook adds A1, A2, S1 and S2 so all ten modes have a
    pre-specified check, draws the validity table and the P1 take curve,
    and saves figures at 200 dpi. The sitting re-times at medians of 43.7
    to 44.0 minutes.
    [block_music.py, default.yaml, engine.py, menu_music.py, test_cohort_notebook.py, test_force_pilot_music.py, test_menu_music.py, test_study_battery.py]
2026-09-23 Study day fixes from a real-board run
    One-hand blocks on two boards buzz the playing hand's board and ignore
    the resting hand's presses.
    Play all needs both boards and says which is missing. A step waits
    for a dropped board instead of starting or being skipped, and a step
    that never opened its block stays pending. A hand whose calibration
    was abandoned is offered it again before its next step. S asks before
    skipping, the hub keeps the rest floor, and free picks mid-battery
    carry no phase. After a relaunch Play all skips blocks the code
    finished today. A lone board plugged back in keeps the session hand.
    E3 sets wrong presses on sequence lanes against chance, with an exact
    test.
    [engine.py, simulate_cohort.py, test_cohort_notebook.py, test_trial_workflow.py]
2026-09-23 Chords: buzz every finger of a chord together
    motor.chord_buzz: together starts all of a chord's motors at once and
    holds them for the cue length. The one-at-a-time arpeggio stays as
    the arpeggio setting for a board that goes weak with several motors
    on.
    [default.yaml, engine.py, test_chords_mode.py, test_hand_support.py]
2026-09-23 Syllables: progressive prompt delay per word
    The prompt buzz starts at 0.6 of the fall for a new word and moves to
    0.75, 0.9, then off as the word is answered right unaided; an error
    or a miss moves it one step back. It never comes before the child's
    own median answer time plus 300 ms. One finger only, as before.
    The lab package test now allows the sessions folder the build ships.
    [default.yaml, eeg_trigger.py, engine.py, test_eeg_contract.py, test_syllables_mode.py]
2026-09-23 One-board study: right hand only, two passes
    Play all runs healthy_one_hand_v2: nine one-hand modes, a rest, then
    Reaction, Force Pilot and Chords again. Every block is the right
    hand; a lone board picked as Left at login is renamed to it. Mirror
    is not played.
    The notebook reads pass 1 for norms and checks, keeps left-handers
    out of pooled numbers and describes them apart, drops the checks one
    board cannot produce with the reason, reads R3 from the two passes,
    and adds a reliability chapter: ICC(2,1) with exact intervals, SEM,
    MDC95 and Bland-Altman for T1 to T5, against the predicted class.
    The design doc, the timing script and the cohort simulator follow the
    new design.
2026-09-23 Serial: a refused port setting no longer kills the board reader
    [test_connection_reliability.py]
2026-09-23 Study day kit, virtual trigger box and the design doc
    [intake_sheet_template.csv]
2026-09-23 Rhythm: read the track through soundfile, so PsychoPy's Python gets the song's beats
2026-09-24 Auto-save 2026-09-24 12:06 AWST
    [audio_latency_20260924_112820.csv, audio_latency_20260924_113021.csv]
2026-09-24 Latency: this laptop's measured sound and buzz delays, loaded per machine
    [audio_latency_20260924_112820.csv, audio_latency_20260924_113021.csv, audio_latency_20260924_121500.csv]
2026-09-24 Board reader: hand over each sample as it arrives
    read(256) waited for 256 bytes on Windows' CH340 driver, so samples reached the game in 60 ms bunches stamped with one time (20 ms bunches on macOS). Reading what is waiting puts a line every 5 ms on both.
2026-09-25 EEG box picker: an Arduino marker taken as a hand board can be moved back
    The lab's marker on COM10 is an Arduino, so hand-board discovery accepts it whenever COM10 is not the configured EEG port. Settings, EEG box now lists the hand boards' ports too; picking one takes it off the hand boards, opens the markers on it, saves it, and starts the hand boards again on the other ports. The lab settings record the device as an Arduino.
2026-09-25 Quick calibration: hands off and resting run on the clock
    Each rest step now gives 5 s of heads-up on the ring, then captures for 3 s, whatever the pads read. The gate that waited for the pads to look still and loaded, named fingers and offered Enter stalled players who were doing it right. Only a silent board holds a step.
    [default.yaml, test_quick_calibration.py, test_quick_calibration_states.py]
2026-09-25 Feedback flash ends at the next cue, in every game
    Adaptive fires cues on a beat from the previous cue, so at a quick pace the next cue came 27 ms after a correct press with its 0.4 s green still up, and on the same finger the flash hid the cue. Every cue now ends the tiles' flashes and halos. In the lab build the delayed ring no longer re-flashes the tile, and a ring still waiting when a new cue fires is dropped with its byte.
    [engine.py, test_outcome_flash_ends_at_cue.py]
2026-09-25 Force Pilot: score from the game's own zero, and the Parkinson's measures
    Real ladder runs showed the notebook zeroing each run on a finger already pressing toward the first hold, up to 5.6% of max off the game's score. The game now logs the zero it used, older runs rebuild it where the announce card opened, and a finger flying two levels in a row keeps its rested zero. The lag estimator read 0 ms on every ramp wave; it now takes a Pearson r over the overlap at each lag, and F2 reads the non-periodic waves. Press against release reads the symmetric shapes, idle runs are left out, and a new chapter reports what Parkinson's force studies measure beside the published healthy values.
2026-09-25 Syllables: set up by age, with a recording kit for the voice
    The study's block is pinned to the classic profile and does not change. Outside it the intake age picks a profile: 6-9 fades the print above rung 3, 10 to 15 adds faster falls and derived and made-up words, and adults hear the word without seeing it, play without the buzz and have their fall time measured by a 4-down-1-up staircase. A script builds the teen, adult and made-up word pools. The recording kit writes the reading script with a spelling-pronunciation hint per chunk, cuts the recorded pages into levelled files and lists what is missing, and the game plays a recorded chunk in every word that holds it. The notebook keeps S1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
    [build_syllables_pools.py, default.yaml, engine.py, syllables_recording_kit.py, test_study_battery.py, test_syllables_profiles.py, test_syllables_recording_kit.py]
2026-09-25 READMEs: a clearer front page and a short guide in every folder
    [test_lab_package.py, test_readme.py]
2026-09-25 README: real game screenshots and the device drawing
    The hub leads, then six games in play above the game table. The black
    Reaction frame is gone. The device drawing from the archive goes in How
    it works and the arduino README. The results title moves down 10 px so
    the music pill no longer touches it.
    [test_readme.py]
2026-09-25 Results: one HIT RATE card per list
    Adaptive's second HIT RATE becomes LOWEST PACE and the default list's
    becomes BEST STREAK; the finished screen keeps its three numbers. The
    block summary's peak_streak now counts a best run still going when the
    block ends (it was one short). A test fails if any mode repeats a card.
    [engine.py, test_block_summary.py, test_session_flow.py]
2026-09-25 Notebook: Force Pilot example legend under the axes
    Its default spot printed over the first segment name along the top
    edge. It now sits in one row below the axis title.
2026-09-26 Syllables: con.wav is con_.wav, so Windows can check it out
    Windows keeps con, prn, aux, nul, com1-9 and lpt1-9 for devices, so git
    there refused chunks/con.wav and both builds stopped at checkout. The
    game, the recording kit and the voice script now take every speech file
    name from one speech_stem, and a test fails on any tracked path Windows
    cannot hold.
    [syllables_recording_kit.py, syllables_tts.py, test_syllables_recording_kit.py, test_syllables_tts.py, test_windows_paths.py]
2026-09-28 Auto-save 2026-09-28 12:15 AWST
    [selected_trials.csv, session_summary.csv]
2026-09-28 Auto-save 2026-09-28 14:17 AWST
    [base.stl, fingers.stl, hand_device_v1.f3d, top.stl]
2026-10-01 Auto-save 2026-10-01 11:19 AWST
    [intake_sheet_template.csv]
2026-10-01 Auto-save 2026-10-01 13:08 AWST
    [intake_sheet_template.csv]
2026-10-01 Auto-save 2026-10-01 17:55 AWST
    [intake_sheet_template.csv]
2026-11-11 Notebook tables print every column outside Jupyter
    pandas 3.1 cut the stored-stats table to the terminal's width and dropped level_final, which has failed one test on CI since 22 October.
2026-11-11 Pin CI's library versions and date a rebuilt release by its build
    A new pandas failed one test on 22 October and held the release back for three weeks, and a rebuilt release kept showing the day it was first published.
