basil2fxs/Hand-Rehab-Thesis/(notices)

Notices in the files:
app/docs/research/new_modes/carpal-nerve.md:
the thesis should cite as open science territory: a cheap home device that measures TDT
app/docs/research/deep/buzz_hunt.md:
Not re-read here and left as the code and design cite them: Levitt 1971 and Leek 2001 (staircases, gap stage), the duration difference limen study (PMC4439551), Borngraber et al.
